wdxzf/High-Angle-Lotus-Harvester/README.md

# High-Angle-Lotus-Harvester
大角度冲刷式采收一体莲藕收获装置│机创国家二·等奖作品
