wdxzf/High-Angle-Lotus-Harvester/大角度冲刷式采收一体莲藕（视频图片PPT）/样机实物图片/样机室内模拟图.jpg

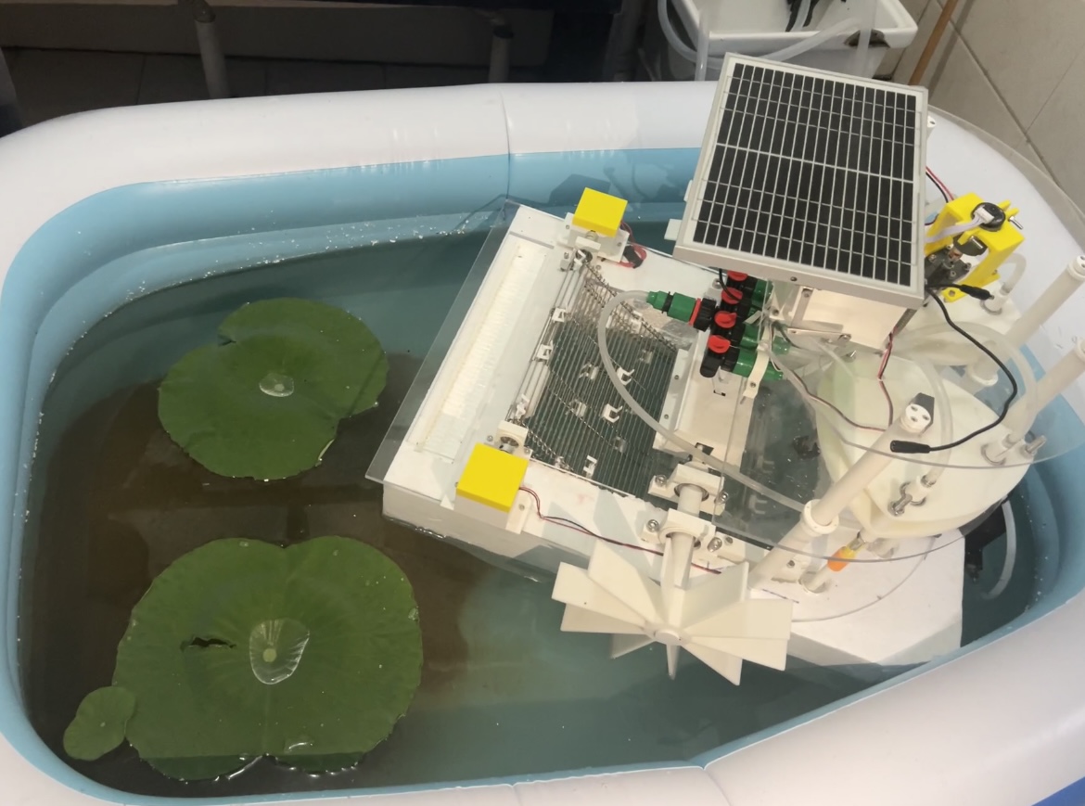
大角度冲刷式采收一体莲藕（视频图片PPT）/样机实物图片/样机室内模拟图.jpg
