wdxzf/High-Angle-Lotus-Harvester/大角度冲刷式采收一体莲藕收获装置三维/零件图/轴承盖.SLDPRT

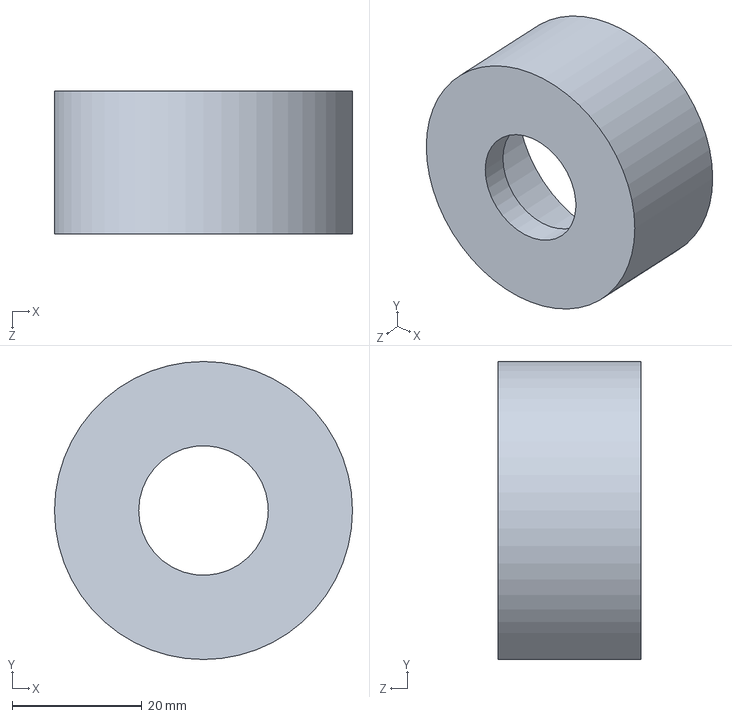
[picture p54: CAD file, 2024-09-17]
大角度冲刷式采收一体莲藕收获装置三维/零件图/轴承盖.SLDPRT
46.0 x 46.0 x 22.0 mm
