wdxzf/High-Angle-Lotus-Harvester/大角度冲刷式采收一体莲藕收获装置三维/零件图/圆柱齿轮轴改后.SLDPRT

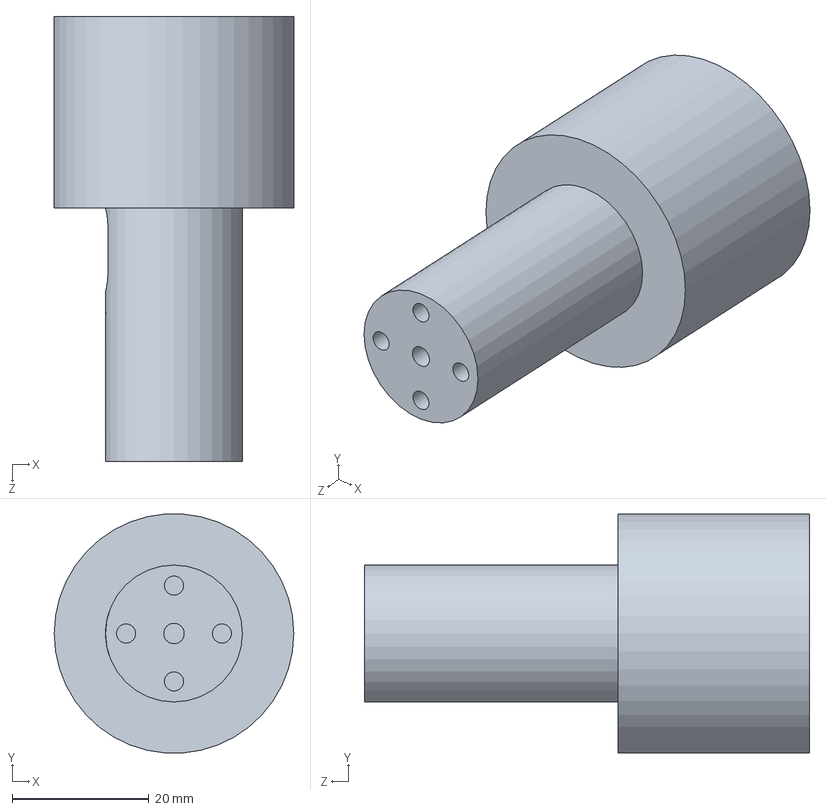
[picture p56: CAD file, 2024-09-17]
大角度冲刷式采收一体莲藕收获装置三维/零件图/圆柱齿轮轴改后.SLDPRT
35.0 x 34.9 x 65.0 mm
