wdxzf/High-Angle-Lotus-Harvester/大角度冲刷式采收一体莲藕收获装置三维/零件图/联轴器.sldprt

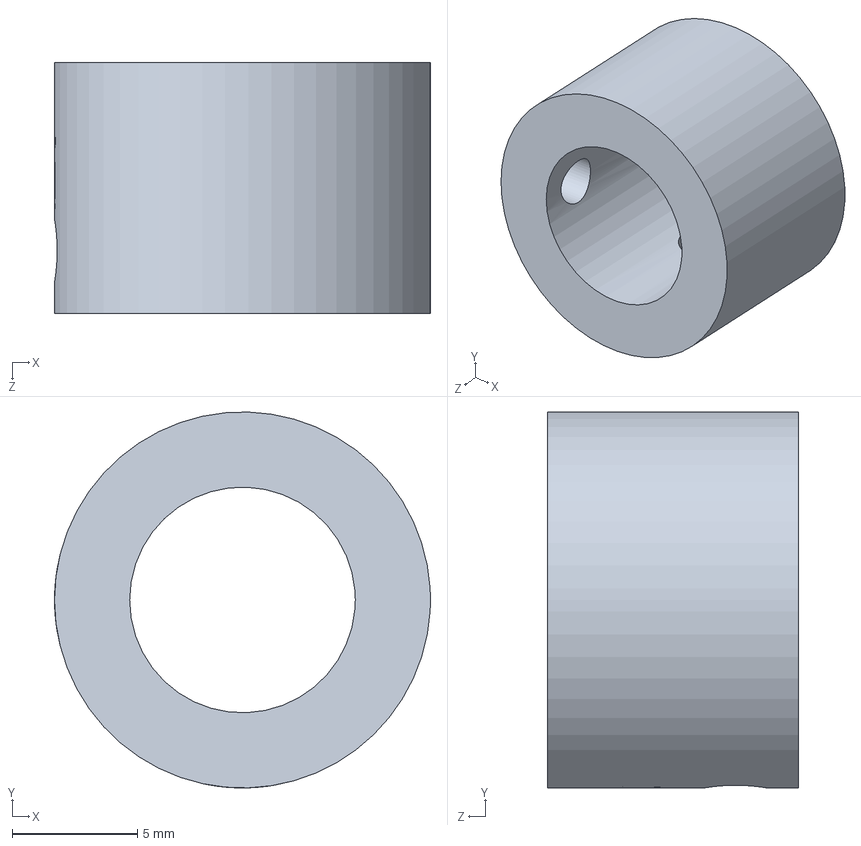
[picture p59: CAD file, 2024-09-17]
大角度冲刷式采收一体莲藕收获装置三维/零件图/联轴器.sldprt
15.0 x 15.0 x 10.0 mm
