wdxzf/High-Angle-Lotus-Harvester/大角度冲刷式采收一体莲藕收获装置三维/零件图/推拉杆轴杆.SLDPRT

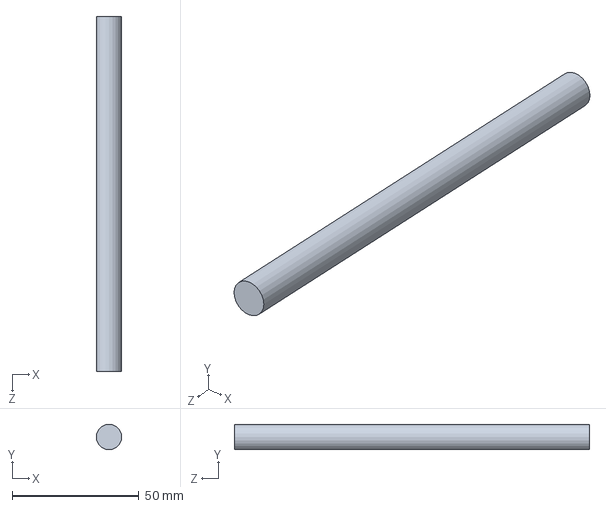
[picture p60: CAD file, 2024-09-17]
大角度冲刷式采收一体莲藕收获装置三维/零件图/推拉杆轴杆.SLDPRT
10.0 x 10.0 x 140.0 mm
