wdxzf/High-Angle-Lotus-Harvester/大角度冲刷式采收一体莲藕收获装置三维/零件图/推拉杆飞机.SLDPRT

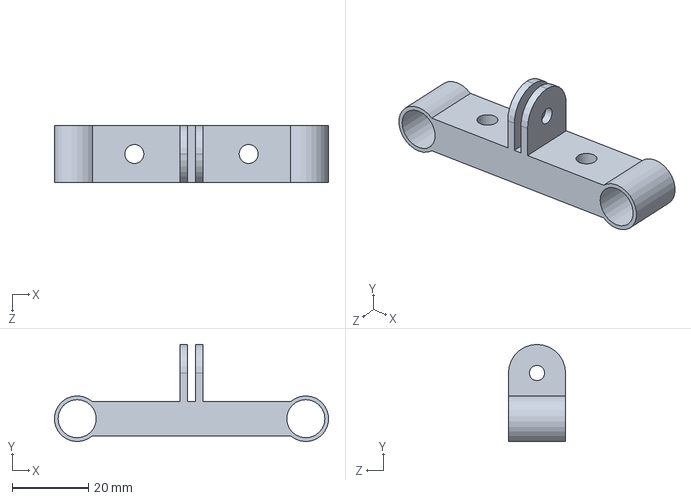
[picture p61: CAD file, 2024-09-17]
大角度冲刷式采收一体莲藕收获装置三维/零件图/推拉杆飞机.SLDPRT
71.9 x 25.5 x 15.0 mm
