wdxzf/High-Angle-Lotus-Harvester/大角度冲刷式采收一体莲藕收获装置三维/零件图/推拉杆小飞机尾翼.SLDPRT

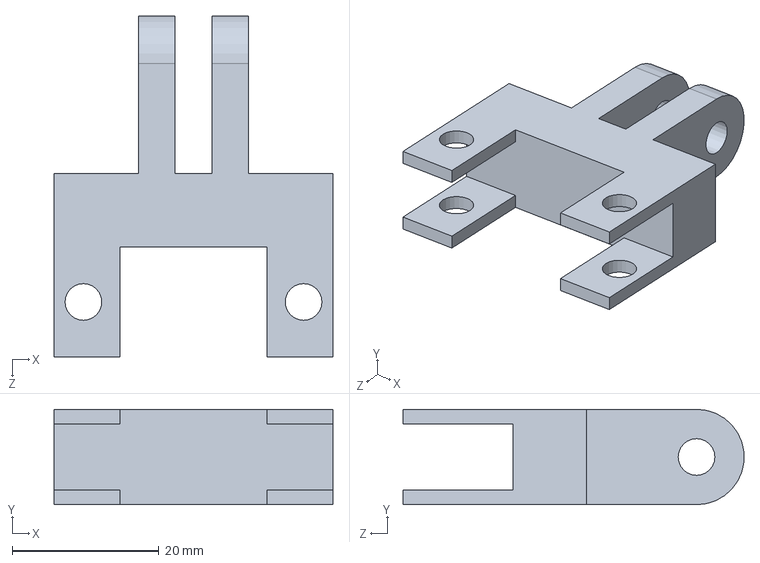
[picture p62: CAD file, 2024-09-17]
大角度冲刷式采收一体莲藕收获装置三维/零件图/推拉杆小飞机尾翼.SLDPRT
38.0 x 13.0 x 46.5 mm
