wdxzf/High-Angle-Lotus-Harvester/大角度冲刷式采收一体莲藕收获装置三维/零件图/履带传动轴.SLDPRT

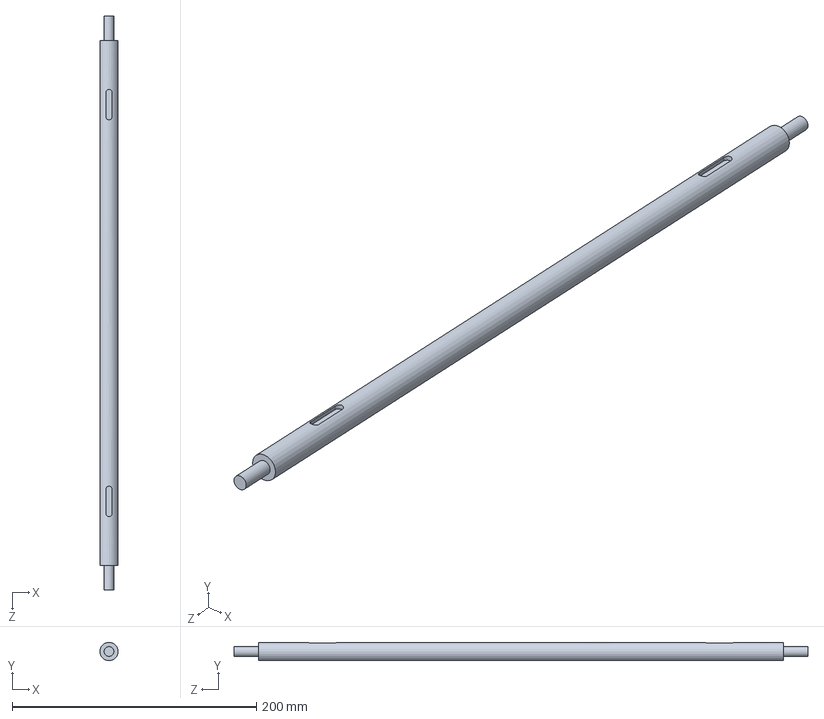
[picture p63: CAD file, 2024-09-17]
大角度冲刷式采收一体莲藕收获装置三维/零件图/履带传动轴.SLDPRT
15.0 x 15.0 x 470.0 mm
