wdxzf/High-Angle-Lotus-Harvester/大角度冲刷式采收一体莲藕收获装置三维/零件图/驱动   圆柱齿轮40×2.5.SLDPRT

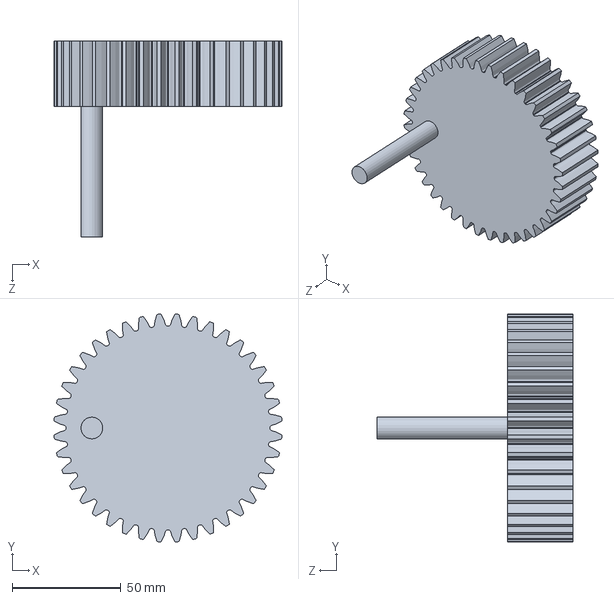
[picture p65: CAD file, 2024-09-17]
大角度冲刷式采收一体莲藕收获装置三维/零件图/驱动 圆柱齿轮40×2.5.SLDPRT
104.8 x 104.8 x 90.0 mm
