wdxzf/High-Angle-Lotus-Harvester/大角度冲刷式采收一体莲藕收获装置三维/零件图/控制板外壳左上盖.SLDPRT

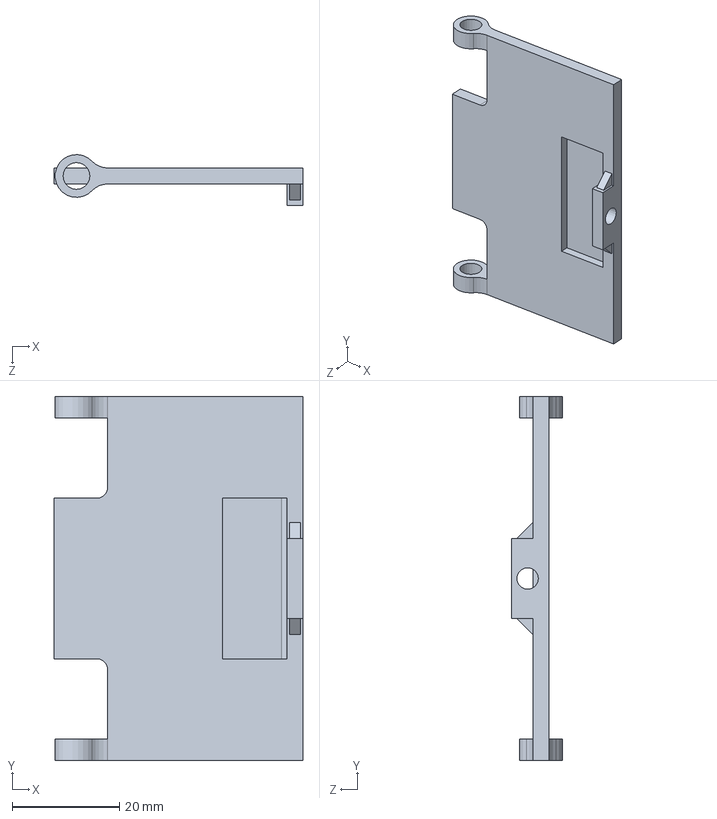
[picture p66: CAD file, 2024-09-17]
大角度冲刷式采收一体莲藕收获装置三维/零件图/控制板外壳左上盖.SLDPRT
46.5 x 68.0 x 9.49 mm
