wdxzf/High-Angle-Lotus-Harvester/大角度冲刷式采收一体莲藕收获装置三维/零件图/三脚架.SLDPRT

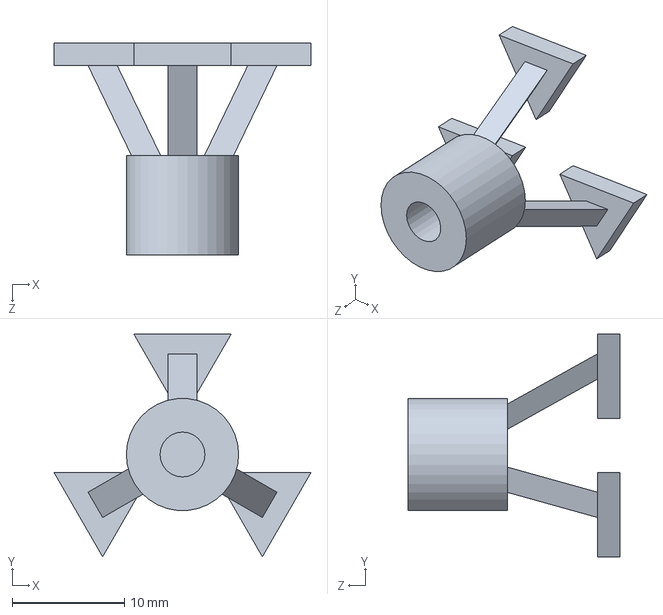
[picture p67: CAD file, 2024-09-17]
大角度冲刷式采收一体莲藕收获装置三维/零件图/三脚架.SLDPRT
22.9 x 19.8 x 18.9 mm
