wdxzf/High-Angle-Lotus-Harvester/大角度冲刷式采收一体莲藕收获装置三维/零件图/动力圆柱齿轮35×2.SLDPRT

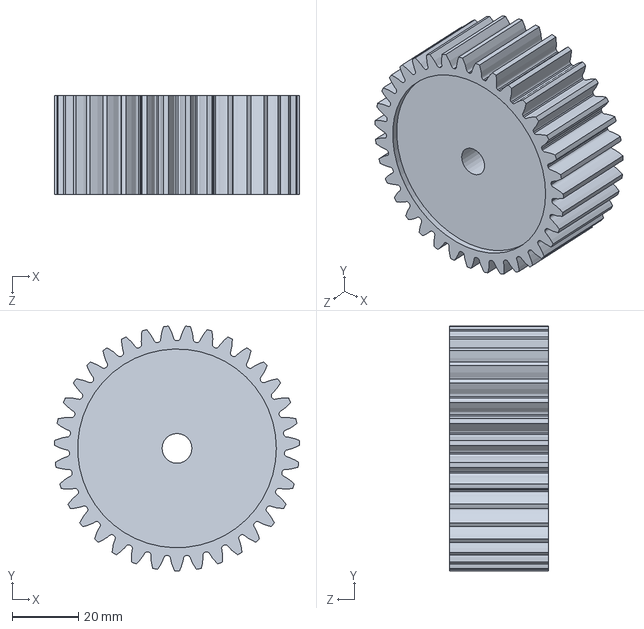
[picture p68: CAD file, 2024-09-17]
大角度冲刷式采收一体莲藕收获装置三维/零件图/动力圆柱齿轮35×2.SLDPRT
74.0 x 73.9 x 30.0 mm
