wdxzf/High-Angle-Lotus-Harvester/大角度冲刷式采收一体莲藕收获装置三维/零件图/套筒.SLDPRT

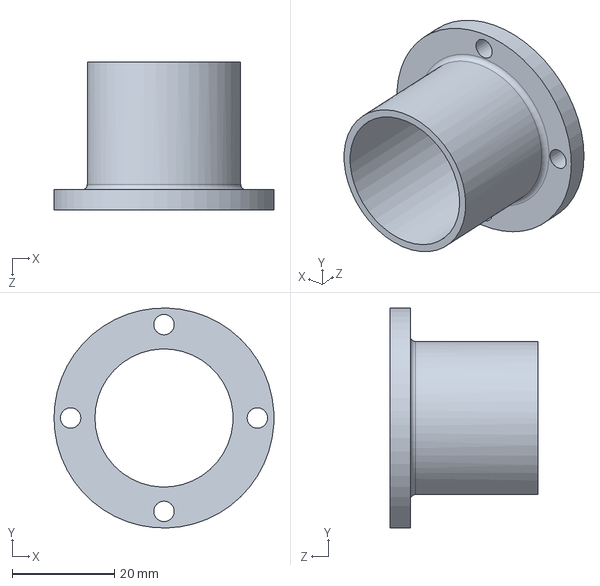
[picture p69: CAD file, 2024-09-17]
大角度冲刷式采收一体莲藕收获装置三维/零件图/套筒.SLDPRT
43.0 x 43.0 x 29.0 mm
