wdxzf/High-Angle-Lotus-Harvester/大角度冲刷式采收一体莲藕收获装置三维/零件图/直角弯头.SLDPRT

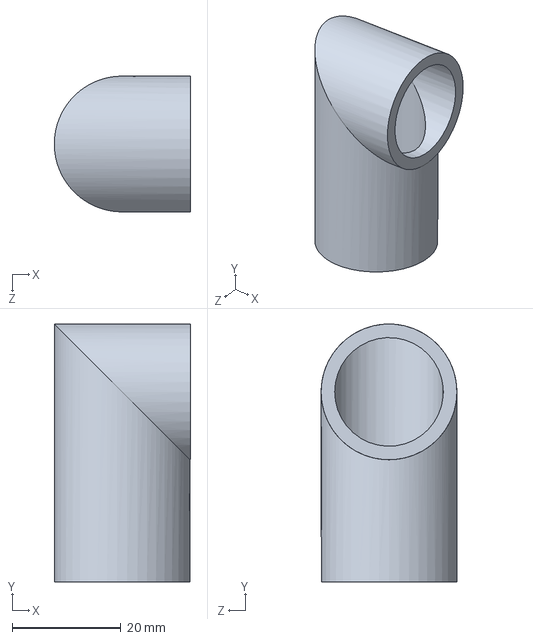
[picture p70: CAD file, 2024-09-17]
大角度冲刷式采收一体莲藕收获装置三维/零件图/直角弯头.SLDPRT
25.1 x 47.5 x 25.0 mm
