wdxzf/High-Angle-Lotus-Harvester/大角度冲刷式采收一体莲藕收获装置三维/零件图/大轮.SLDPRT

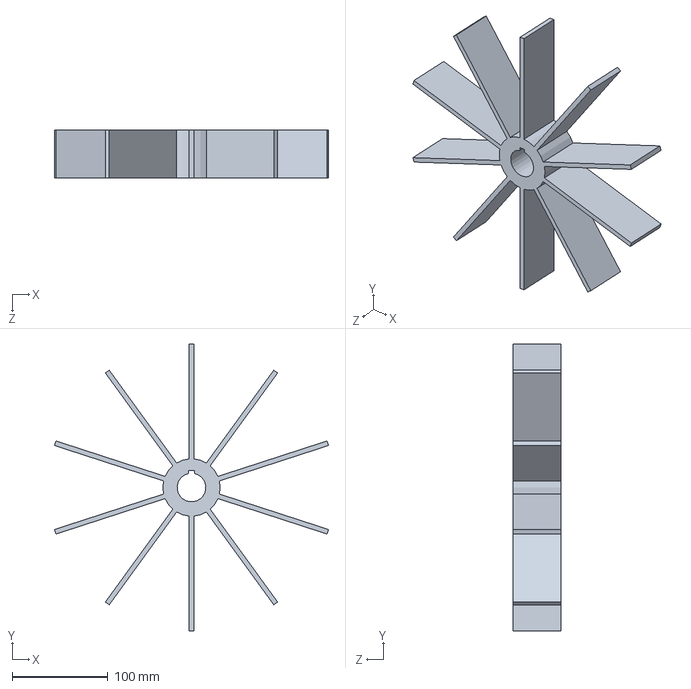
[picture p71: CAD file, 2024-09-17]
大角度冲刷式采收一体莲藕收获装置三维/零件图/大轮.SLDPRT
286.9 x 300.0 x 50.0 mm
