wdxzf/High-Angle-Lotus-Harvester/大角度冲刷式采收一体莲藕收获装置三维/零件图/6006z轴承盖.SLDPRT

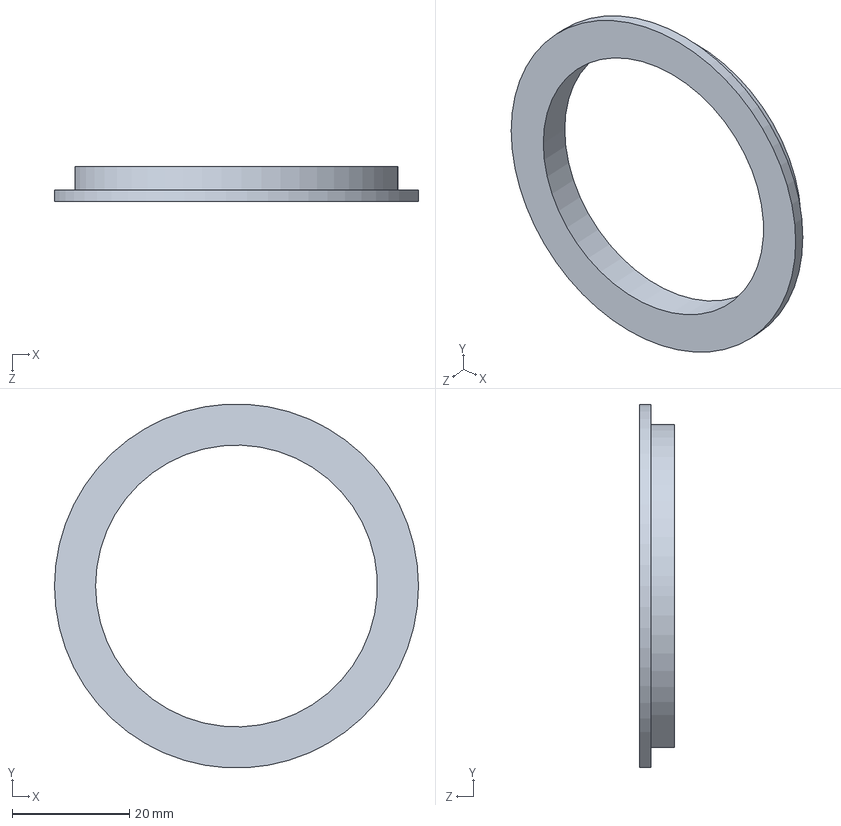
[picture p72: CAD file, 2024-09-17]
大角度冲刷式采收一体莲藕收获装置三维/零件图/6006z轴承盖.SLDPRT
62.0 x 61.9 x 6.00 mm
