wdxzf/High-Angle-Lotus-Harvester/大角度冲刷式采收一体莲藕收获装置三维/零件图/推拉杆驱动连杆.SLDPRT

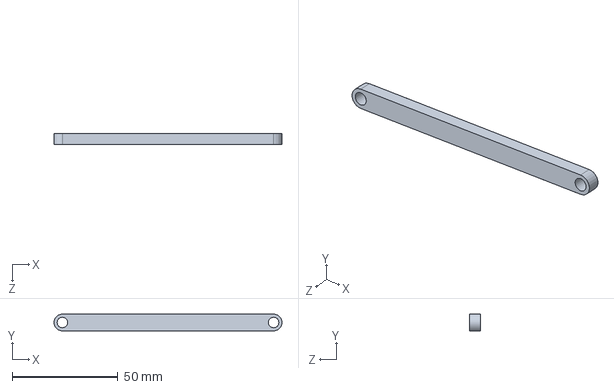
[picture p73: CAD file, 2024-09-17]
大角度冲刷式采收一体莲藕收获装置三维/零件图/推拉杆驱动连杆.SLDPRT
108.0 x 8.00 x 5.00 mm
