wdxzf/High-Angle-Lotus-Harvester/大角度冲刷式采收一体莲藕收获装置三维/零件图/圆柱齿轮25×2.5.SLDPRT

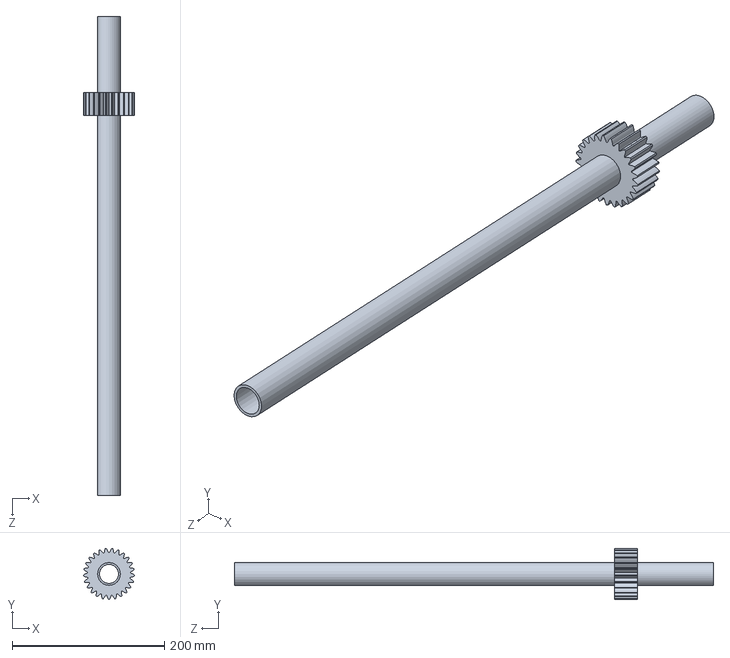
[picture p74: CAD file, 2024-09-17]
大角度冲刷式采收一体莲藕收获装置三维/零件图/圆柱齿轮25×2.5.SLDPRT
67.4 x 67.3 x 630.0 mm
