wdxzf/High-Angle-Lotus-Harvester/大角度冲刷式采收一体莲藕收获装置三维/零件图/导向板.SLDPRT

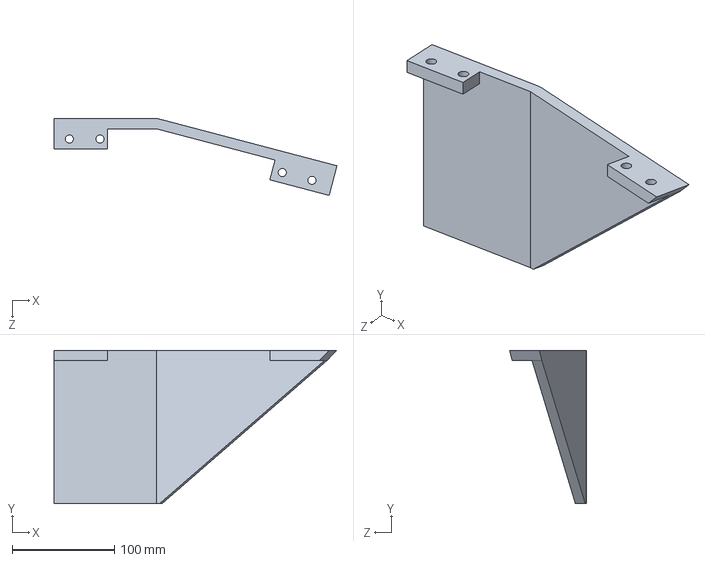
[picture p75: CAD file, 2024-09-17]
大角度冲刷式采收一体莲藕收获装置三维/零件图/导向板.SLDPRT
276.7 x 150.0 x 75.2 mm
