wdxzf/High-Angle-Lotus-Harvester/大角度冲刷式采收一体莲藕收获装置三维/零件图/蜗轮28×1.SLDPRT

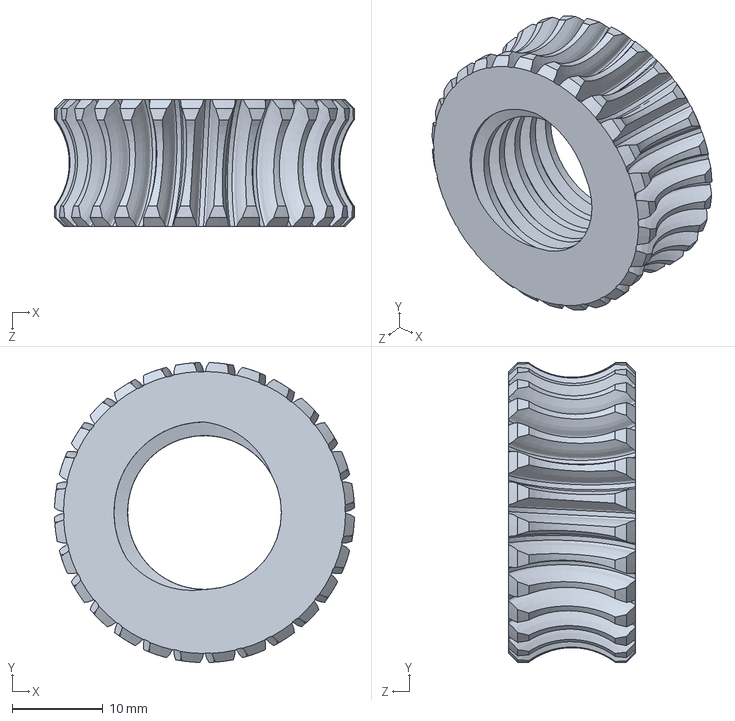
[picture p77: CAD file, 2024-09-17]
大角度冲刷式采收一体莲藕收获装置三维/零件图/蜗轮28×1.SLDPRT
33.1 x 33.1 x 14.0 mm
