wdxzf/High-Angle-Lotus-Harvester/大角度冲刷式采收一体莲藕收获装置三维/零件图/履带轴承座垫高.SLDPRT

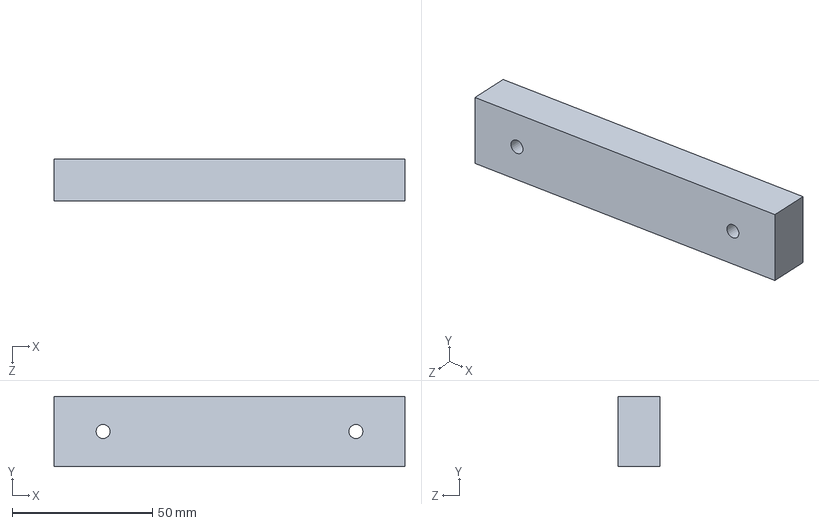
[picture p78: CAD file, 2024-09-17]
大角度冲刷式采收一体莲藕收获装置三维/零件图/履带轴承座垫高.SLDPRT
125.0 x 25.0 x 15.0 mm
