wdxzf/High-Angle-Lotus-Harvester/大角度冲刷式采收一体莲藕收获装置三维/零件图/圆柱齿轮59×2.5改.SLDPRT

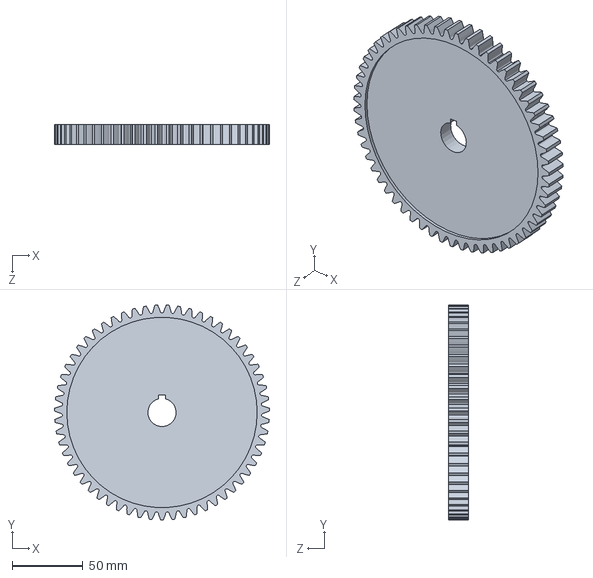
[picture p79: CAD file, 2024-09-17]
大角度冲刷式采收一体莲藕收获装置三维/零件图/圆柱齿轮59×2.5改.SLDPRT
152.5 x 152.4 x 14.0 mm
