wdxzf/High-Angle-Lotus-Harvester/大角度冲刷式采收一体莲藕收获装置三维/零件图/动力外壳.SLDPRT

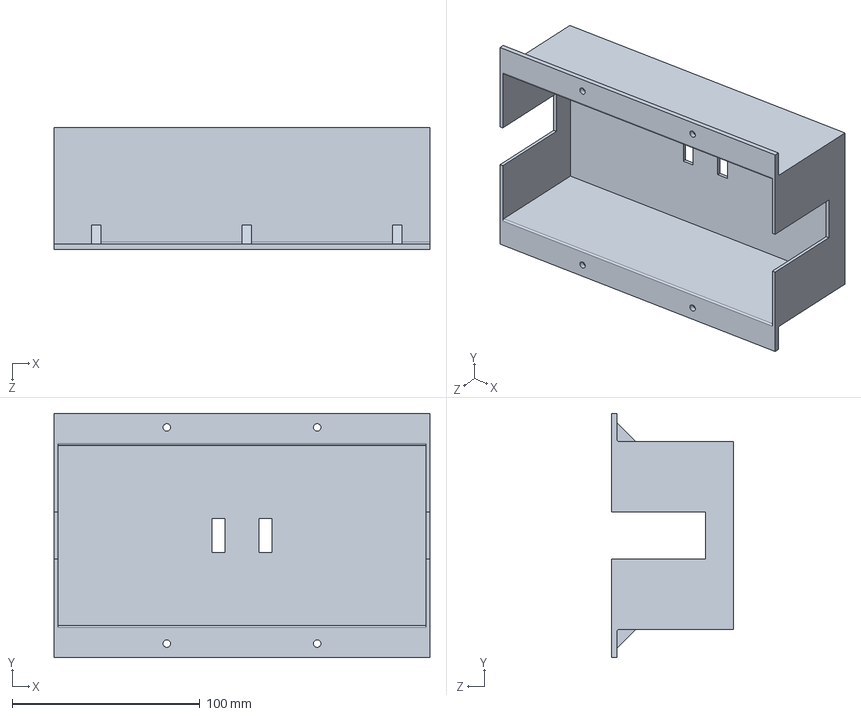
[picture p80: CAD file, 2024-09-17]
大角度冲刷式采收一体莲藕收获装置三维/零件图/动力外壳.SLDPRT
200.0 x 130.0 x 65.0 mm
