wdxzf/High-Angle-Lotus-Harvester/大角度冲刷式采收一体莲藕收获装置三维/零件图/固定台右高.SLDPRT

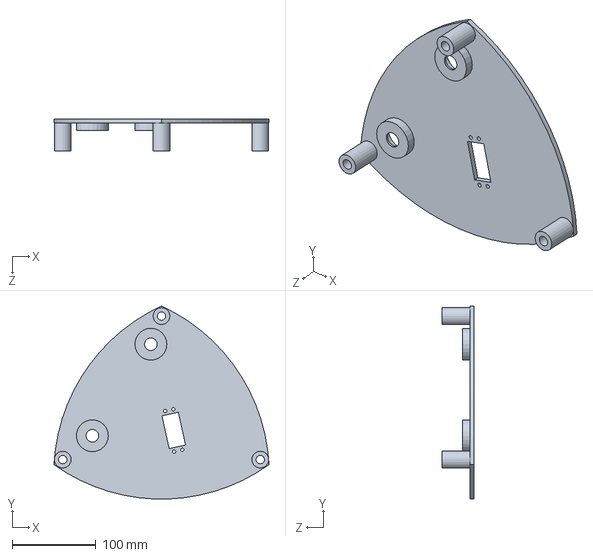
[picture p81: CAD file, 2024-09-17]
大角度冲刷式采收一体莲藕收获装置三维/零件图/固定台右高.SLDPRT
256.0 x 229.8 x 38.2 mm
