wdxzf/High-Angle-Lotus-Harvester/大角度冲刷式采收一体莲藕收获装置三维/零件图/喷管轴承.step

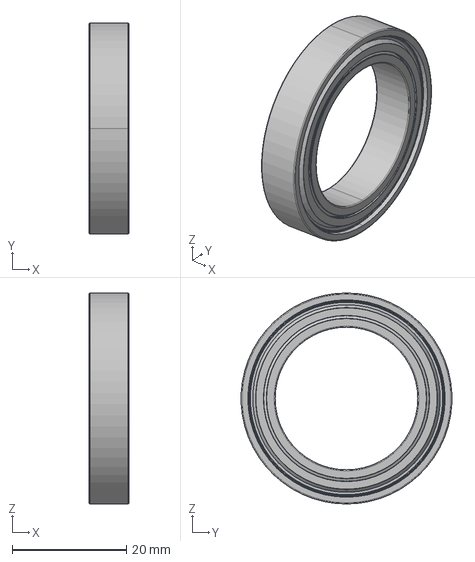
[picture p82: CAD file, 2024-09-17]
大角度冲刷式采收一体莲藕收获装置三维/零件图/喷管轴承.step
7.00 x 36.9 x 37.0 mm
