wdxzf/High-Angle-Lotus-Harvester/大角度冲刷式采收一体莲藕收获装置三维/零件图/喷管转动驱动  圆柱齿轮30×2.5.SLDPRT

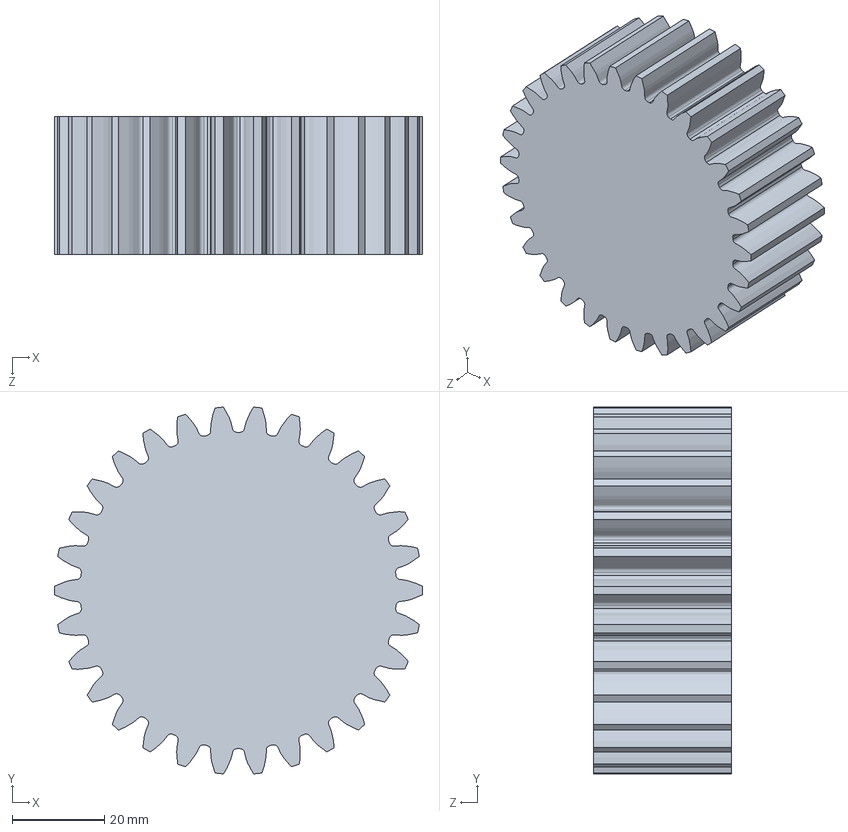
[picture p83: CAD file, 2024-09-17]
大角度冲刷式采收一体莲藕收获装置三维/零件图/喷管转动驱动 圆柱齿轮30×2.5.SLDPRT
80.0 x 79.7 x 30.0 mm
