wdxzf/High-Angle-Lotus-Harvester/大角度冲刷式采收一体莲藕收获装置三维/零件图/水管.SLDPRT

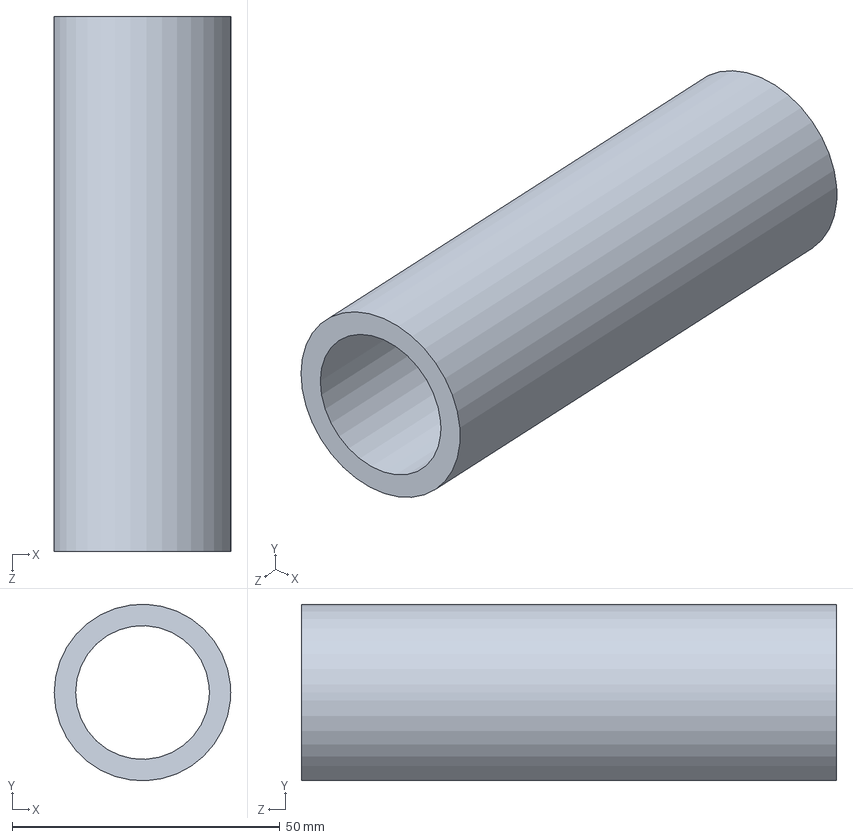
[picture p84: CAD file, 2024-09-17]
大角度冲刷式采收一体莲藕收获装置三维/零件图/水管.SLDPRT
33.0 x 33.0 x 100.0 mm
