wdxzf/High-Angle-Lotus-Harvester/大角度冲刷式采收一体莲藕收获装置三维/零件图/BCTH-M1-E-6006ZZ.step

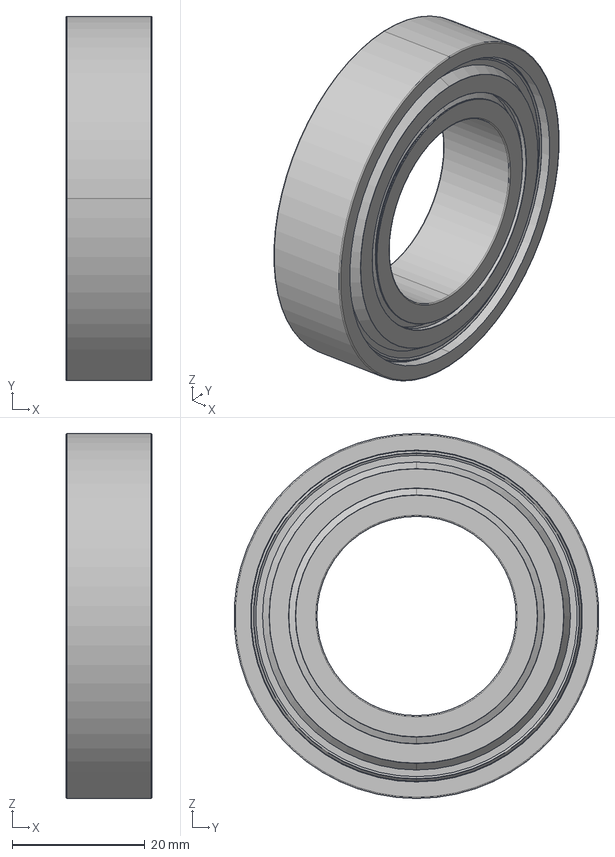
[picture p85: CAD file, 2024-09-17]
大角度冲刷式采收一体莲藕收获装置三维/零件图/BCTH-M1-E-6006ZZ.step
13.0 x 54.9 x 55.0 mm
