wdxzf/High-Angle-Lotus-Harvester/大角度冲刷式采收一体莲藕收获装置三维/零件图/舵盘.SLDPRT

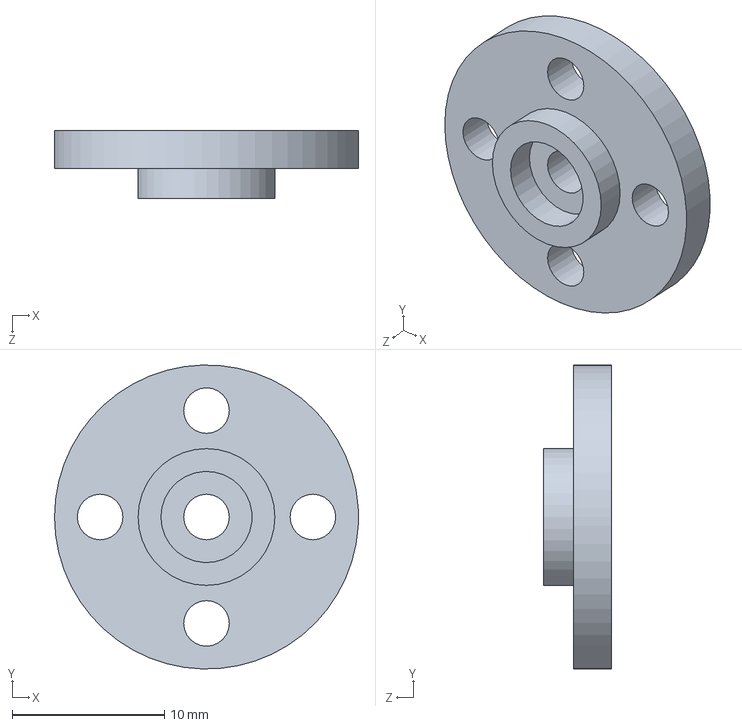
[picture p86: CAD file, 2024-09-17]
大角度冲刷式采收一体莲藕收获装置三维/零件图/舵盘.SLDPRT
20.0 x 20.0 x 4.50 mm
