wdxzf/High-Angle-Lotus-Harvester/大角度冲刷式采收一体莲藕收获装置三维/零件图/垫台.SLDPRT

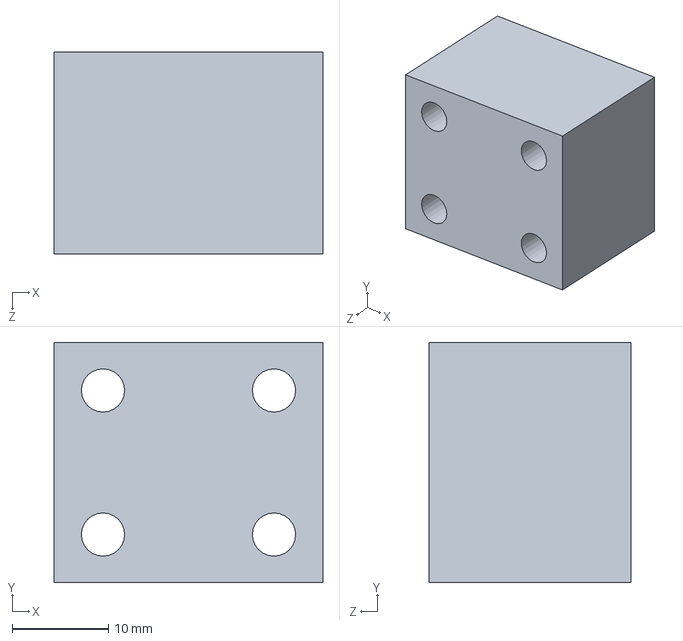
[picture p87: CAD file, 2024-09-17]
大角度冲刷式采收一体莲藕收获装置三维/零件图/垫台.SLDPRT
28.0 x 25.0 x 21.0 mm
