wdxzf/High-Angle-Lotus-Harvester/大角度冲刷式采收一体莲藕收获装置三维/零件图/推拉杆  驱动圆柱齿轮17×2.SLDPRT

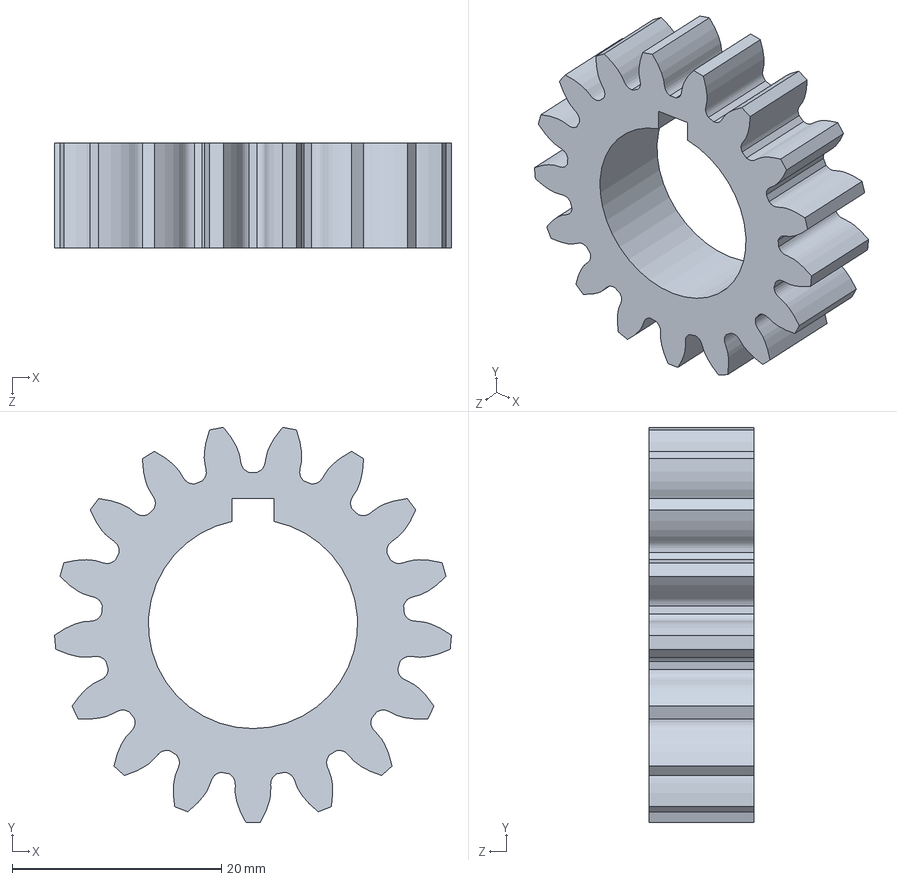
[picture p88: CAD file, 2024-09-17]
大角度冲刷式采收一体莲藕收获装置三维/零件图/推拉杆 驱动圆柱齿轮17×2.SLDPRT
37.9 x 37.8 x 10.0 mm
