wdxzf/High-Angle-Lotus-Harvester/大角度冲刷式采收一体莲藕收获装置三维/零件图/推拉杆支座.SLDPRT

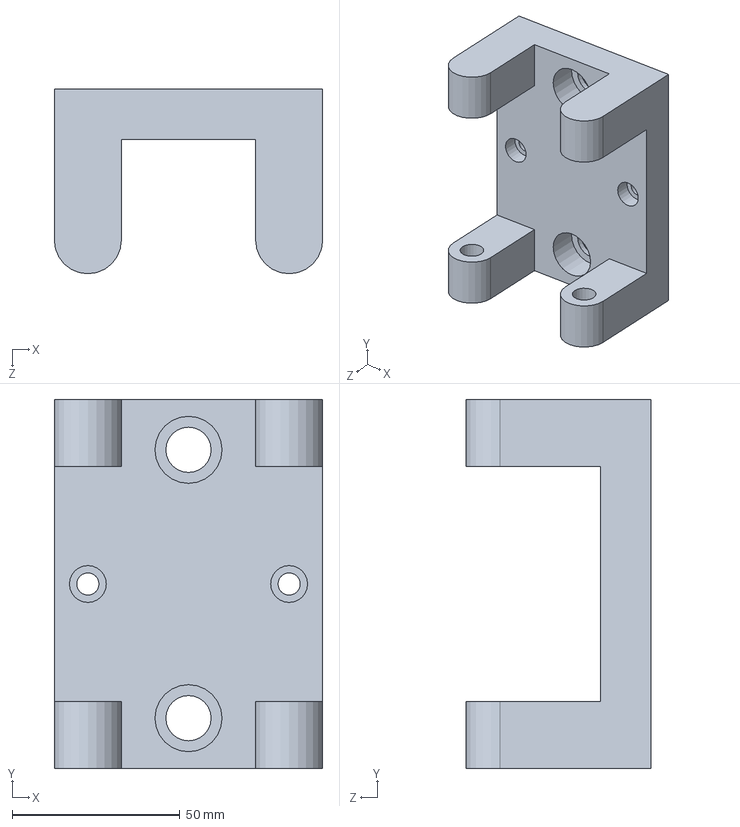
[picture p89: CAD file, 2024-09-17]
大角度冲刷式采收一体莲藕收获装置三维/零件图/推拉杆支座.SLDPRT
80.0 x 110.0 x 55.0 mm
