wdxzf/High-Angle-Lotus-Harvester/大角度冲刷式采收一体莲藕收获装置三维/零件图/直通.SLDPRT

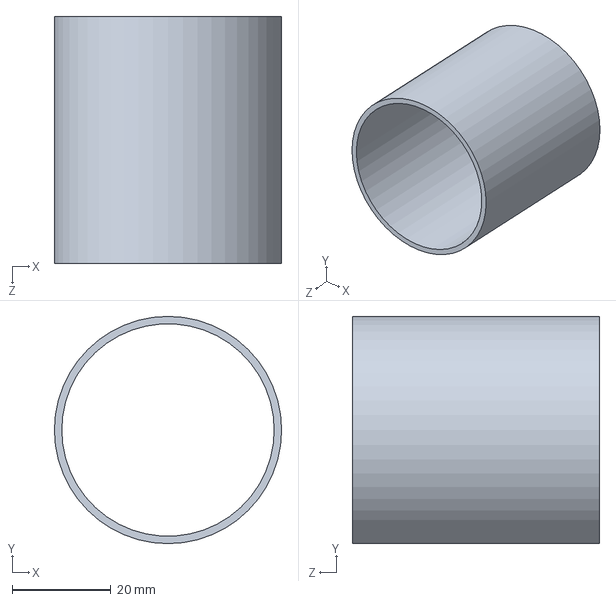
[picture p90: CAD file, 2024-09-17]
大角度冲刷式采收一体莲藕收获装置三维/零件图/直通.SLDPRT
46.0 x 46.0 x 50.0 mm
