wdxzf/High-Angle-Lotus-Harvester/大角度冲刷式采收一体莲藕收获装置三维/零件图/BCTH-M1-E-6302ZZ.step

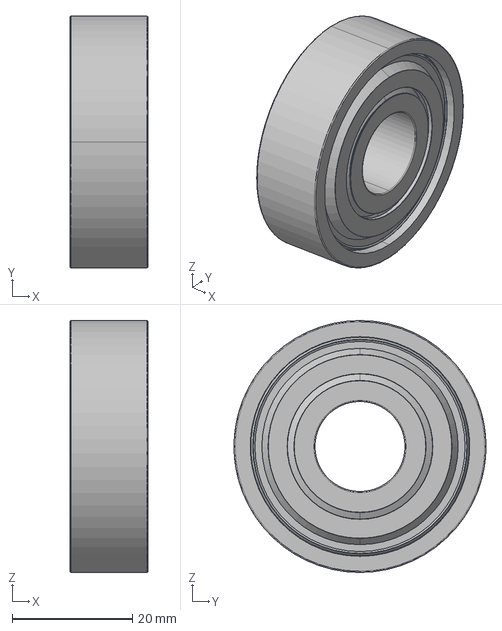
[picture p91: CAD file, 2024-09-17]
大角度冲刷式采收一体莲藕收获装置三维/零件图/BCTH-M1-E-6302ZZ.step
13.0 x 42.0 x 42.0 mm
