wdxzf/High-Angle-Lotus-Harvester/大角度冲刷式采收一体莲藕收获装置三维/零件图/穿线孔.SLDPRT

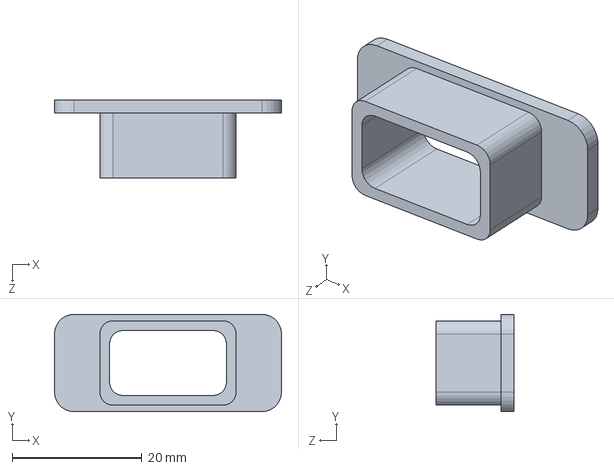
[picture p93: CAD file, 2024-09-17]
大角度冲刷式采收一体莲藕收获装置三维/零件图/穿线孔.SLDPRT
35.0 x 15.0 x 12.0 mm
