wdxzf/High-Angle-Lotus-Harvester/大角度冲刷式采收一体莲藕收获装置三维/零件图/动力电机座下.SLDPRT

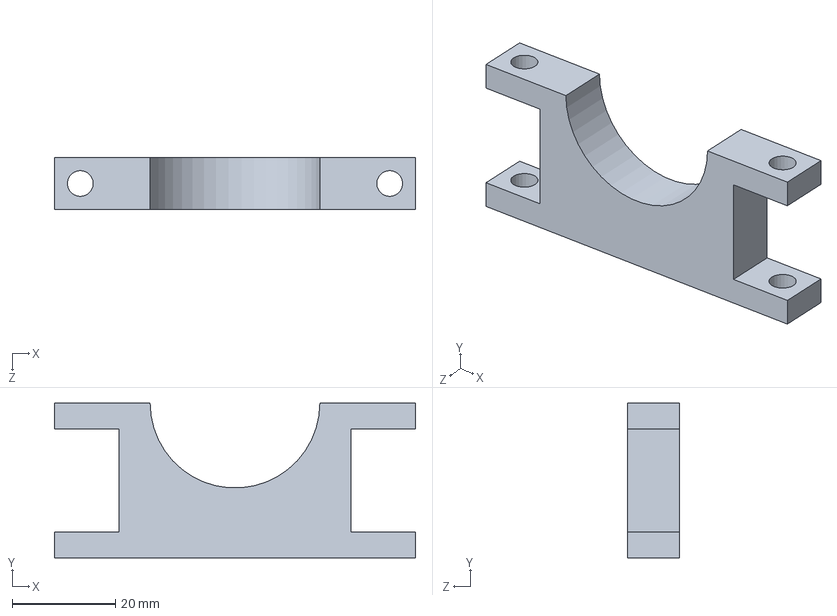
[picture p94: CAD file, 2024-09-17]
大角度冲刷式采收一体莲藕收获装置三维/零件图/动力电机座下.SLDPRT
70.0 x 30.0 x 10.0 mm
