wdxzf/High-Angle-Lotus-Harvester/大角度冲刷式采收一体莲藕收获装置三维/零件图/履带电机右外壳.SLDPRT

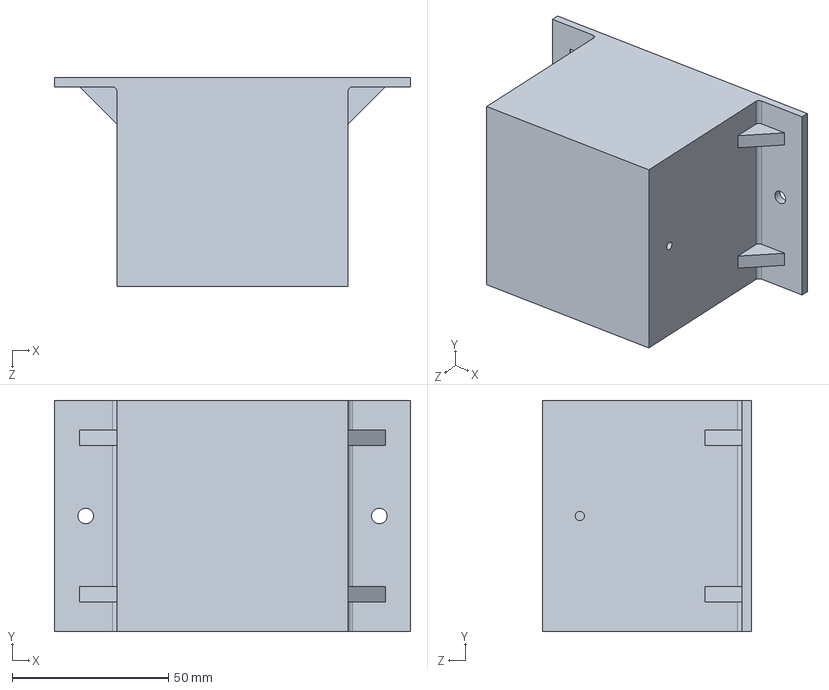
[picture p95: CAD file, 2024-09-17]
大角度冲刷式采收一体莲藕收获装置三维/零件图/履带电机右外壳.SLDPRT
114.0 x 74.0 x 67.0 mm
