wdxzf/High-Angle-Lotus-Harvester/大角度冲刷式采收一体莲藕收获装置三维/零件图/水泵支架上6.SLDPRT

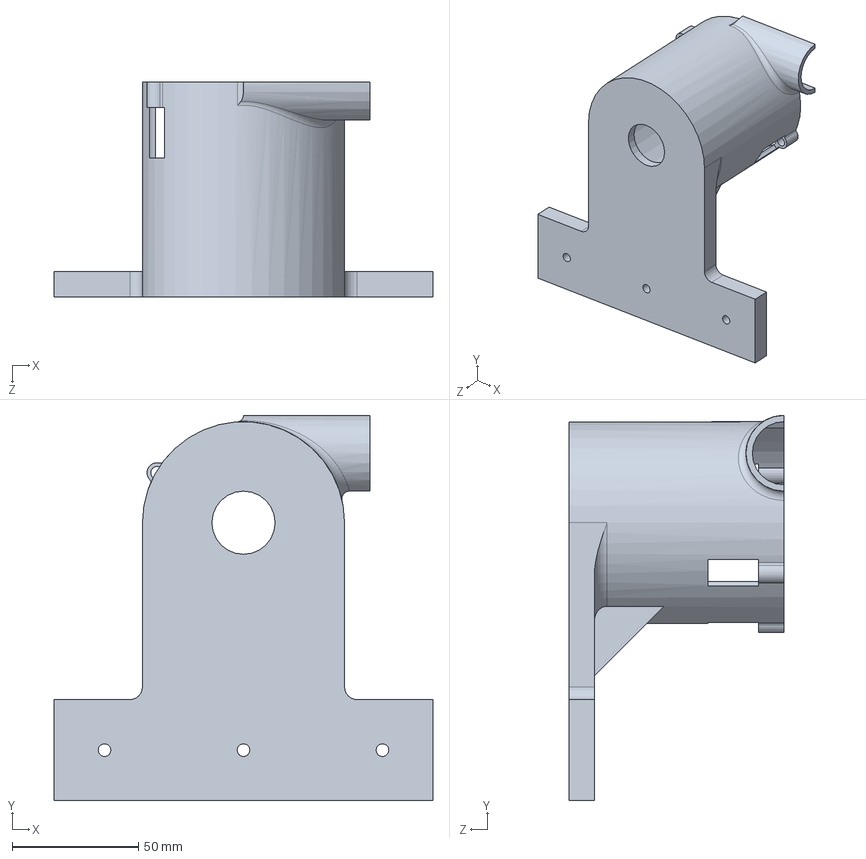
[picture p96: CAD file, 2024-09-17]
大角度冲刷式采收一体莲藕收获装置三维/零件图/水泵支架上6.SLDPRT
150.0 x 152.5 x 85.0 mm
