wdxzf/High-Angle-Lotus-Harvester/大角度冲刷式采收一体莲藕收获装置三维/零件图/履带1.SLDPRT

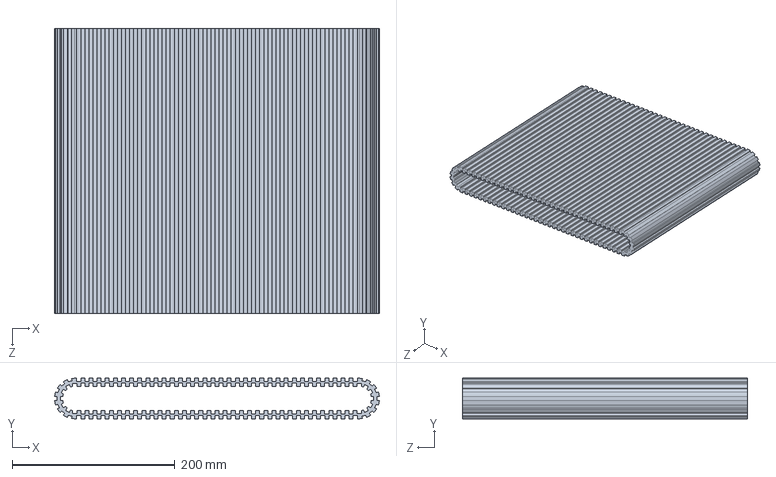
[picture p97: CAD file, 2024-09-17]
大角度冲刷式采收一体莲藕收获装置三维/零件图/履带1.SLDPRT
399.7 x 50.0 x 350.0 mm
