wdxzf/High-Angle-Lotus-Harvester/大角度冲刷式采收一体莲藕收获装置三维/零件图/长6002z轴承盖.SLDPRT

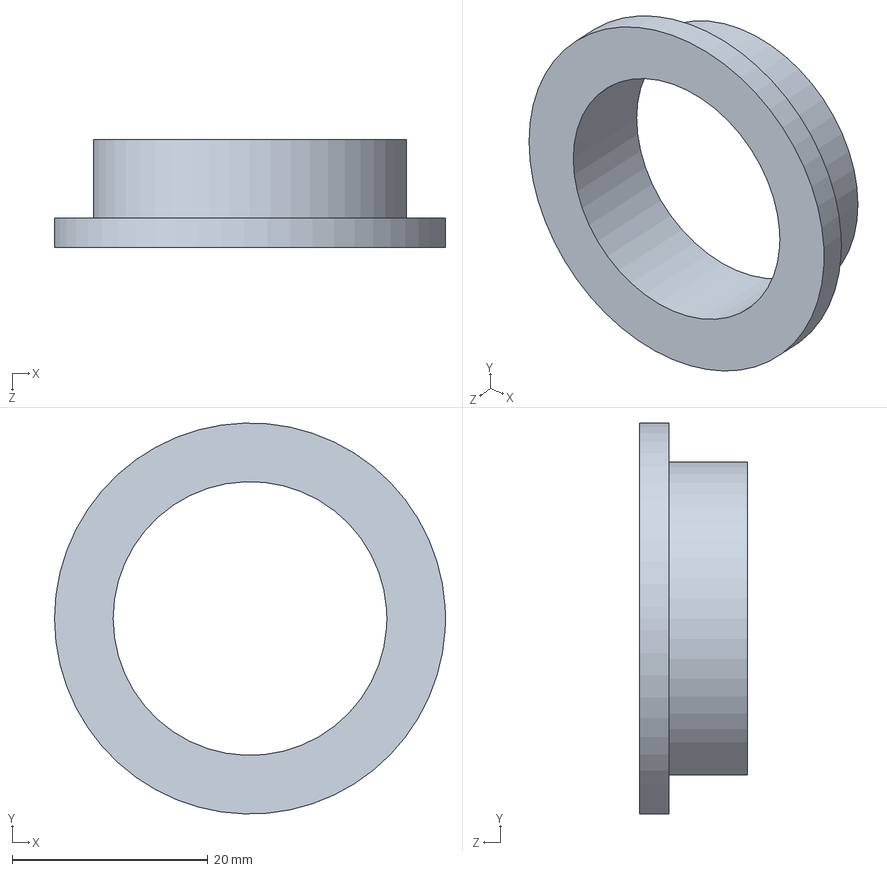
[picture p98: CAD file, 2024-09-17]
大角度冲刷式采收一体莲藕收获装置三维/零件图/长6002z轴承盖.SLDPRT
40.0 x 40.0 x 11.0 mm
