wdxzf/High-Angle-Lotus-Harvester/大角度冲刷式采收一体莲藕收获装置三维/零件图/主动轮  圆柱齿轮30×2.SLDPRT

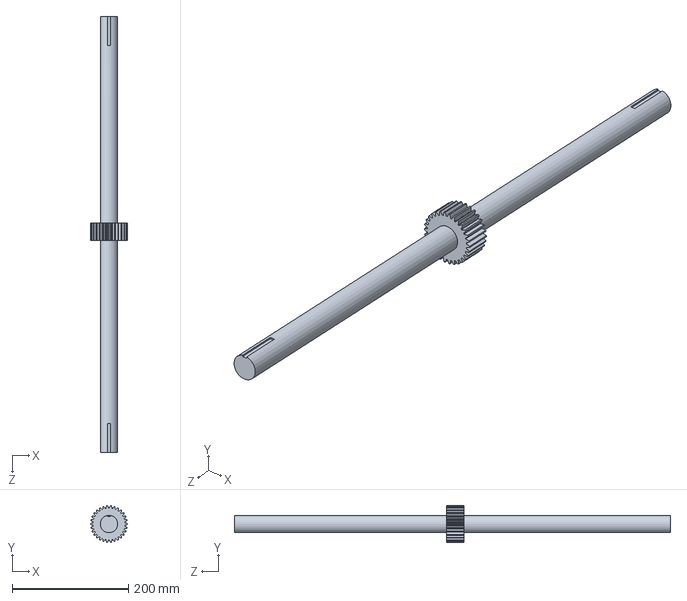
[picture p99: CAD file, 2024-09-17]
大角度冲刷式采收一体莲藕收获装置三维/零件图/主动轮 圆柱齿轮30×2.SLDPRT
64.0 x 63.8 x 750.0 mm
