wdxzf/High-Angle-Lotus-Harvester/大角度冲刷式采收一体莲藕收获装置三维/零件图/喷管连接头.SLDPRT

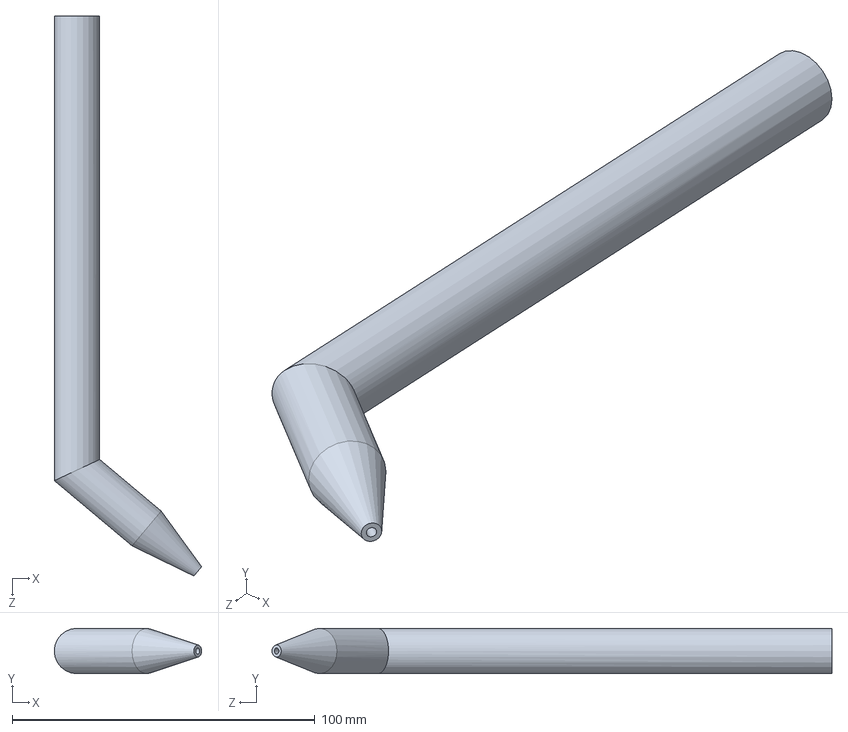
[picture p100: CAD file, 2024-09-17]
大角度冲刷式采收一体莲藕收获装置三维/零件图/喷管连接头.SLDPRT
48.7 x 15.0 x 185.0 mm
