wdxzf/High-Angle-Lotus-Harvester/大角度冲刷式采收一体莲藕收获装置三维/零件图/采藕机外壳.SLDPRT

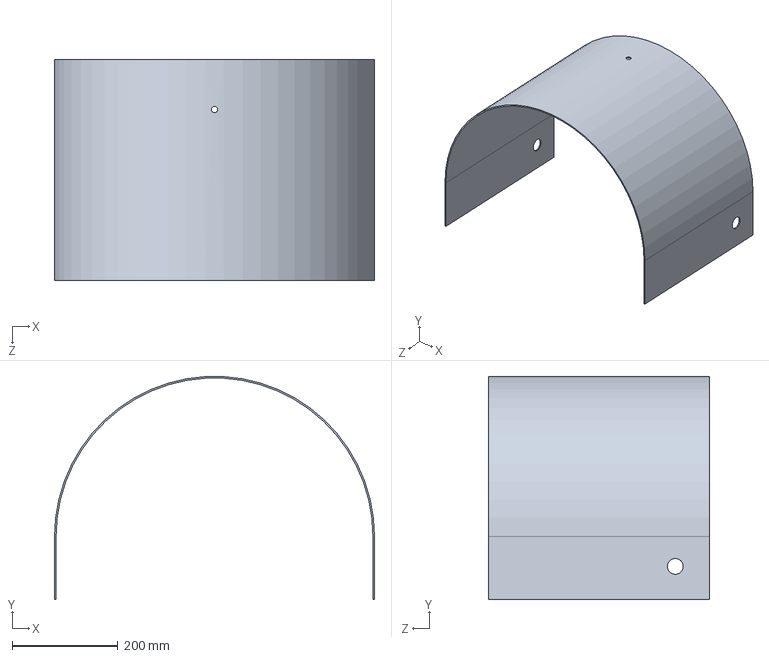
[picture p101: CAD file, 2024-09-17]
大角度冲刷式采收一体莲藕收获装置三维/零件图/采藕机外壳.SLDPRT
606.0 x 423.0 x 419.0 mm
