wdxzf/High-Angle-Lotus-Harvester/大角度冲刷式采收一体莲藕收获装置三维/零件图/短接头.SLDPRT

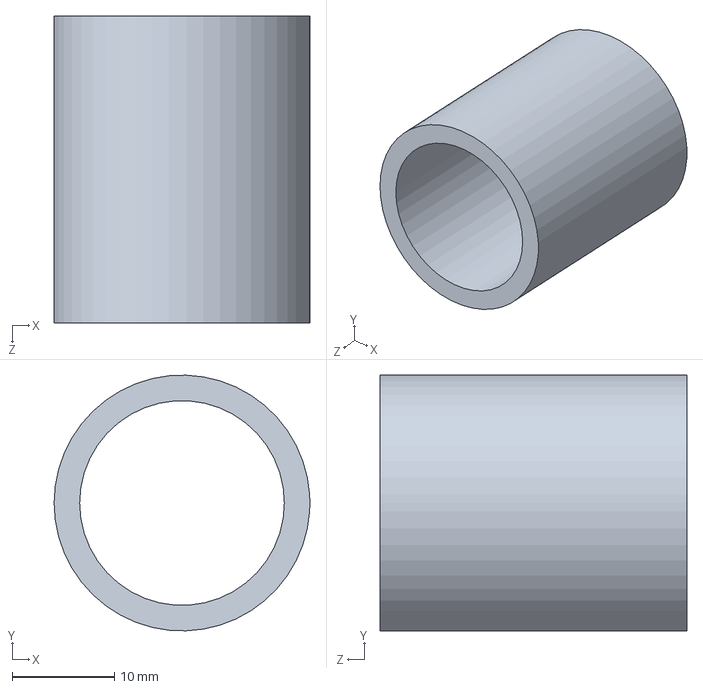
[picture p102: CAD file, 2024-09-17]
大角度冲刷式采收一体莲藕收获装置三维/零件图/短接头.SLDPRT
25.0 x 25.0 x 30.0 mm
