wdxzf/High-Angle-Lotus-Harvester/大角度冲刷式采收一体莲藕收获装置三维/零件图/外壳.sldprt

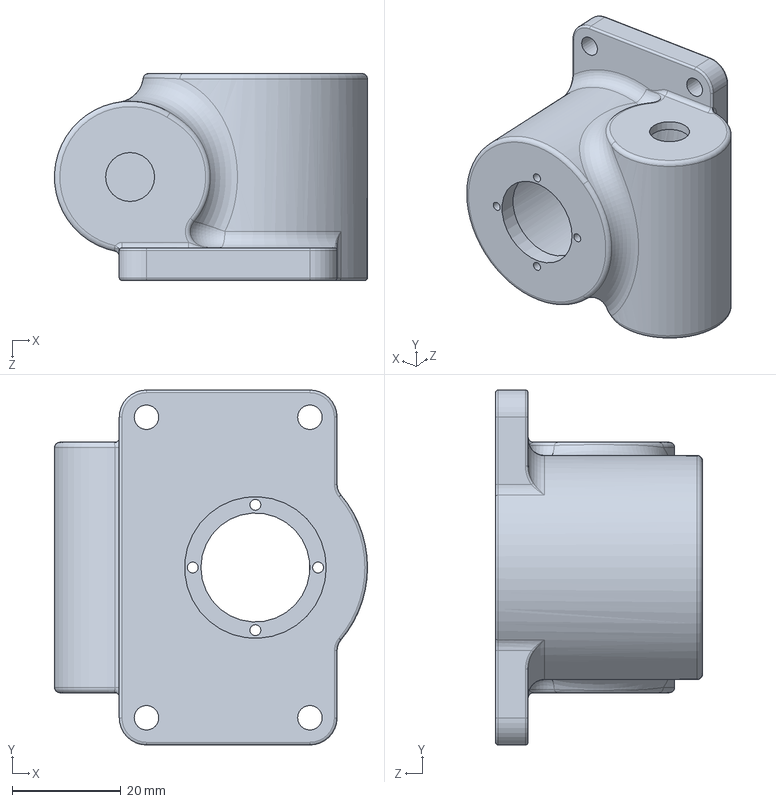
[picture p104: CAD file, 2024-09-17]
大角度冲刷式采收一体莲藕收获装置三维/零件图/外壳.sldprt
57.5 x 65.2 x 38.0 mm
