wdxzf/High-Angle-Lotus-Harvester/大角度冲刷式采收一体莲藕收获装置三维/零件图/电机支座.SLDPRT

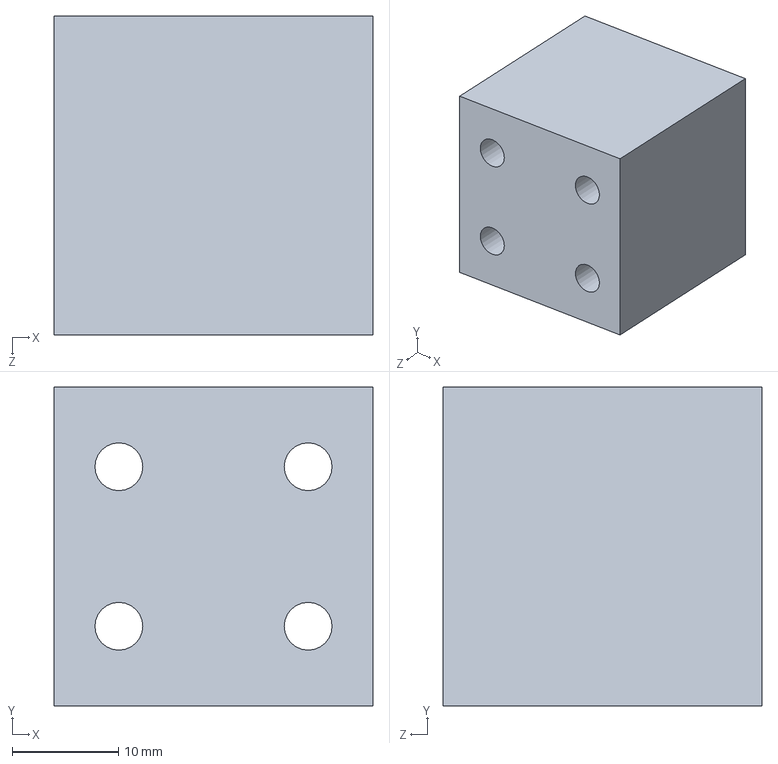
[picture p105: CAD file, 2024-09-17]
大角度冲刷式采收一体莲藕收获装置三维/零件图/电机支座.SLDPRT
30.0 x 30.0 x 30.0 mm
