wdxzf/High-Angle-Lotus-Harvester/大角度冲刷式采收一体莲藕收获装置三维/零件图/左曲挡板.SLDPRT

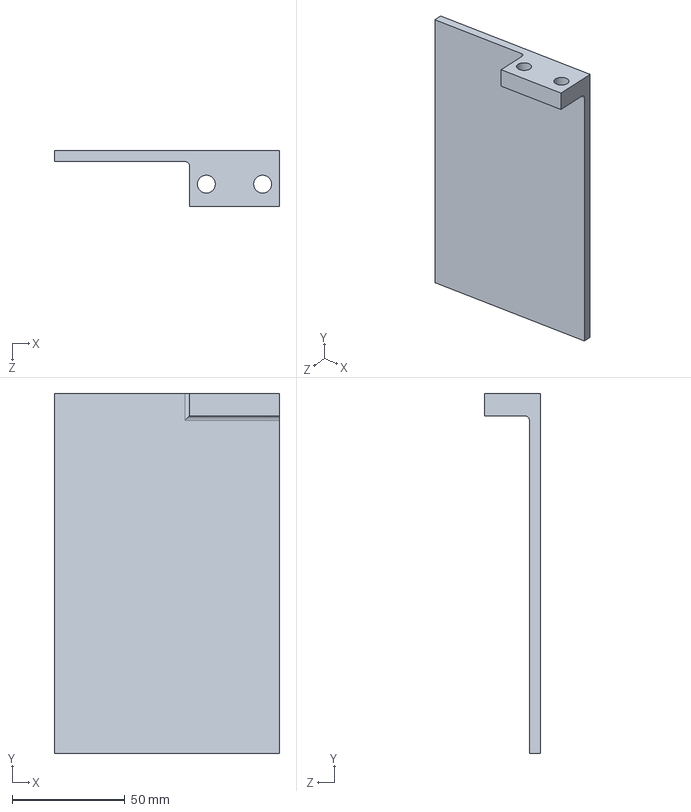
[picture p106: CAD file, 2024-09-17]
大角度冲刷式采收一体莲藕收获装置三维/零件图/左曲挡板.SLDPRT
100.0 x 160.0 x 25.0 mm
