wdxzf/High-Angle-Lotus-Harvester/大角度冲刷式采收一体莲藕收获装置三维/零件图/推拉杆小肖.SLDPRT

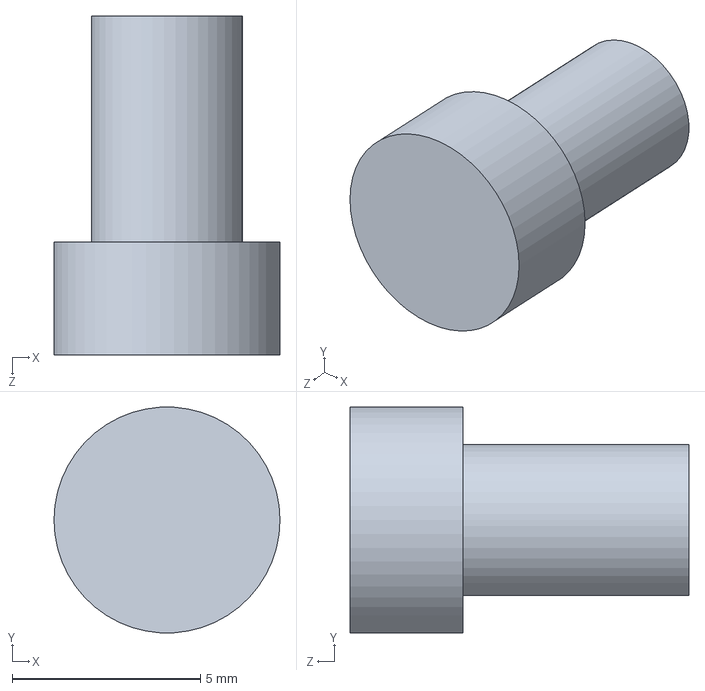
[picture p107: CAD file, 2024-09-17]
大角度冲刷式采收一体莲藕收获装置三维/零件图/推拉杆小肖.SLDPRT
6.00 x 5.99 x 9.00 mm
