wdxzf/High-Angle-Lotus-Harvester/大角度冲刷式采收一体莲藕收获装置三维/零件图/履带.SLDPRT

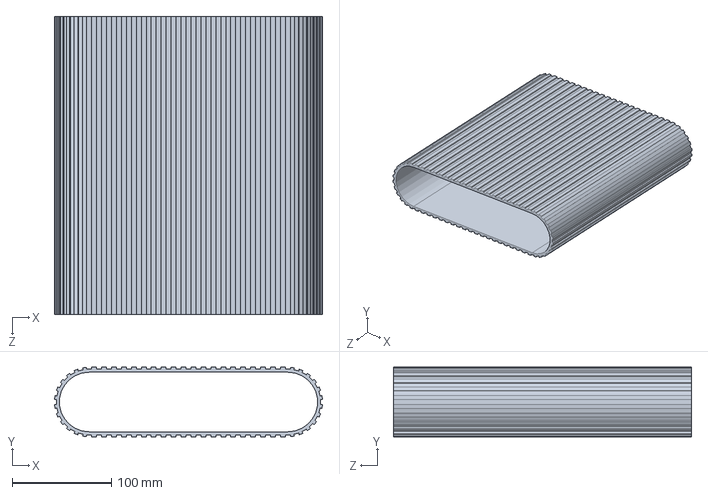
[picture p108: CAD file, 2024-09-17]
大角度冲刷式采收一体莲藕收获装置三维/零件图/履带.SLDPRT
269.8 x 70.0 x 300.0 mm
