wdxzf/High-Angle-Lotus-Harvester/大角度冲刷式采收一体莲藕收获装置三维/零件图/135度弯.SLDPRT

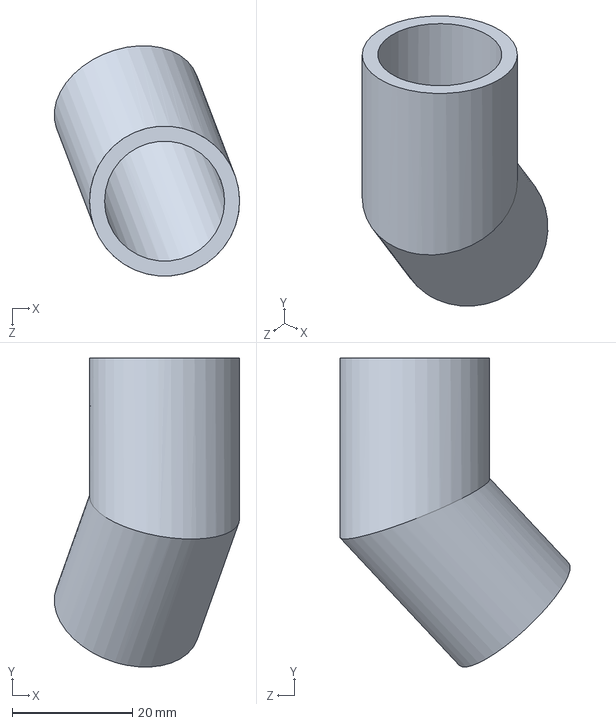
[picture p109: CAD file, 2024-09-17]
大角度冲刷式采收一体莲藕收获装置三维/零件图/135度弯.SLDPRT
30.9 x 51.5 x 38.4 mm
