wdxzf/High-Angle-Lotus-Harvester/大角度冲刷式采收一体莲藕收获装置三维/零件图/370电机座.SLDPRT

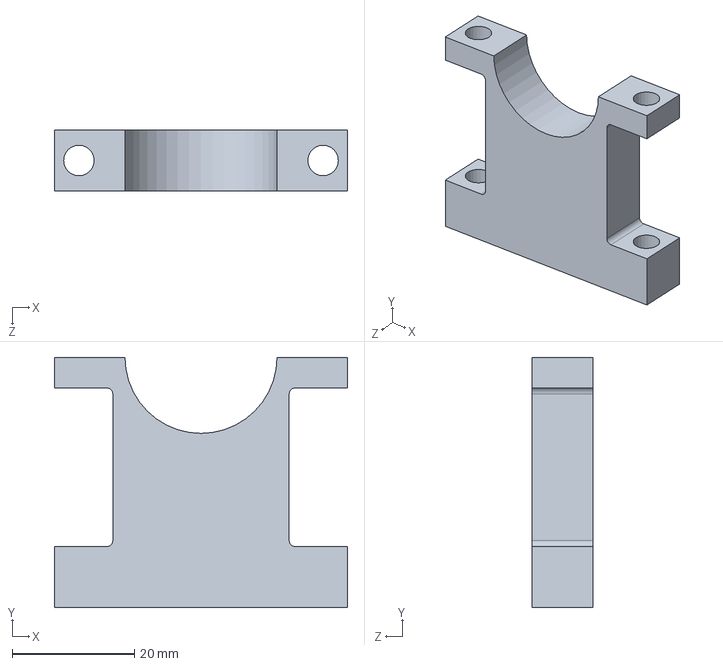
[picture p110: CAD file, 2024-09-17]
大角度冲刷式采收一体莲藕收获装置三维/零件图/370电机座.SLDPRT
48.0 x 41.0 x 10.0 mm
