wdxzf/High-Angle-Lotus-Harvester/大角度冲刷式采收一体莲藕收获装置三维/零件图/三通.SLDPRT

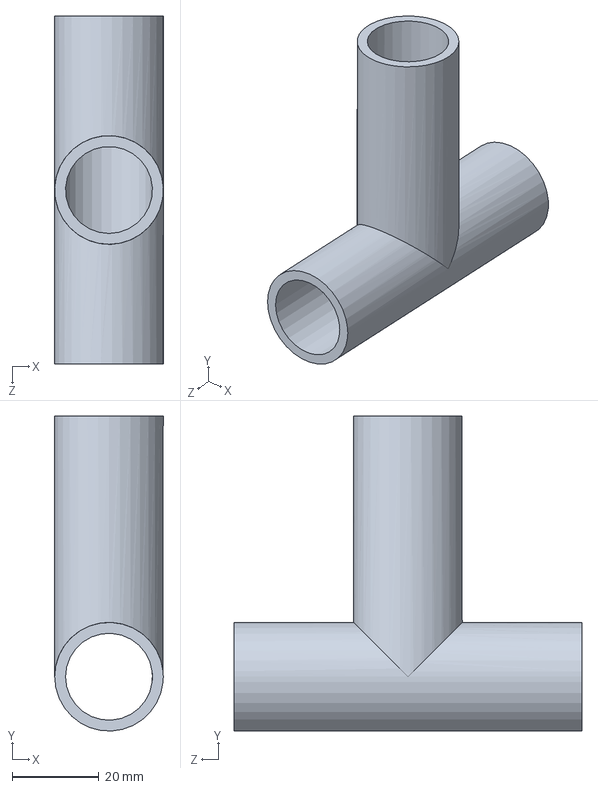
[picture p111: CAD file, 2024-09-17]
大角度冲刷式采收一体莲藕收获装置三维/零件图/三通.SLDPRT
25.0 x 72.5 x 80.0 mm
