wdxzf/High-Angle-Lotus-Harvester/大角度冲刷式采收一体莲藕收获装置三维/零件图/BCTH-M1-E-6002ZZ.step

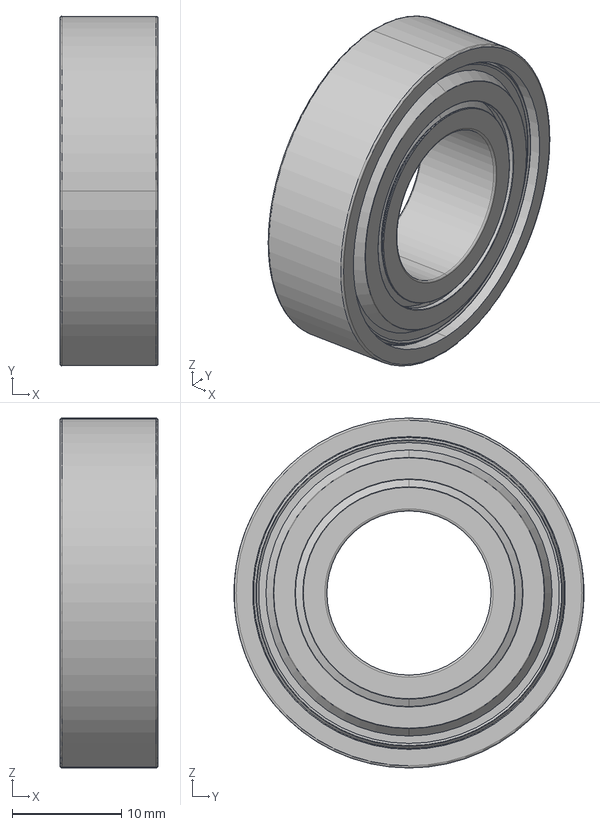
[picture p112: CAD file, 2024-09-17]
大角度冲刷式采收一体莲藕收获装置三维/零件图/BCTH-M1-E-6002ZZ.step
9.00 x 32.0 x 32.0 mm
