wdxzf/High-Angle-Lotus-Harvester/大角度冲刷式采收一体莲藕收获装置三维/零件图/推拉杆十字轴.SLDPRT

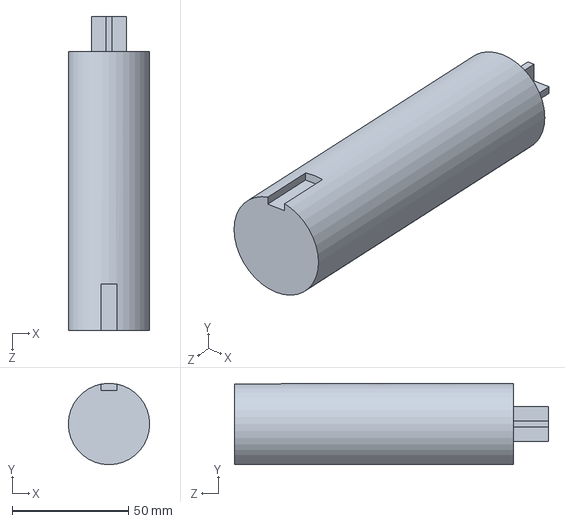
[picture p113: CAD file, 2024-09-17]
大角度冲刷式采收一体莲藕收获装置三维/零件图/推拉杆十字轴.SLDPRT
35.0 x 35.0 x 135.0 mm
