wdxzf/High-Angle-Lotus-Harvester/大角度冲刷式采收一体莲藕收获装置三维/零件图/顶部垫片.SLDPRT

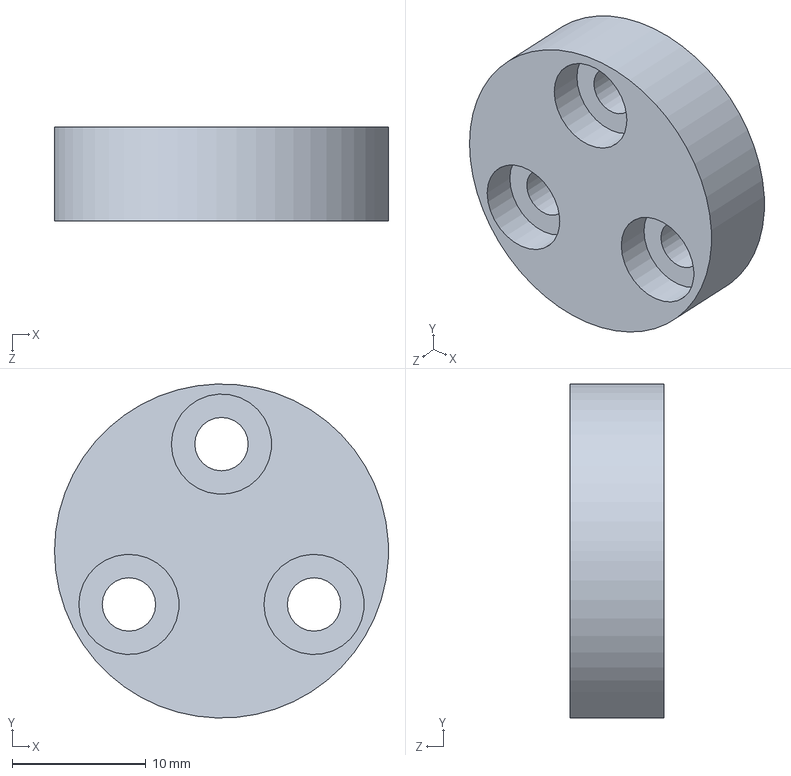
[picture p114: CAD file, 2024-09-17]
大角度冲刷式采收一体莲藕收获装置三维/零件图/顶部垫片.SLDPRT
25.0 x 25.0 x 7.00 mm
