wdxzf/High-Angle-Lotus-Harvester/大角度冲刷式采收一体莲藕收获装置三维/零件图/舵机.SLDPRT

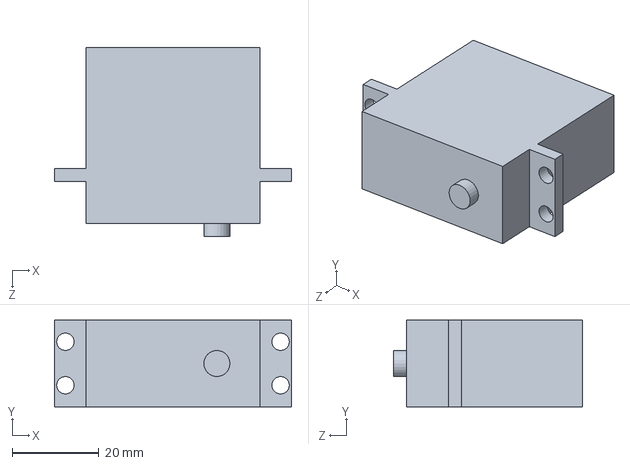
[picture p115: CAD file, 2024-09-17]
大角度冲刷式采收一体莲藕收获装置三维/零件图/舵机.SLDPRT
54.5 x 20.0 x 43.5 mm
