wdxzf/High-Angle-Lotus-Harvester/大角度冲刷式采收一体莲藕收获装置三维/零件图/顶部电机垫片.SLDPRT

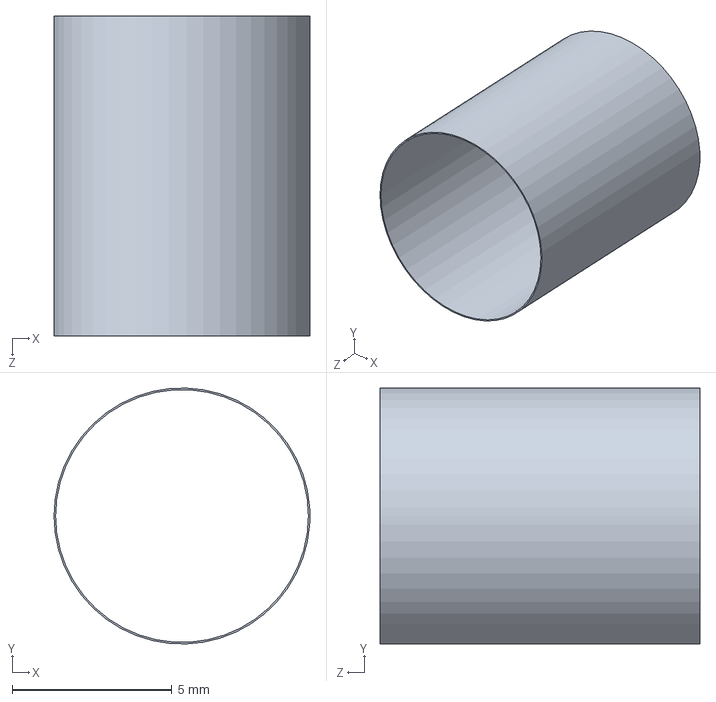
[picture p116: CAD file, 2024-09-17]
大角度冲刷式采收一体莲藕收获装置三维/零件图/顶部电机垫片.SLDPRT
8.00 x 8.00 x 10.0 mm
