wdxzf/High-Angle-Lotus-Harvester/大角度冲刷式采收一体莲藕收获装置三维/零件图/丝杆中座.SLDPRT

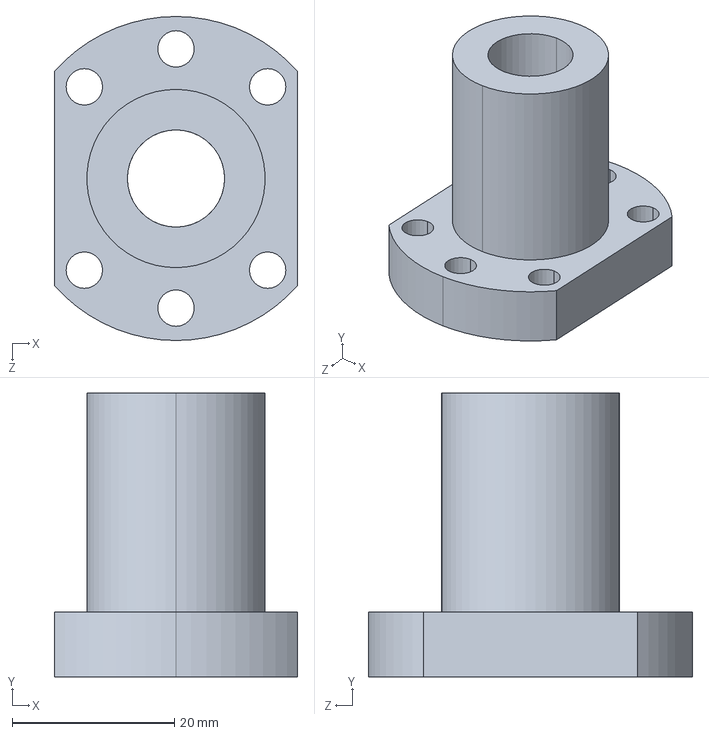
[picture p117: CAD file, 2024-09-17]
大角度冲刷式采收一体莲藕收获装置三维/零件图/丝杆中座.SLDPRT
30.0 x 35.0 x 40.0 mm
