wdxzf/High-Angle-Lotus-Harvester/大角度冲刷式采收一体莲藕收获装置三维/零件图/抽水泵副盖.SLDPRT

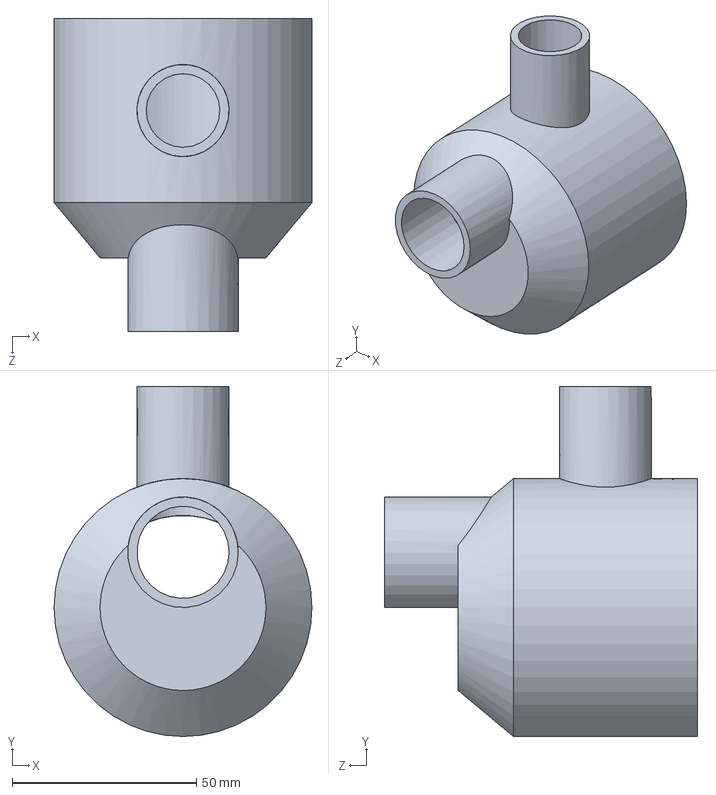
[picture p118: CAD file, 2024-09-17]
大角度冲刷式采收一体莲藕收获装置三维/零件图/抽水泵副盖.SLDPRT
70.0 x 95.0 x 85.0 mm
