wdxzf/High-Angle-Lotus-Harvester/大角度冲刷式采收一体莲藕收获装置三维/零件图/电机轴.SLDPRT

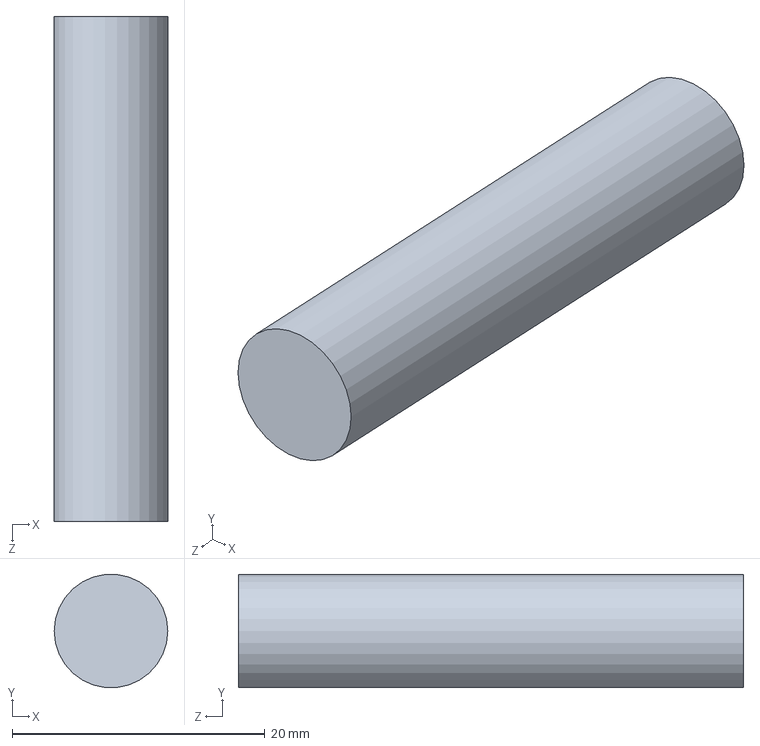
[picture p119: CAD file, 2024-09-17]
大角度冲刷式采收一体莲藕收获装置三维/零件图/电机轴.SLDPRT
9.00 x 8.95 x 40.0 mm
