wdxzf/High-Angle-Lotus-Harvester/大角度冲刷式采收一体莲藕收获装置三维/零件图/丝杆套筒.SLDPRT

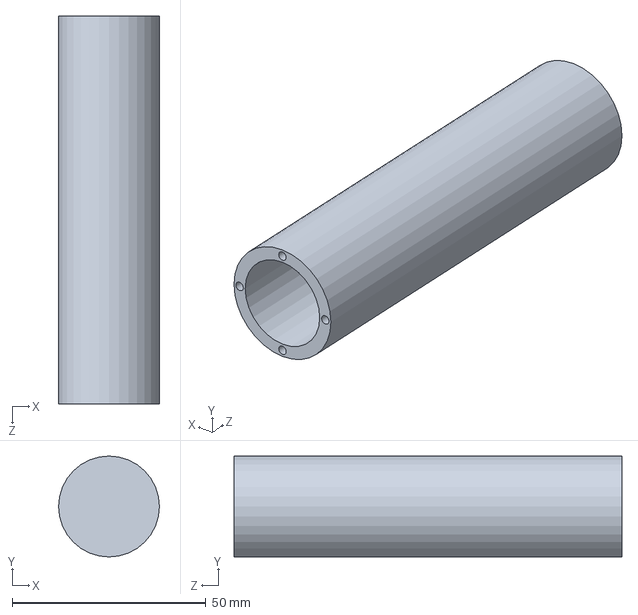
[picture p120: CAD file, 2024-09-17]
大角度冲刷式采收一体莲藕收获装置三维/零件图/丝杆套筒.SLDPRT
26.0 x 26.0 x 100.0 mm
