wdxzf/High-Angle-Lotus-Harvester/大角度冲刷式采收一体莲藕收获装置三维/零件图/电机30.SLDPRT

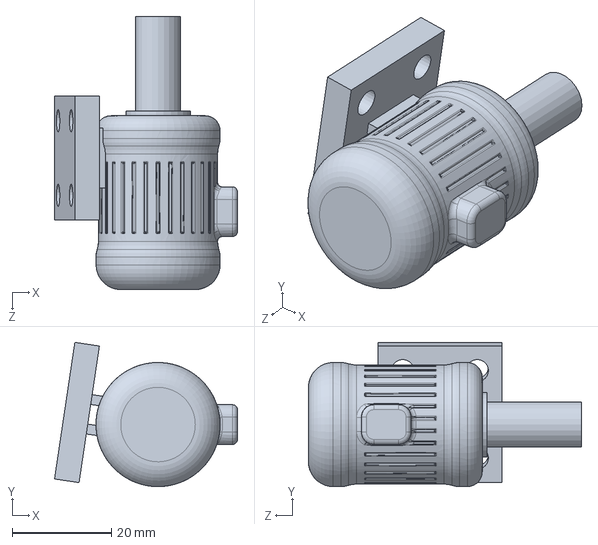
[picture p121: CAD file, 2024-09-17]
大角度冲刷式采收一体莲藕收获装置三维/零件图/电机30.SLDPRT
36.8 x 29.0 x 55.0 mm
