wdxzf/High-Angle-Lotus-Harvester/大角度冲刷式采收一体莲藕收获装置三维/零件图/太阳能板.SLDPRT

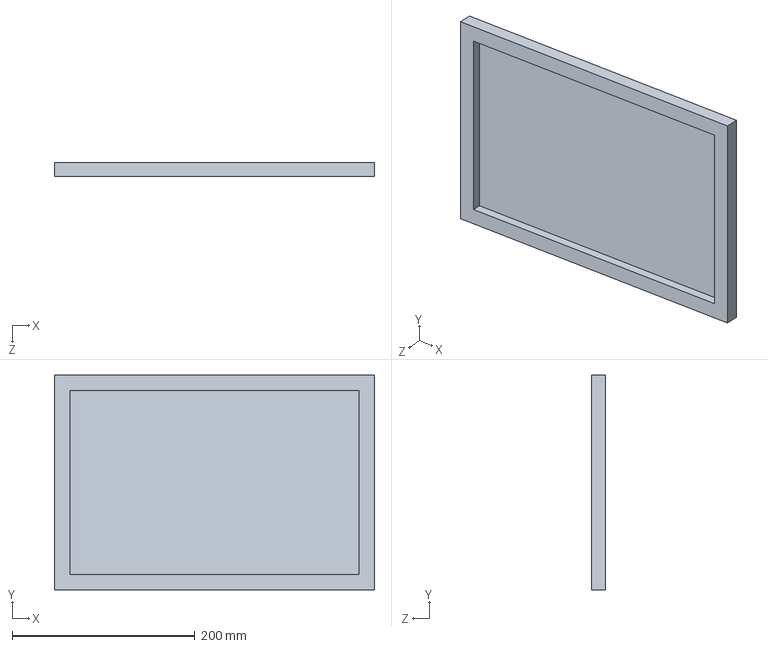
[picture p122: CAD file, 2024-09-17]
大角度冲刷式采收一体莲藕收获装置三维/零件图/太阳能板.SLDPRT
350.0 x 235.0 x 15.0 mm
