wdxzf/High-Angle-Lotus-Harvester/大角度冲刷式采收一体莲藕收获装置三维/零件图/旋转轴轴承.step

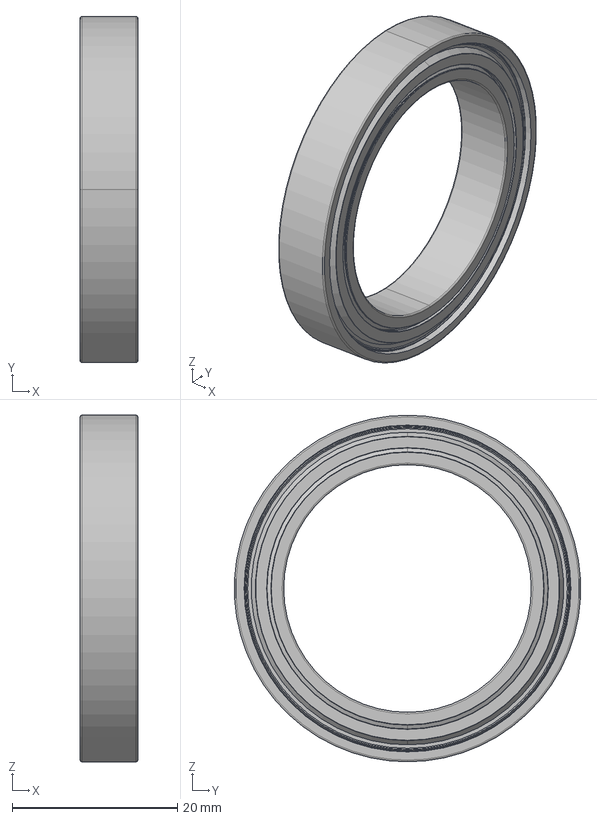
[picture p123: CAD file, 2024-09-17]
大角度冲刷式采收一体莲藕收获装置三维/零件图/旋转轴轴承.step
7.00 x 41.9 x 42.0 mm
