wdxzf/High-Angle-Lotus-Harvester/大角度冲刷式采收一体莲藕收获装置三维/零件图/收集装置  驱动圆柱齿轮25×2.51.SLDPRT

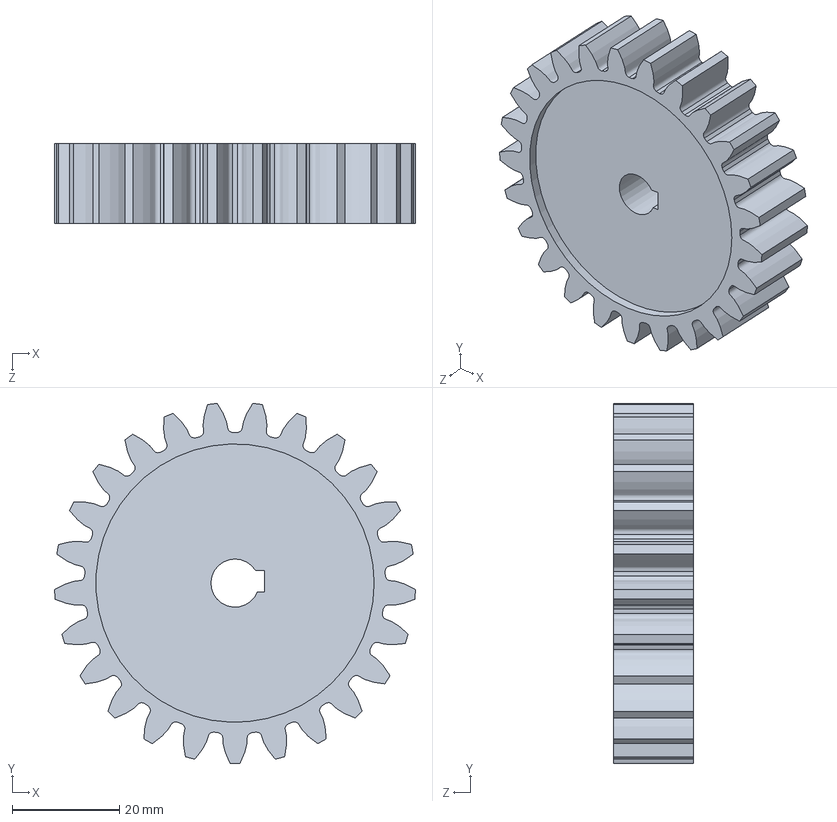
[picture p124: CAD file, 2024-09-17]
大角度冲刷式采收一体莲藕收获装置三维/零件图/收集装置 驱动圆柱齿轮25×2.51.SLDPRT
67.5 x 67.3 x 15.0 mm
