wdxzf/High-Angle-Lotus-Harvester/大角度冲刷式采收一体莲藕收获装置三维/零件图/上电机座壳.SLDPRT

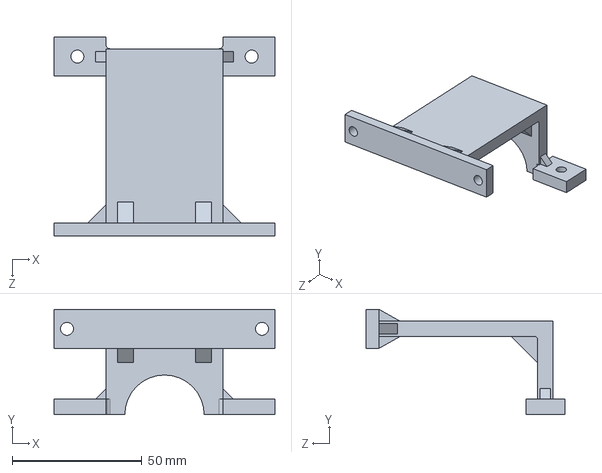
[picture p125: CAD file, 2024-09-17]
大角度冲刷式采收一体莲藕收获装置三维/零件图/上电机座壳.SLDPRT
85.0 x 40.5 x 76.5 mm
