wdxzf/High-Angle-Lotus-Harvester/大角度冲刷式采收一体莲藕收获装置三维/零件图/履带齿轮.SLDPRT

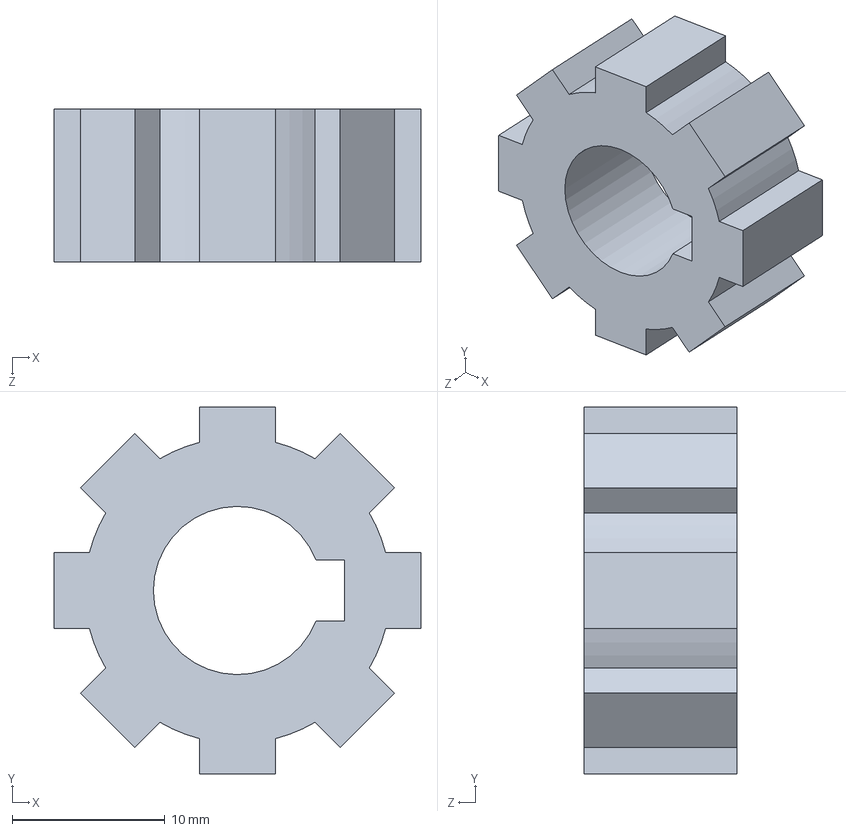
[picture p126: CAD file, 2024-09-17]
大角度冲刷式采收一体莲藕收获装置三维/零件图/履带齿轮.SLDPRT
24.0 x 24.0 x 10.0 mm
