wdxzf/High-Angle-Lotus-Harvester/大角度冲刷式采收一体莲藕收获装置三维/零件图/轴承座.step

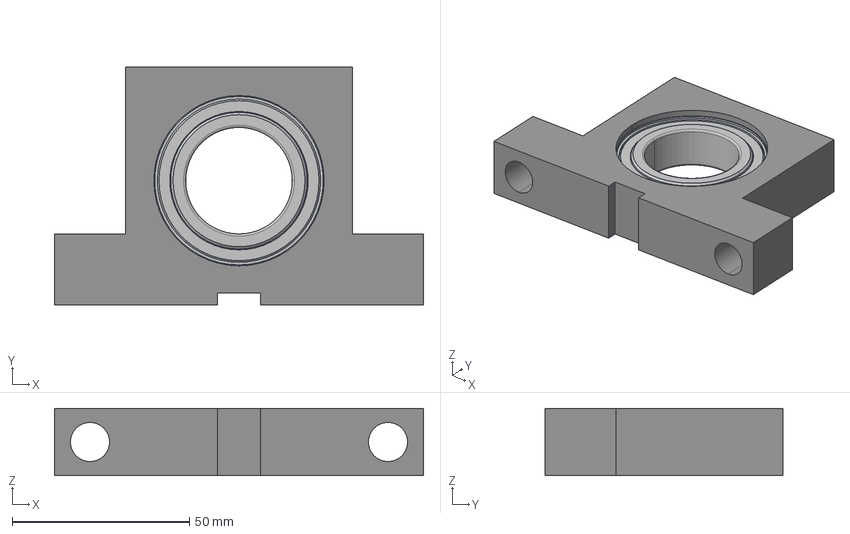
[picture p127: CAD file, 2024-09-17]
大角度冲刷式采收一体莲藕收获装置三维/零件图/轴承座.step
104.0 x 67.0 x 19.0 mm
���1^1709866196957
���2^1709866196957
���3^1709866196957
