wdxzf/High-Angle-Lotus-Harvester/大角度冲刷式采收一体莲藕收获装置三维/零件图/管子0.SLDPRT

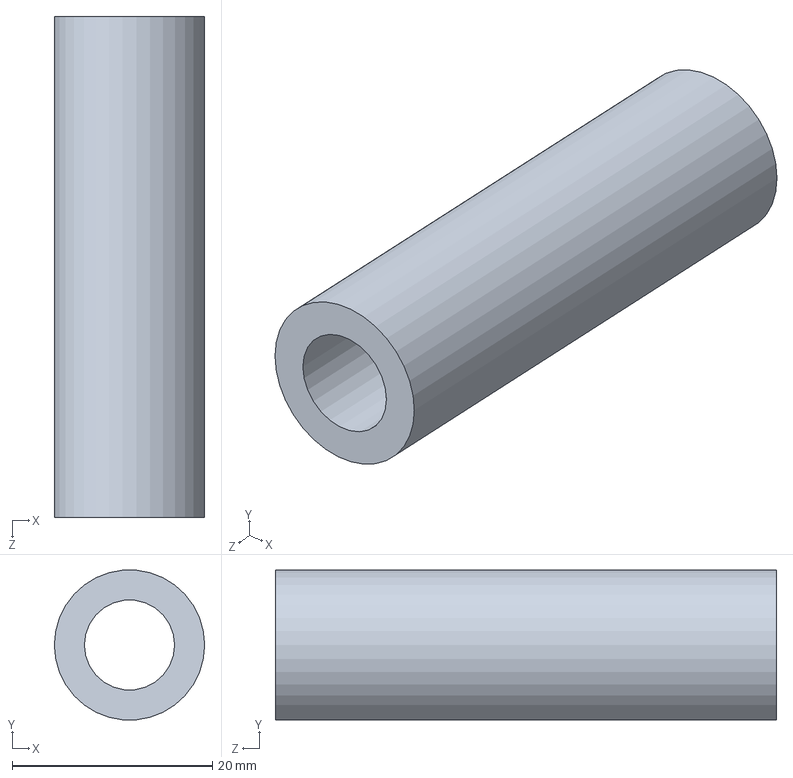
[picture p128: CAD file, 2024-09-17]
大角度冲刷式采收一体莲藕收获装置三维/零件图/管子0.SLDPRT
15.0 x 14.9 x 50.0 mm
