wdxzf/High-Angle-Lotus-Harvester/大角度冲刷式采收一体莲藕收获装置三维/零件图/6808轴承.step

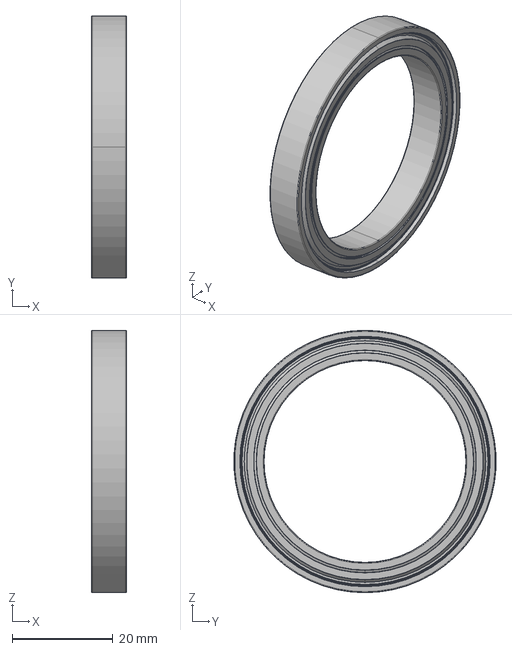
[picture p129: CAD file, 2024-09-17]
大角度冲刷式采收一体莲藕收获装置三维/零件图/6808轴承.step
7.00 x 51.9 x 52.0 mm
