wdxzf/High-Angle-Lotus-Harvester/大角度冲刷式采收一体莲藕收获装置三维/零件图/轮盖.SLDPRT

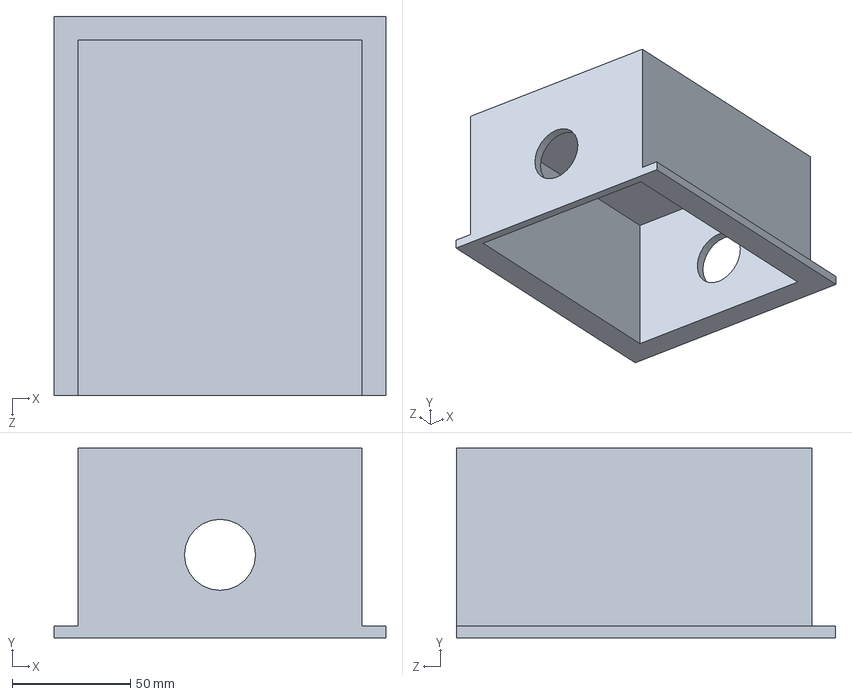
[picture p130: CAD file, 2024-09-17]
大角度冲刷式采收一体莲藕收获装置三维/零件图/轮盖.SLDPRT
140.0 x 80.0 x 160.0 mm
