wdxzf/High-Angle-Lotus-Harvester/大角度冲刷式采收一体莲藕收获装置三维/零件图/水管支座.SLDPRT

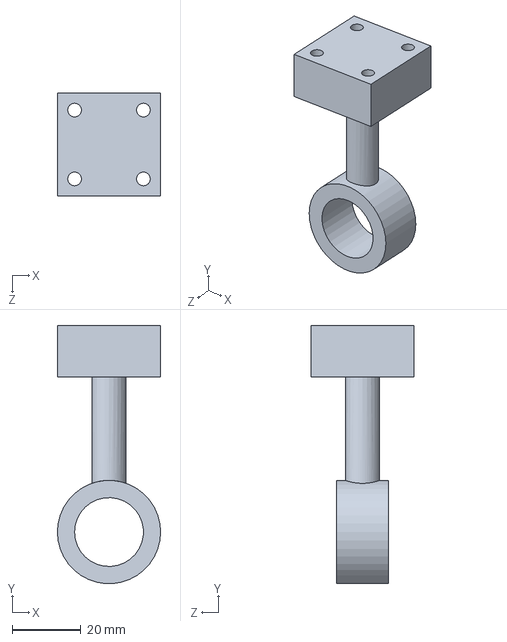
[picture p131: CAD file, 2024-09-17]
大角度冲刷式采收一体莲藕收获装置三维/零件图/水管支座.SLDPRT
30.0 x 74.9 x 30.0 mm
