wdxzf/High-Angle-Lotus-Harvester/大角度冲刷式采收一体莲藕收获装置三维/零件图/丝杠.sldprt

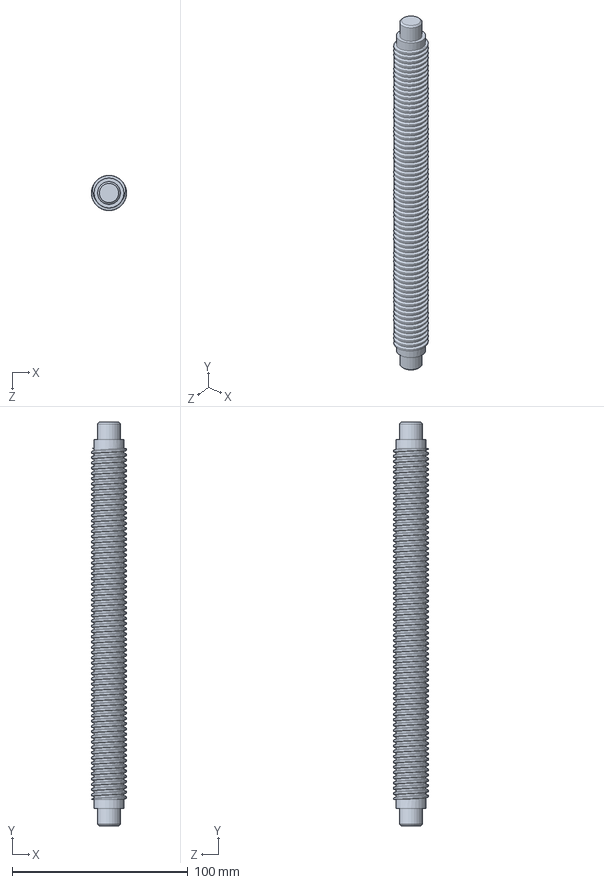
[picture p132: CAD file, 2024-09-17]
大角度冲刷式采收一体莲藕收获装置三维/零件图/丝杠.sldprt
20.0 x 230.0 x 20.0 mm
