wdxzf/High-Angle-Lotus-Harvester/大角度冲刷式采收一体莲藕收获装置三维/零件图/履带轴承座.step

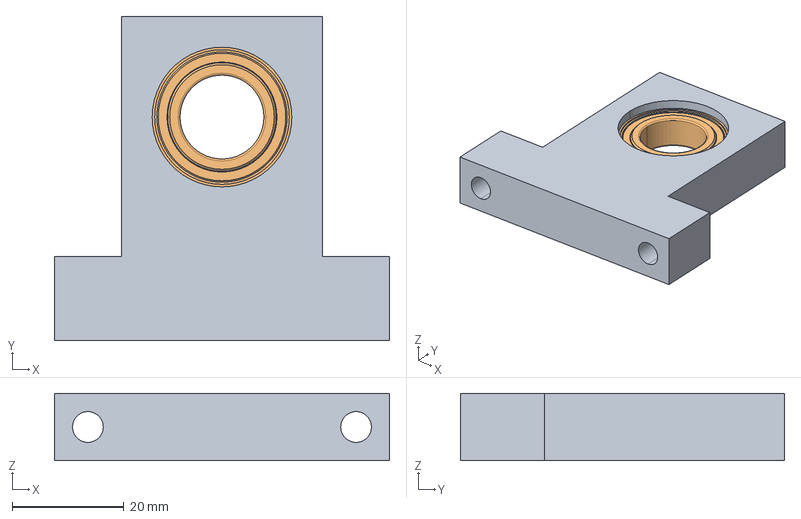
[picture p133: CAD file, 2024-09-17]
大角度冲刷式采收一体莲藕收获装置三维/零件图/履带轴承座.step
60.0 x 58.0 x 12.0 mm
���1^1710401167146
���2^1710401167146
���3^1710401167146
