wdxzf/High-Angle-Lotus-Harvester/大角度冲刷式采收一体莲藕收获装置三维/零件图/推拉杆十字轴支架.SLDPRT

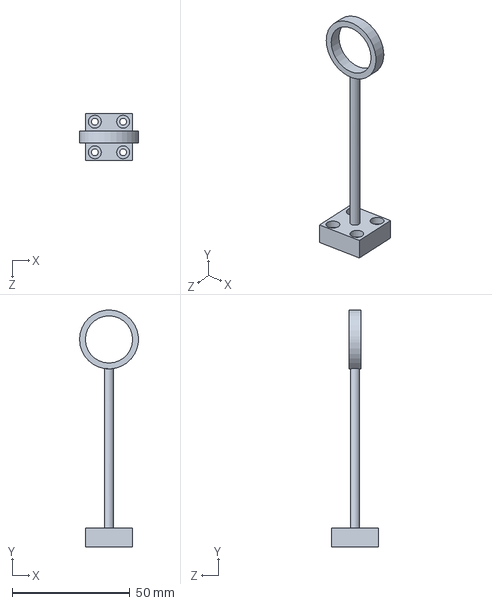
[picture p135: CAD file, 2024-09-17]
大角度冲刷式采收一体莲藕收获装置三维/零件图/推拉杆十字轴支架.SLDPRT
25.0 x 100.5 x 20.0 mm
