wdxzf/High-Angle-Lotus-Harvester/大角度冲刷式采收一体莲藕收获装置三维/零件图/圆柱齿轮轴.SLDPRT

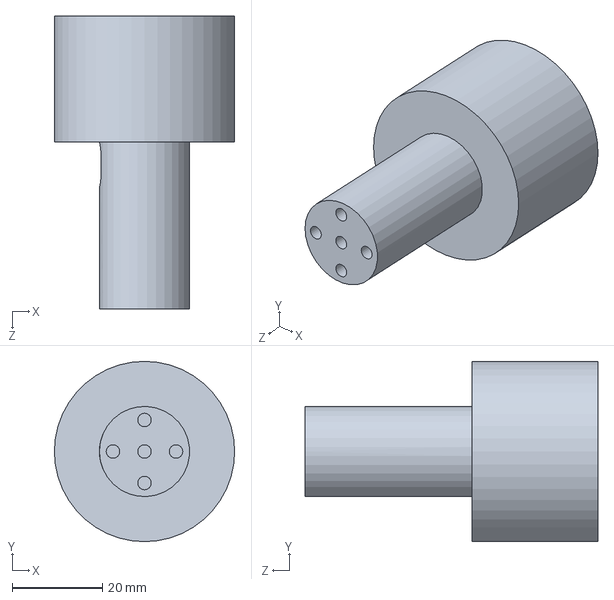
[picture p136: CAD file, 2024-09-17]
大角度冲刷式采收一体莲藕收获装置三维/零件图/圆柱齿轮轴.SLDPRT
40.0 x 40.0 x 65.0 mm
