wdxzf/High-Angle-Lotus-Harvester/大角度冲刷式采收一体莲藕收获装置三维/零件图/电机000.sldprt

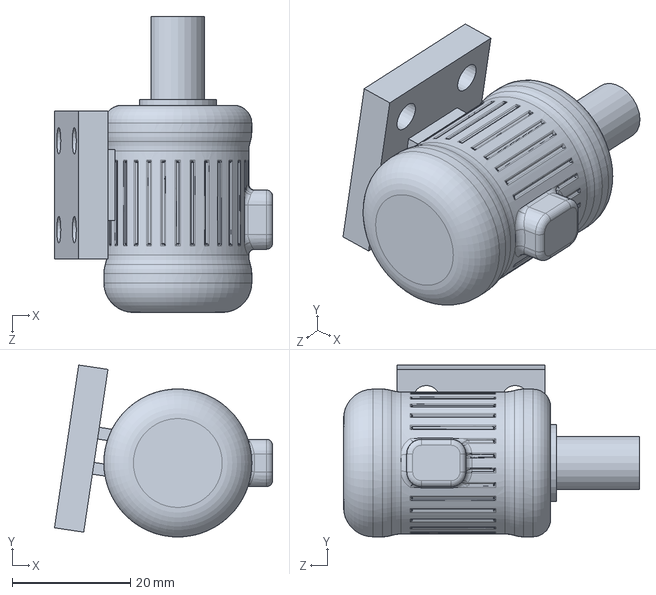
[picture p137: CAD file, 2024-09-17]
大角度冲刷式采收一体莲藕收获装置三维/零件图/电机000.sldprt
36.8 x 29.0 x 50.0 mm
