wdxzf/High-Angle-Lotus-Harvester/大角度冲刷式采收一体莲藕收获装置三维/零件图/推拉杆连杆.SLDPRT

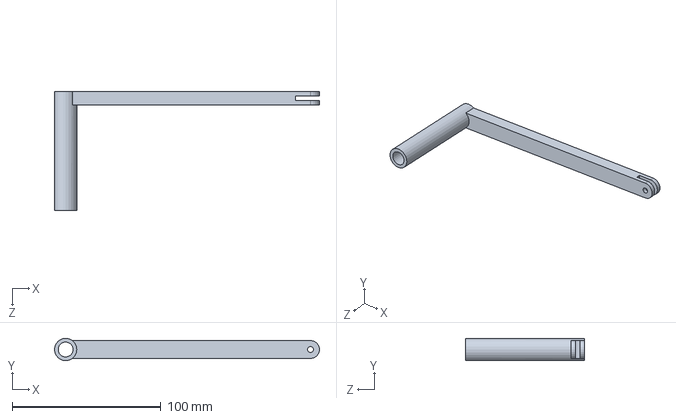
[picture p138: CAD file, 2024-09-17]
大角度冲刷式采收一体莲藕收获装置三维/零件图/推拉杆连杆.SLDPRT
178.0 x 15.0 x 80.0 mm
