wdxzf/High-Angle-Lotus-Harvester/大角度冲刷式采收一体莲藕收获装置三维/零件图/连轴帽.SLDPRT

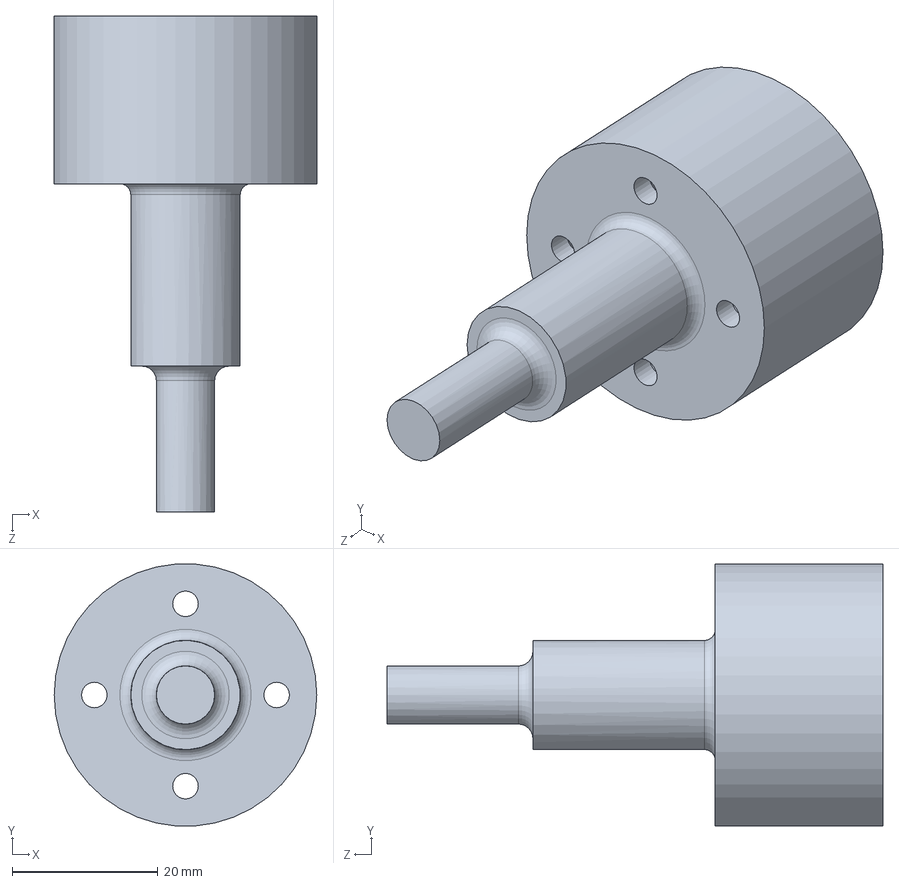
[picture p139: CAD file, 2024-09-17]
大角度冲刷式采收一体莲藕收获装置三维/零件图/连轴帽.SLDPRT
36.0 x 35.9 x 68.0 mm
