wdxzf/High-Angle-Lotus-Harvester/大角度冲刷式采收一体莲藕收获装置三维/零件图/收集装置下支座.SLDPRT

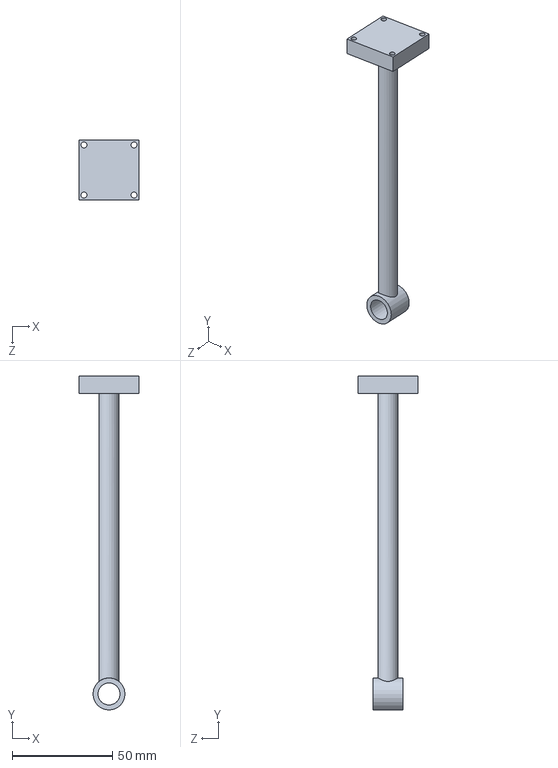
[picture p140: CAD file, 2024-09-17]
大角度冲刷式采收一体莲藕收获装置三维/零件图/收集装置下支座.SLDPRT
30.0 x 166.6 x 30.0 mm
