wdxzf/High-Angle-Lotus-Harvester/大角度冲刷式采收一体莲藕收获装置三维/零件图/20mm内径轴承.step

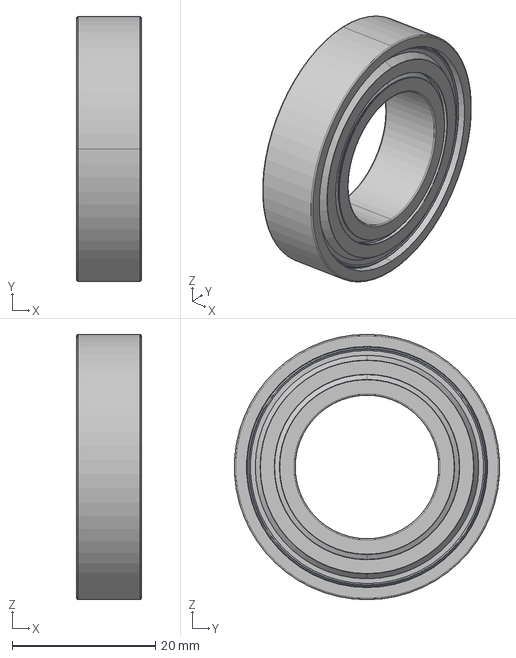
[picture p141: CAD file, 2024-09-17]
大角度冲刷式采收一体莲藕收获装置三维/零件图/20mm内径轴承.step
9.00 x 36.9 x 37.0 mm
