wdxzf/High-Angle-Lotus-Harvester/大角度冲刷式采收一体莲藕收获装置三维/零件图/推力轴承.sldprt

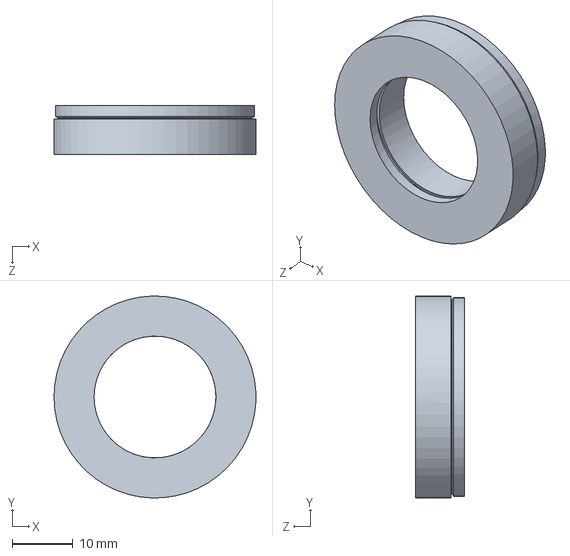
[picture p142: CAD file, 2024-09-17]
大角度冲刷式采收一体莲藕收获装置三维/零件图/推力轴承.sldprt
33.2 x 33.1 x 8.00 mm
