wdxzf/High-Angle-Lotus-Harvester/大角度冲刷式采收一体莲藕收获装置三维/零件图/升降丝杆驱动   蜗杆1×2.5.SLDPRT

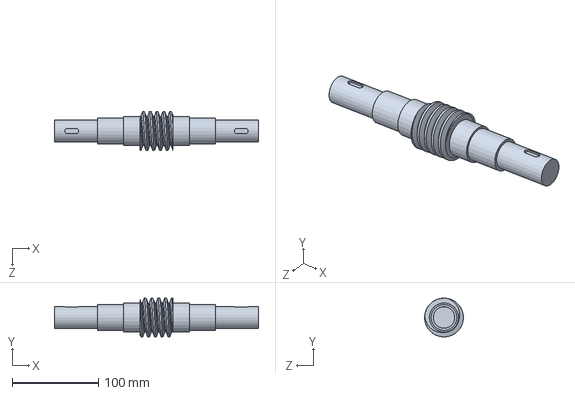
[picture p143: CAD file, 2024-09-17]
大角度冲刷式采收一体莲藕收获装置三维/零件图/升降丝杆驱动 蜗杆1×2.5.SLDPRT
236.5 x 45.0 x 45.0 mm
