wdxzf/High-Angle-Lotus-Harvester/大角度冲刷式采收一体莲藕收获装置三维/零件图/履带传动齿轮.SLDPRT

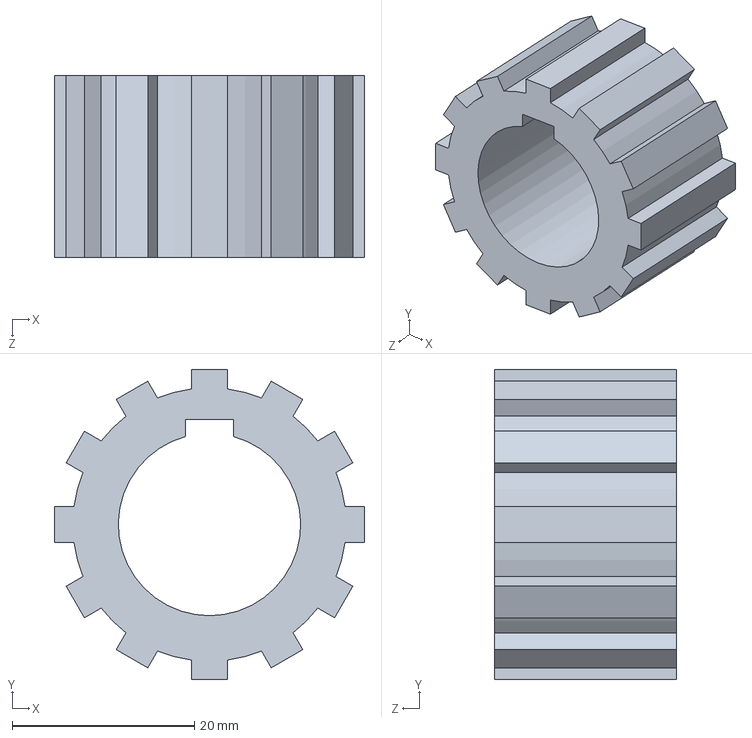
[picture p144: CAD file, 2024-09-17]
大角度冲刷式采收一体莲藕收获装置三维/零件图/履带传动齿轮.SLDPRT
34.0 x 34.0 x 20.0 mm
