wdxzf/High-Angle-Lotus-Harvester/大角度冲刷式采收一体莲藕收获装置三维/零件图/履带支座.SLDPRT

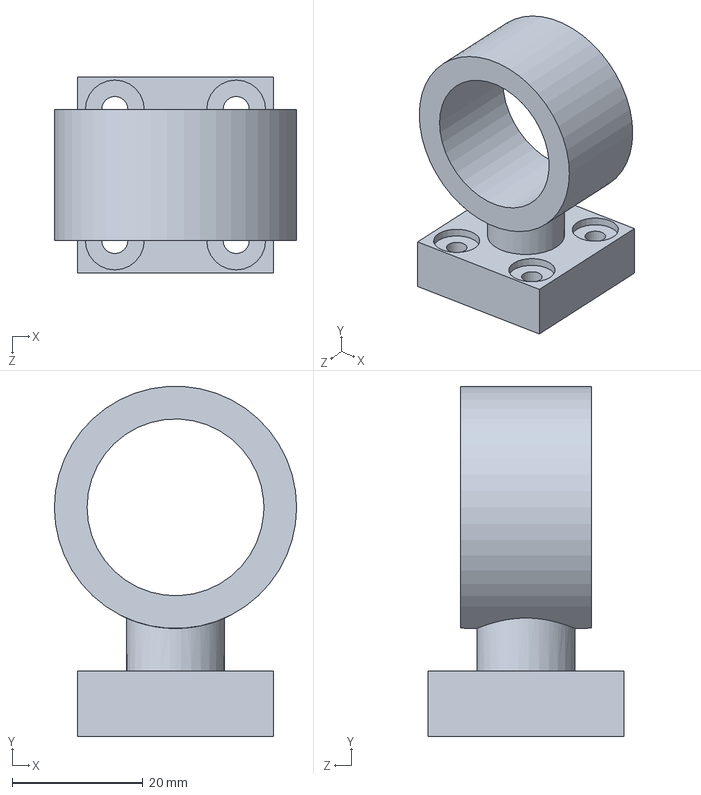
[picture p145: CAD file, 2024-09-17]
大角度冲刷式采收一体莲藕收获装置三维/零件图/履带支座.SLDPRT
37.0 x 53.5 x 30.0 mm
