wdxzf/High-Angle-Lotus-Harvester/大角度冲刷式采收一体莲藕收获装置三维/零件图/电机支座33.SLDPRT

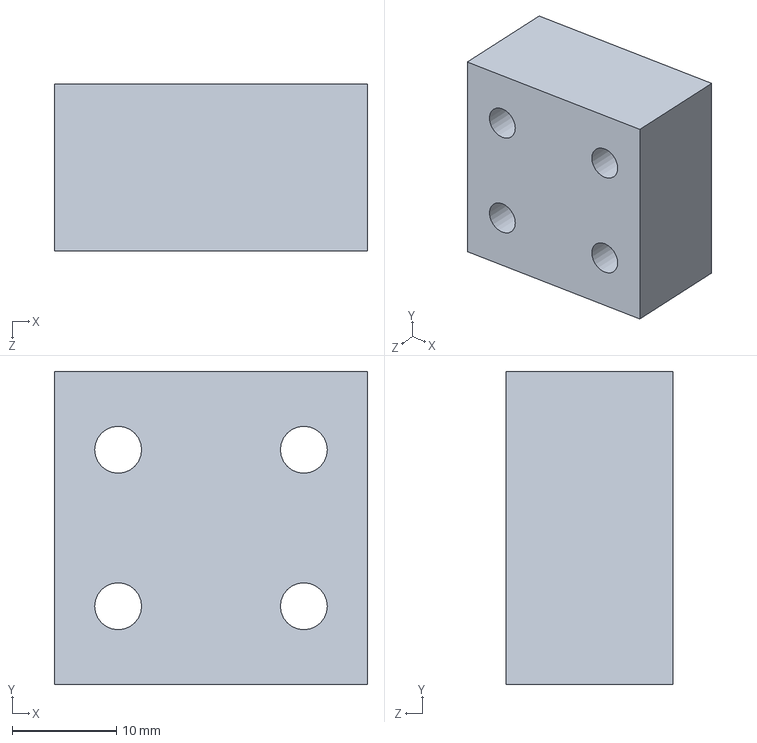
[picture p146: CAD file, 2024-09-17]
大角度冲刷式采收一体莲藕收获装置三维/零件图/电机支座33.SLDPRT
30.0 x 30.0 x 16.0 mm
