wdxzf/High-Angle-Lotus-Harvester/大角度冲刷式采收一体莲藕收获装置三维/零件图/控制板外壳.SLDPRT

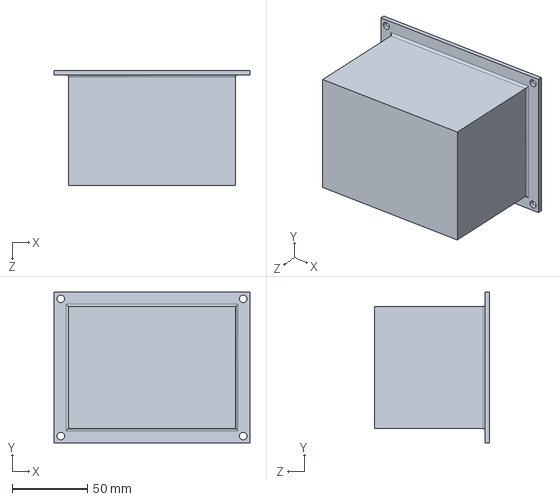
[picture p147: CAD file, 2024-09-17]
大角度冲刷式采收一体莲藕收获装置三维/零件图/控制板外壳.SLDPRT
130.0 x 100.0 x 76.5 mm
