wdxzf/High-Angle-Lotus-Harvester/大角度冲刷式采收一体莲藕收获装置三维/零件图/管子  圆柱齿轮17×2.5.SLDPRT

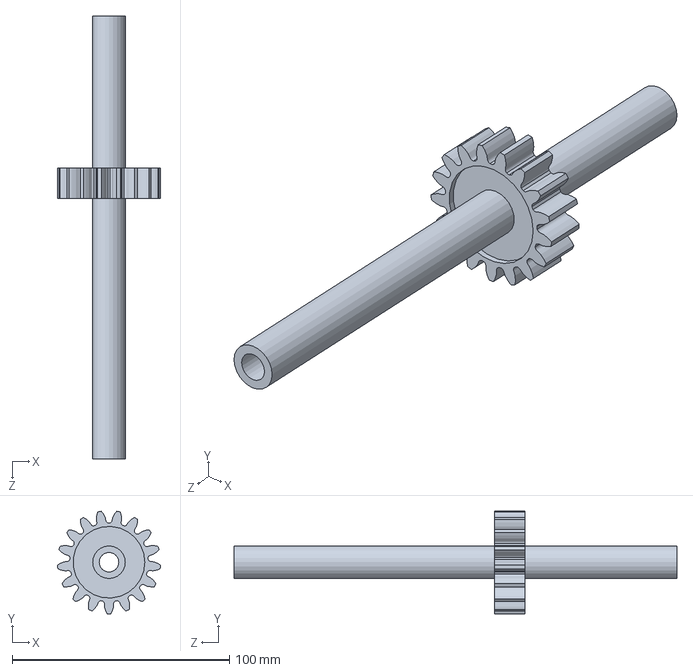
[picture p148: CAD file, 2024-09-17]
大角度冲刷式采收一体莲藕收获装置三维/零件图/管子 圆柱齿轮17×2.5.SLDPRT
47.4 x 47.2 x 204.0 mm
