wdxzf/High-Angle-Lotus-Harvester/大角度冲刷式采收一体莲藕收获装置三维/零件图/外壳支柱.SLDPRT

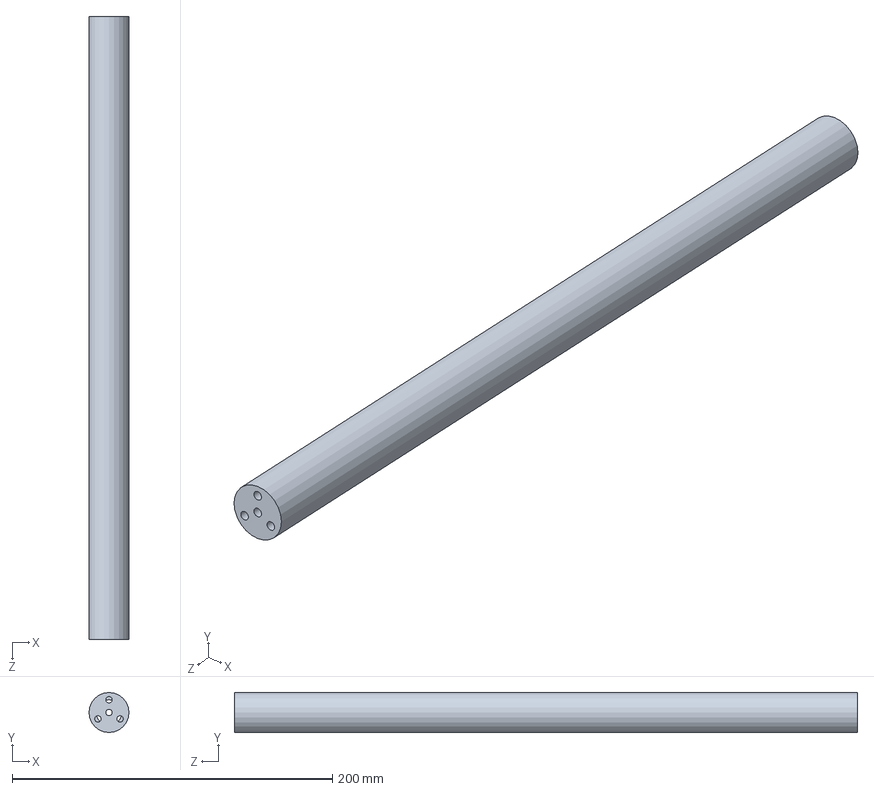
[picture p150: CAD file, 2024-09-17]
大角度冲刷式采收一体莲藕收获装置三维/零件图/外壳支柱.SLDPRT
25.0 x 25.0 x 389.0 mm
