wdxzf/High-Angle-Lotus-Harvester/大角度冲刷式采收一体莲藕收获装置三维/零件图/莲藕.SLDPRT

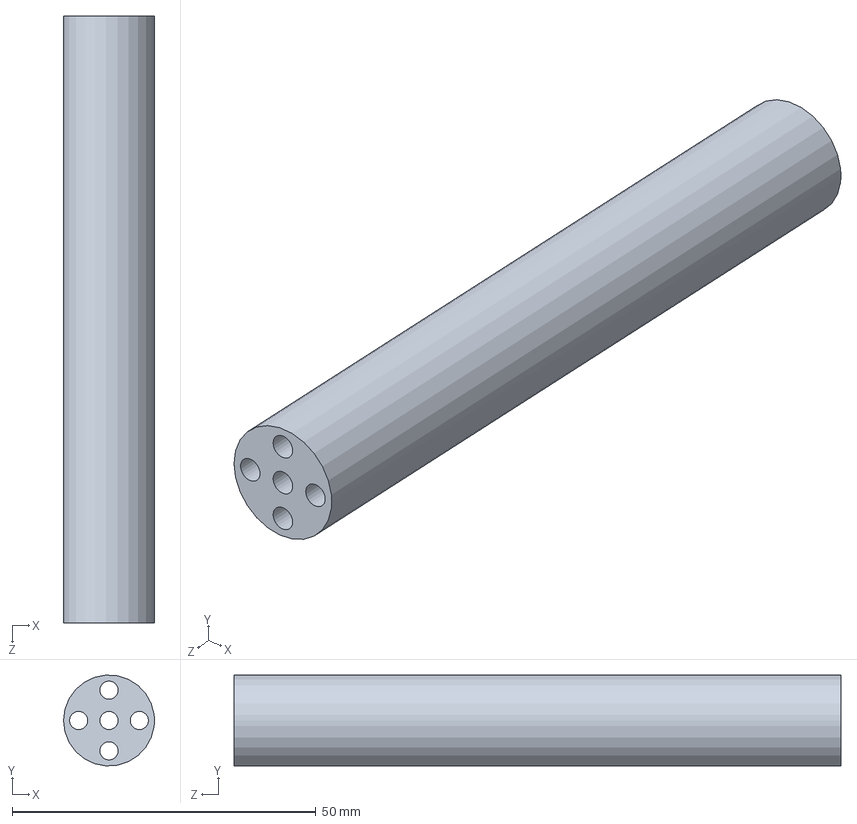
[picture p151: CAD file, 2024-09-17]
大角度冲刷式采收一体莲藕收获装置三维/零件图/莲藕.SLDPRT
15.0 x 15.0 x 100.0 mm
