wdxzf/High-Angle-Lotus-Harvester/大角度冲刷式采收一体莲藕收获装置三维/零件图/推拉杆驱动轮支座.SLDPRT

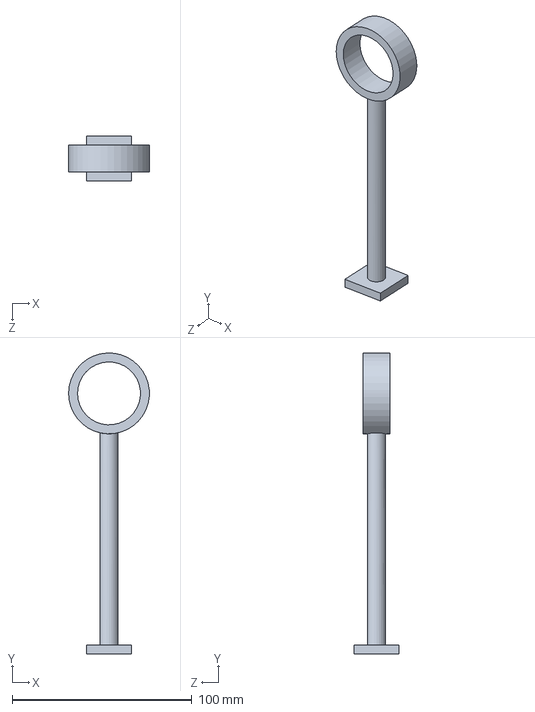
[picture p152: CAD file, 2024-09-17]
大角度冲刷式采收一体莲藕收获装置三维/零件图/推拉杆驱动轮支座.SLDPRT
45.0 x 167.5 x 25.0 mm
