wdxzf/High-Angle-Lotus-Harvester/大角度冲刷式采收一体莲藕收获装置三维/零件图/直径30直角弯头.SLDPRT

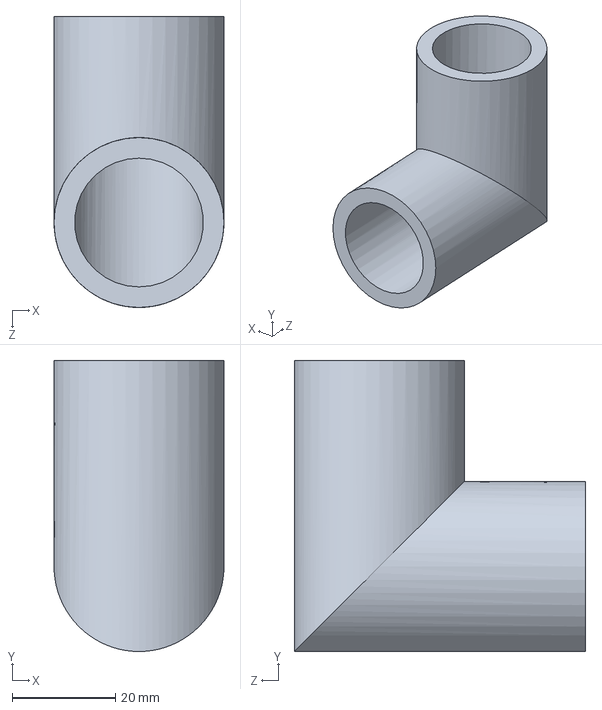
[picture p153: CAD file, 2024-09-17]
大角度冲刷式采收一体莲藕收获装置三维/零件图/直径30直角弯头.SLDPRT
33.0 x 56.5 x 56.5 mm
