wdxzf/High-Angle-Lotus-Harvester/大角度冲刷式采收一体莲藕收获装置三维/零件图/顶部电机座.SLDPRT

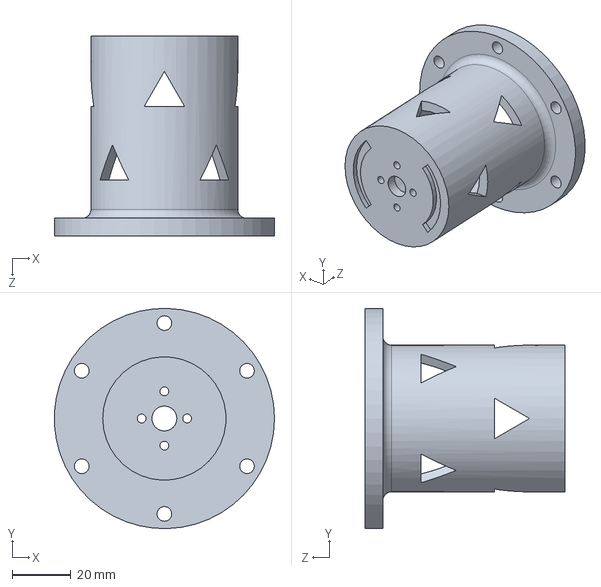
[picture p154: CAD file, 2024-09-17]
大角度冲刷式采收一体莲藕收获装置三维/零件图/顶部电机座.SLDPRT
74.9 x 75.0 x 68.0 mm
