wdxzf/High-Angle-Lotus-Harvester/大角度冲刷式采收一体莲藕收获装置三维/零件图/丝杆下中座.SLDPRT

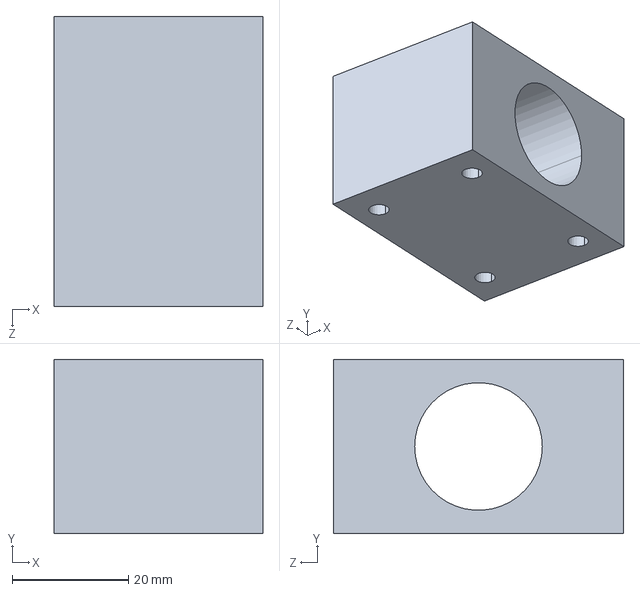
[picture p155: CAD file, 2024-09-17]
大角度冲刷式采收一体莲藕收获装置三维/零件图/丝杆下中座.SLDPRT
36.0 x 30.0 x 50.0 mm
