wdxzf/High-Angle-Lotus-Harvester/大角度冲刷式采收一体莲藕收获装置三维/零件图/船桨轴承座.SLDPRT

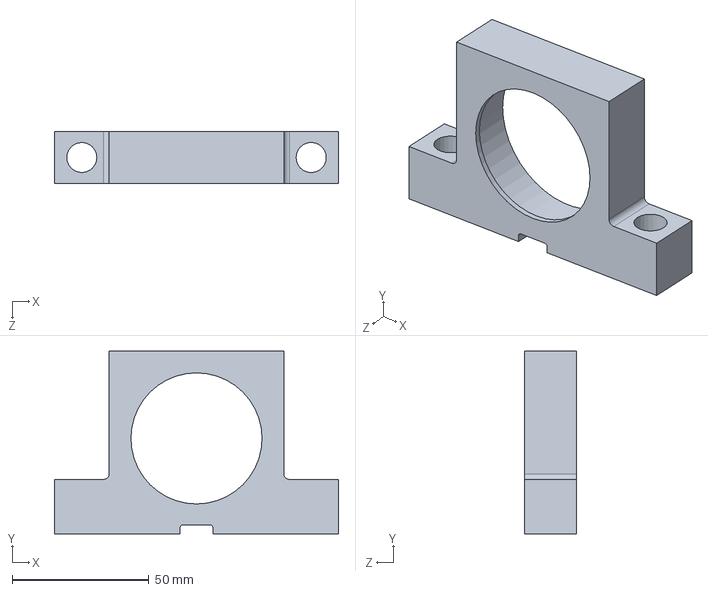
[picture p156: CAD file, 2024-09-17]
大角度冲刷式采收一体莲藕收获装置三维/零件图/船桨轴承座.SLDPRT
104.0 x 67.0 x 19.0 mm
