wdxzf/High-Angle-Lotus-Harvester/大角度冲刷式采收一体莲藕收获装置三维/零件图/右导向板.SLDPRT

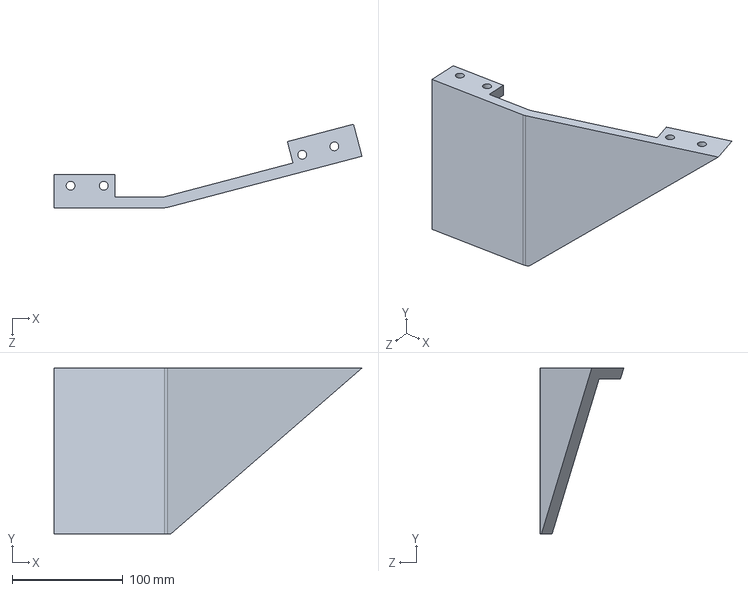
[picture p157: CAD file, 2024-09-17]
大角度冲刷式采收一体莲藕收获装置三维/零件图/右导向板.SLDPRT
278.5 x 150.0 x 75.6 mm
