wdxzf/High-Angle-Lotus-Harvester/大角度冲刷式采收一体莲藕收获装置三维/零件图/开发板.SLDPRT

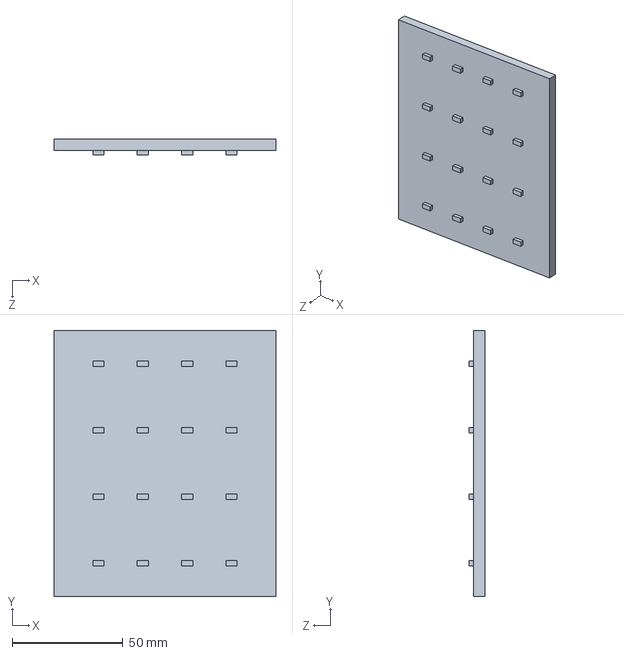
[picture p158: CAD file, 2024-09-17]
大角度冲刷式采收一体莲藕收获装置三维/零件图/开发板.SLDPRT
100.0 x 120.0 x 7.00 mm
