wdxzf/High-Angle-Lotus-Harvester/大角度冲刷式采收一体莲藕收获装置三维/零件图/收集槽.SLDPRT

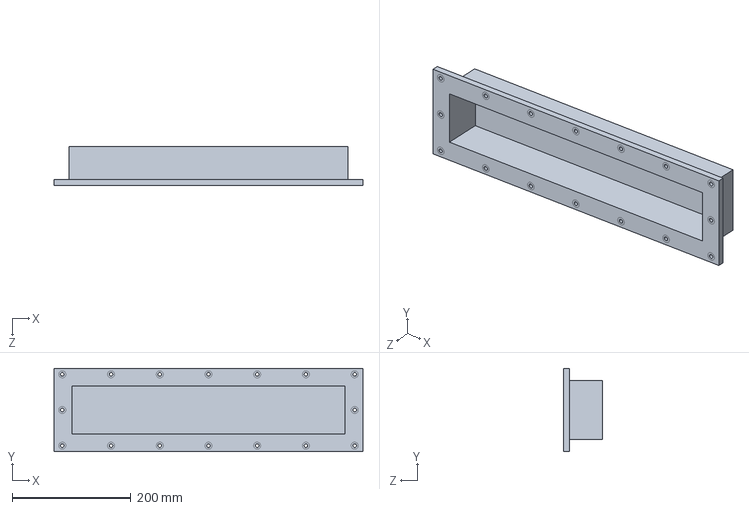
[picture p159: CAD file, 2024-09-17]
大角度冲刷式采收一体莲藕收获装置三维/零件图/收集槽.SLDPRT
520.0 x 140.0 x 65.0 mm
