wdxzf/High-Angle-Lotus-Harvester/大角度冲刷式采收一体莲藕收获装置三维/零件图/履带0.SLDPRT

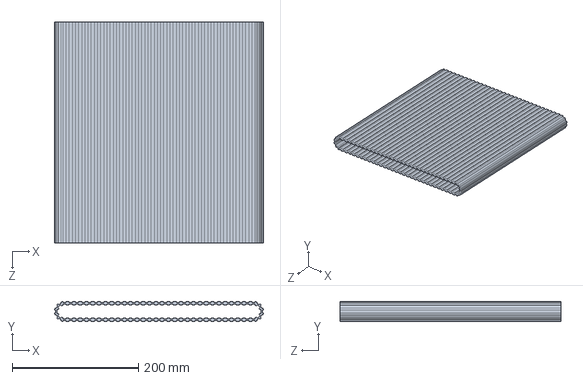
[picture p160: CAD file, 2024-09-17]
大角度冲刷式采收一体莲藕收获装置三维/零件图/履带0.SLDPRT
331.6 x 32.0 x 350.0 mm
