wdxzf/High-Angle-Lotus-Harvester/大角度冲刷式采收一体莲藕收获装置三维/零件图/BHDU-ME1-J-6002ZZ-h50.step

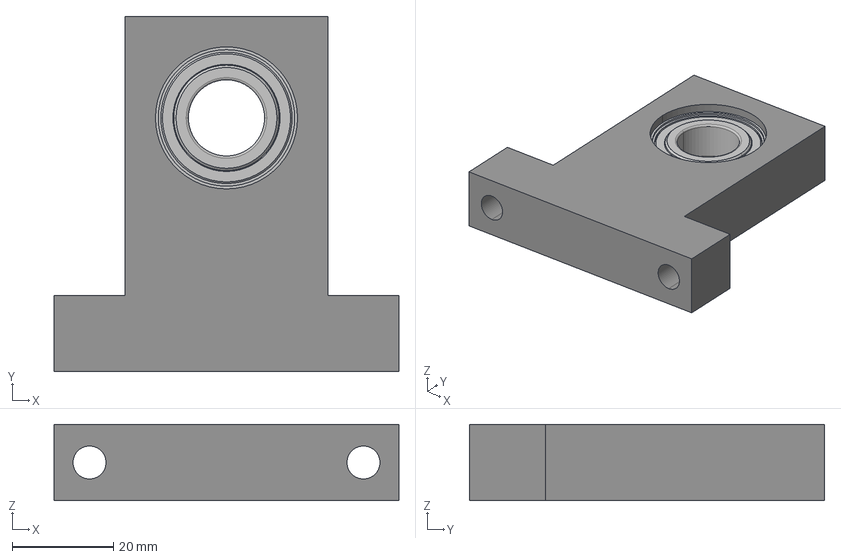
[picture p161: CAD file, 2024-09-17]
大角度冲刷式采收一体莲藕收获装置三维/零件图/BHDU-ME1-J-6002ZZ-h50.step
68.0 x 70.0 x 15.0 mm
���1^1711021514546
���2^1711021514546
���3^1711021514546
