wdxzf/High-Angle-Lotus-Harvester/大角度冲刷式采收一体莲藕收获装置三维/零件图/固定台右.SLDPRT

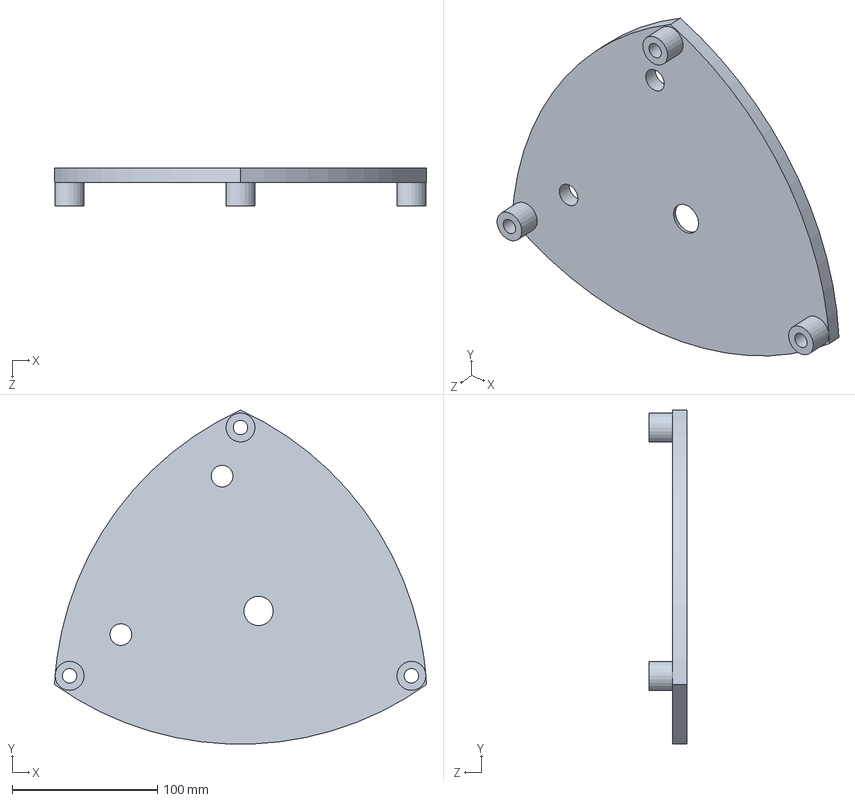
[picture p162: CAD file, 2024-09-17]
大角度冲刷式采收一体莲藕收获装置三维/零件图/固定台右.SLDPRT
256.0 x 229.8 x 26.0 mm
