wdxzf/High-Angle-Lotus-Harvester/大角度冲刷式采收一体莲藕收获装置三维/零件图/钩子.SLDPRT

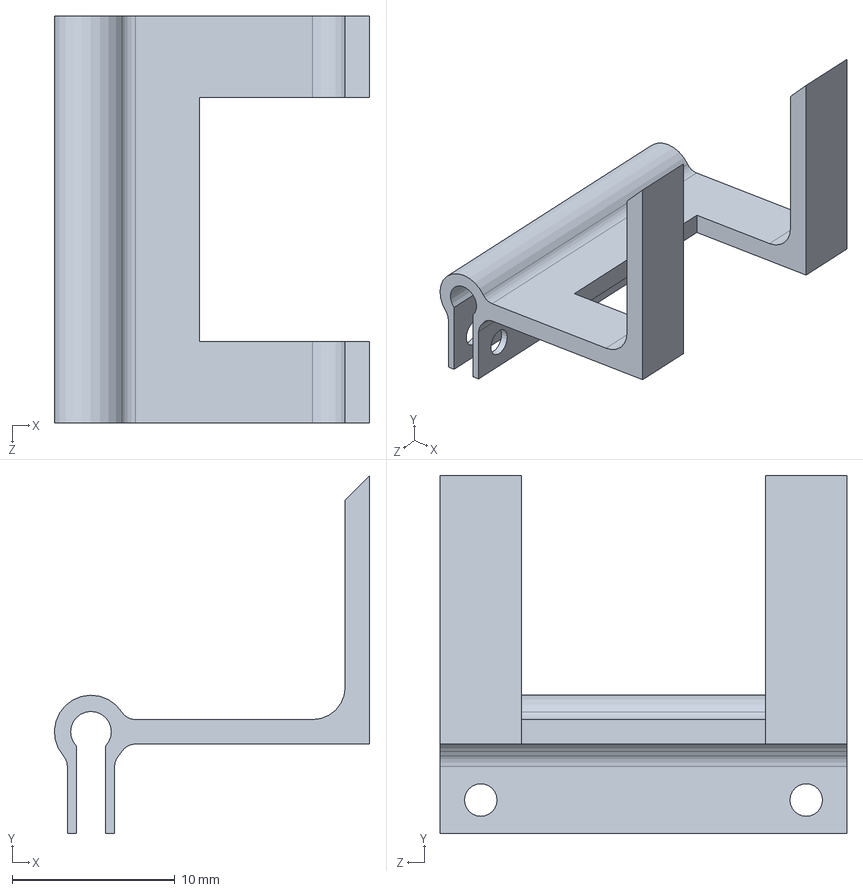
[picture p164: CAD file, 2024-09-17]
大角度冲刷式采收一体莲藕收获装置三维/零件图/钩子.SLDPRT
19.4 x 22.0 x 25.0 mm
