wdxzf/High-Angle-Lotus-Harvester/大角度冲刷式采收一体莲藕收获装置三维/零件图/双头轴.SLDPRT

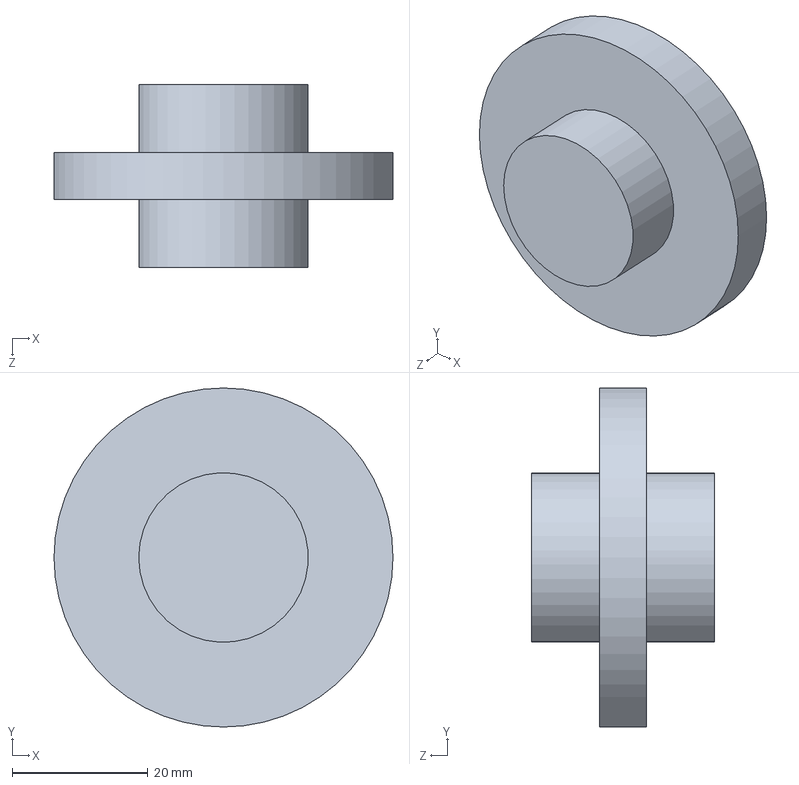
[picture p165: CAD file, 2024-09-17]
大角度冲刷式采收一体莲藕收获装置三维/零件图/双头轴.SLDPRT
50.0 x 50.0 x 27.0 mm
