wdxzf/High-Angle-Lotus-Harvester/大角度冲刷式采收一体莲藕收获装置三维/零件图/圆柱齿轮60×2.5.SLDPRT

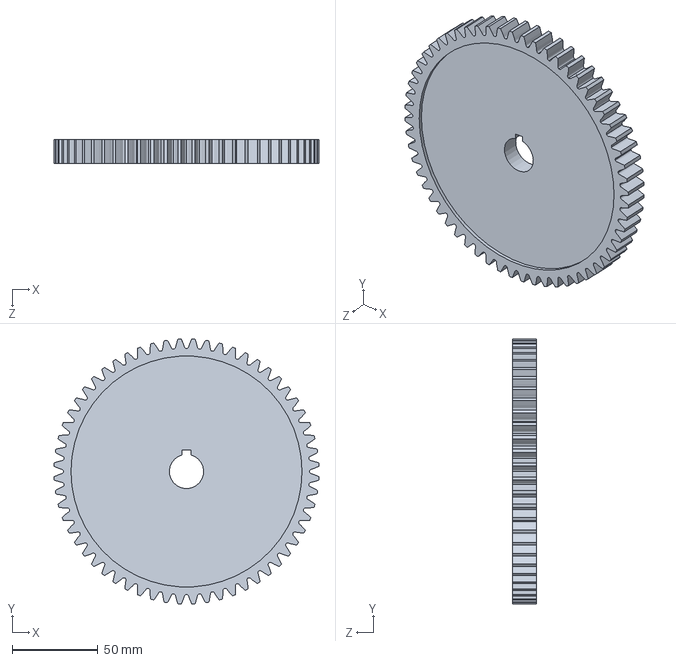
[picture p166: CAD file, 2024-09-17]
大角度冲刷式采收一体莲藕收获装置三维/零件图/圆柱齿轮60×2.5.SLDPRT
154.9 x 154.9 x 14.0 mm
