wdxzf/High-Angle-Lotus-Harvester/大角度冲刷式采收一体莲藕收获装置三维/零件图/推拉杆十字盘.SLDPRT

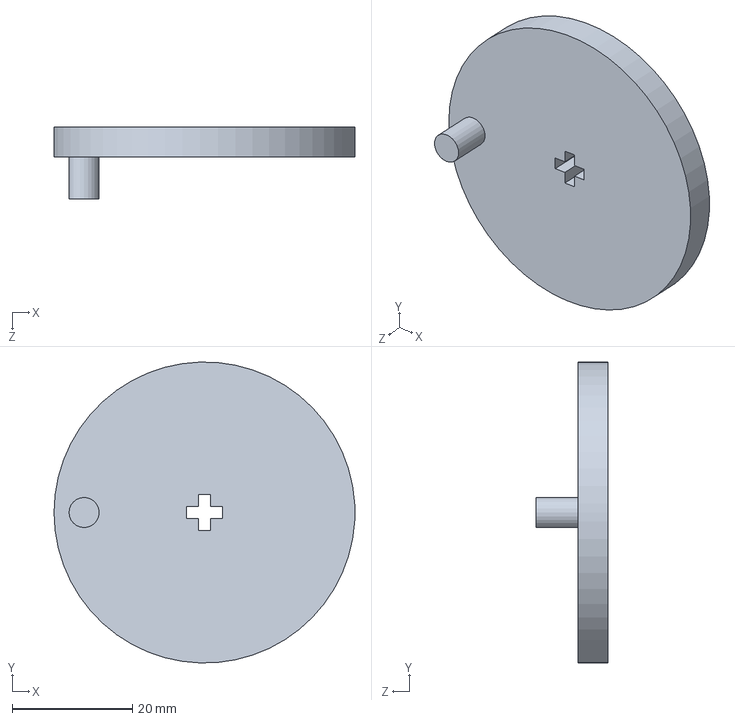
[picture p167: CAD file, 2024-09-17]
大角度冲刷式采收一体莲藕收获装置三维/零件图/推拉杆十字盘.SLDPRT
50.0 x 50.0 x 12.0 mm
