wdxzf/High-Angle-Lotus-Harvester/大角度冲刷式采收一体莲藕收获装置三维/零件图/6002z轴承盖.SLDPRT

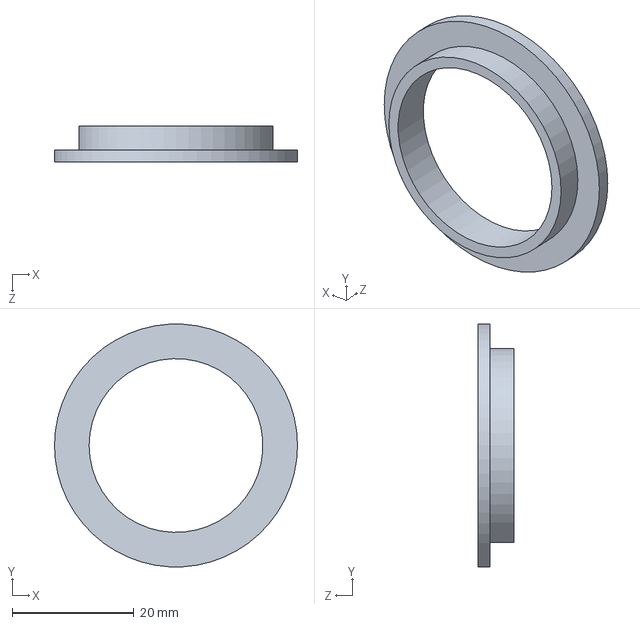
[picture p168: CAD file, 2024-09-17]
大角度冲刷式采收一体莲藕收获装置三维/零件图/6002z轴承盖.SLDPRT
40.0 x 39.9 x 6.00 mm
