wdxzf/High-Angle-Lotus-Harvester/大角度冲刷式采收一体莲藕收获装置三维/零件图/弯管.SLDPRT

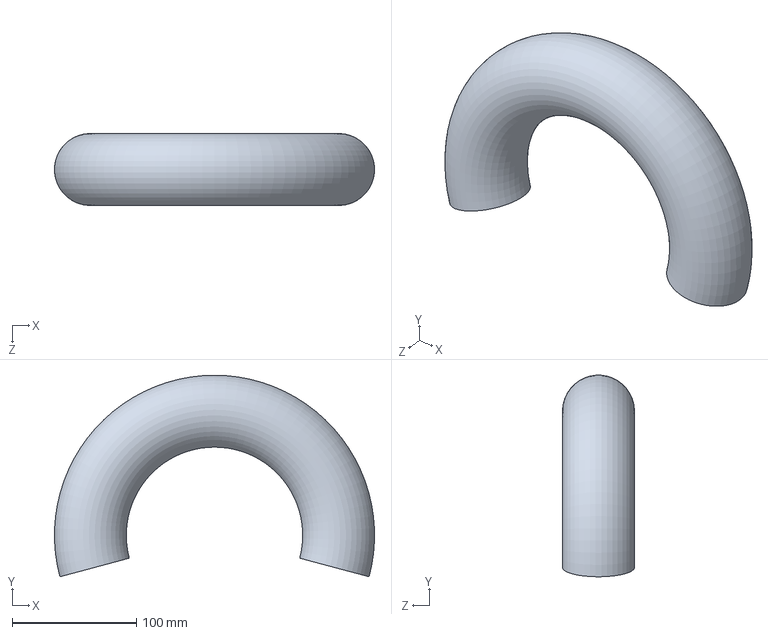
[picture p170: CAD file, 2024-09-17]
大角度冲刷式采收一体莲藕收获装置三维/零件图/弯管.SLDPRT
257.7 x 162.3 x 58.0 mm
