wdxzf/High-Angle-Lotus-Harvester/大角度冲刷式采收一体莲藕收获装置三维/零件图/推拉杆肖.SLDPRT

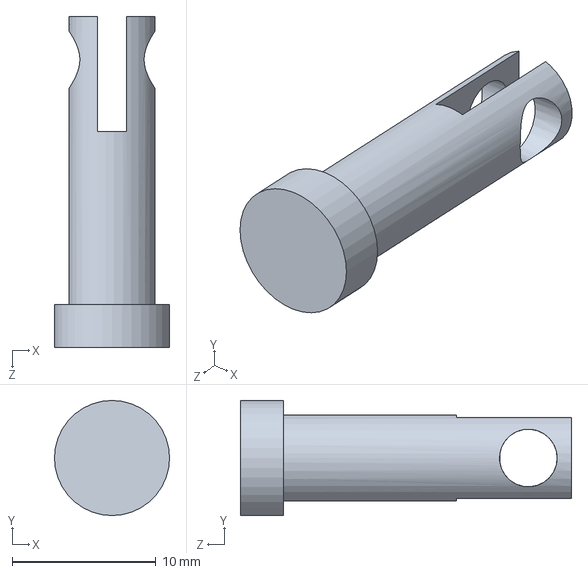
[picture p171: CAD file, 2024-09-17]
大角度冲刷式采收一体莲藕收获装置三维/零件图/推拉杆肖.SLDPRT
8.00 x 8.00 x 23.0 mm
