wdxzf/High-Angle-Lotus-Harvester/大角度冲刷式采收一体莲藕收获装置三维/零件图/支座轴承2.step

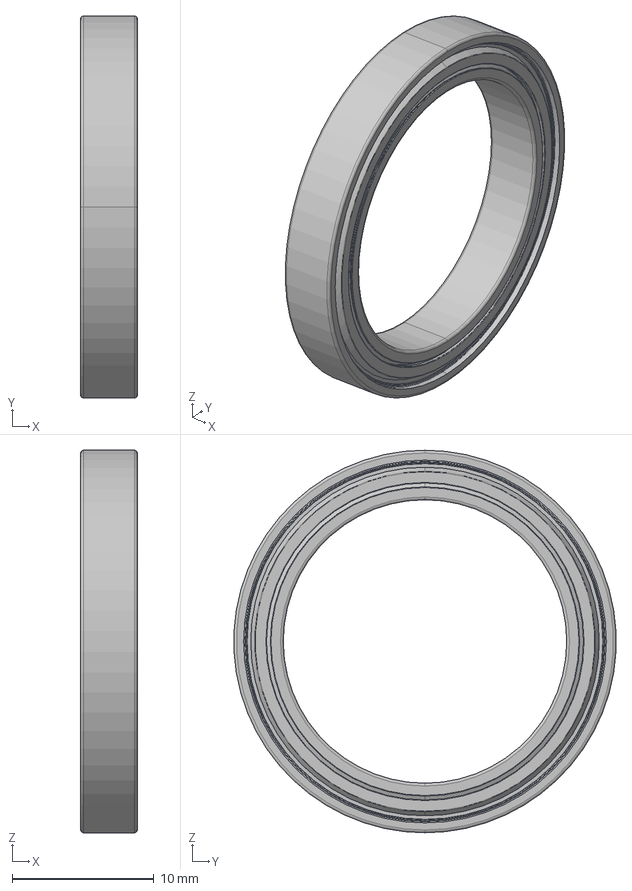
[picture p172: CAD file, 2024-09-17]
大角度冲刷式采收一体莲藕收获装置三维/零件图/支座轴承2.step
4.00 x 27.0 x 27.0 mm
