wdxzf/High-Angle-Lotus-Harvester/大角度冲刷式采收一体莲藕收获装置三维/零件图/上电机座上壳.SLDPRT

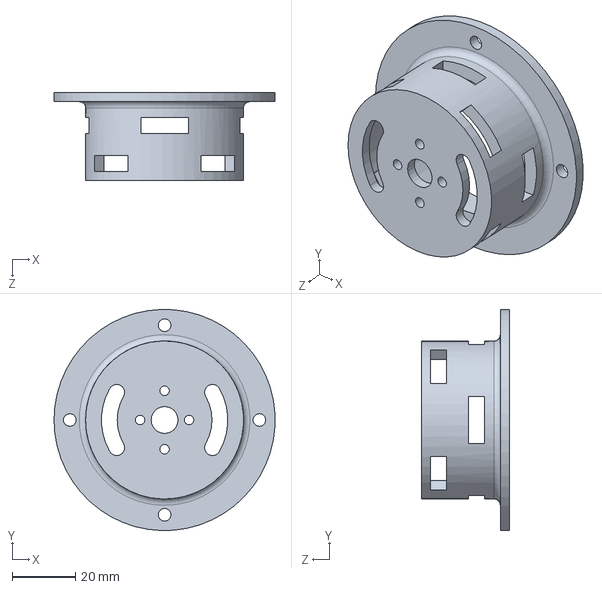
[picture p174: CAD file, 2024-09-17]
大角度冲刷式采收一体莲藕收获装置三维/零件图/上电机座上壳.SLDPRT
69.9 x 70.0 x 28.0 mm
