wdxzf/High-Angle-Lotus-Harvester/大角度冲刷式采收一体莲藕收获装置三维/零件图/短接头三通.SLDPRT

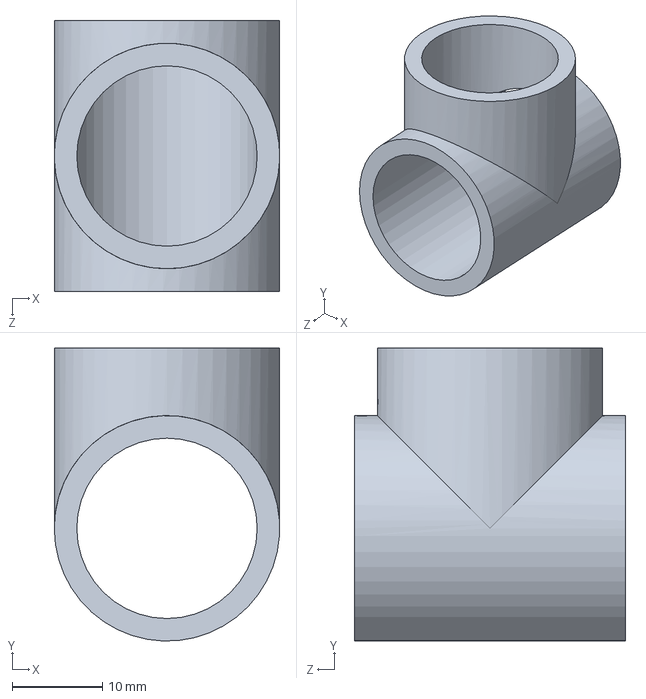
[picture p175: CAD file, 2024-09-17]
大角度冲刷式采收一体莲藕收获装置三维/零件图/短接头三通.SLDPRT
25.0 x 32.5 x 30.0 mm
