wdxzf/High-Angle-Lotus-Harvester/大角度冲刷式采收一体莲藕收获装置三维/零件图/蜗杆1×1.SLDPRT

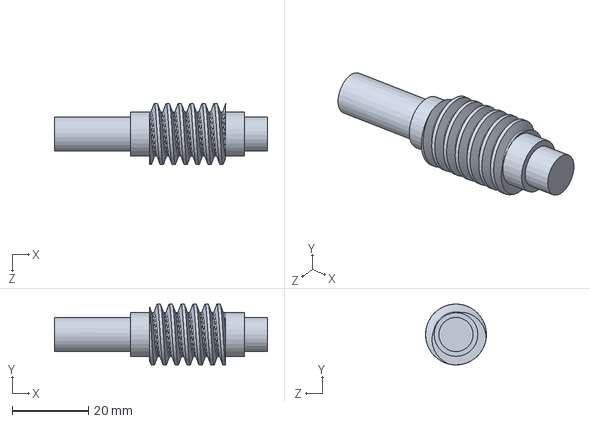
[picture p176: CAD file, 2024-09-17]
大角度冲刷式采收一体莲藕收获装置三维/零件图/蜗杆1×1.SLDPRT
56.0 x 16.0 x 16.0 mm
