wdxzf/High-Angle-Lotus-Harvester/大角度冲刷式采收一体莲藕收获装置三维/零件图/大弯头.SLDPRT

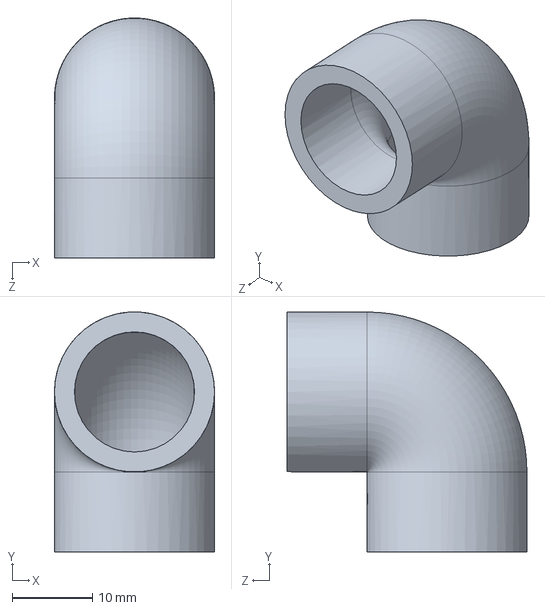
[picture p177: CAD file, 2024-09-17]
大角度冲刷式采收一体莲藕收获装置三维/零件图/大弯头.SLDPRT
20.0 x 30.0 x 30.0 mm
