wdxzf/High-Angle-Lotus-Harvester/大角度冲刷式采收一体莲藕收获装置三维/零件图/10mm螺母.step

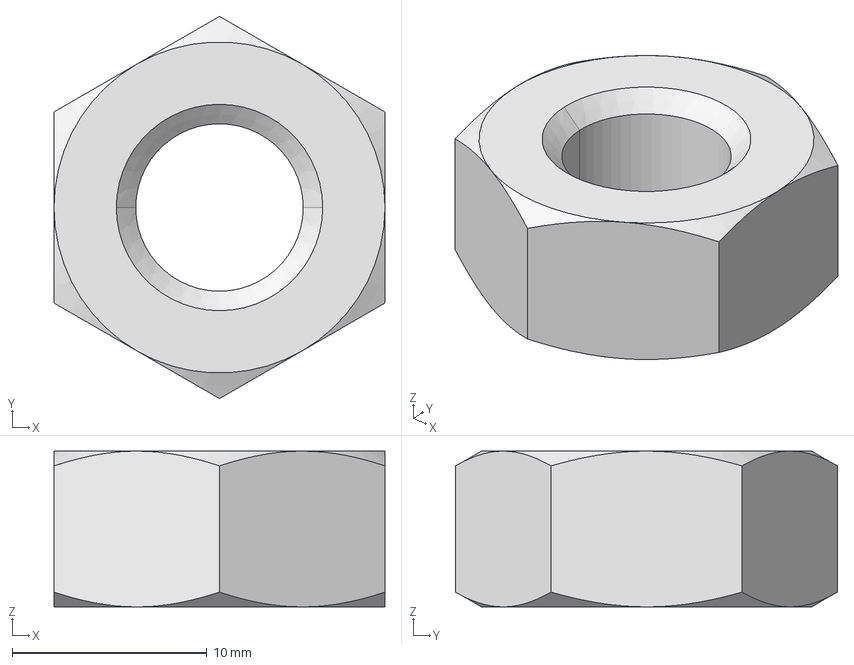
[picture p178: CAD file, 2024-09-17]
大角度冲刷式采收一体莲藕收获装置三维/零件图/10mm螺母.step
17.0 x 19.6 x 8.00 mm
