wdxzf/High-Angle-Lotus-Harvester/大角度冲刷式采收一体莲藕收获装置三维/零件图/上基板.SLDPRT

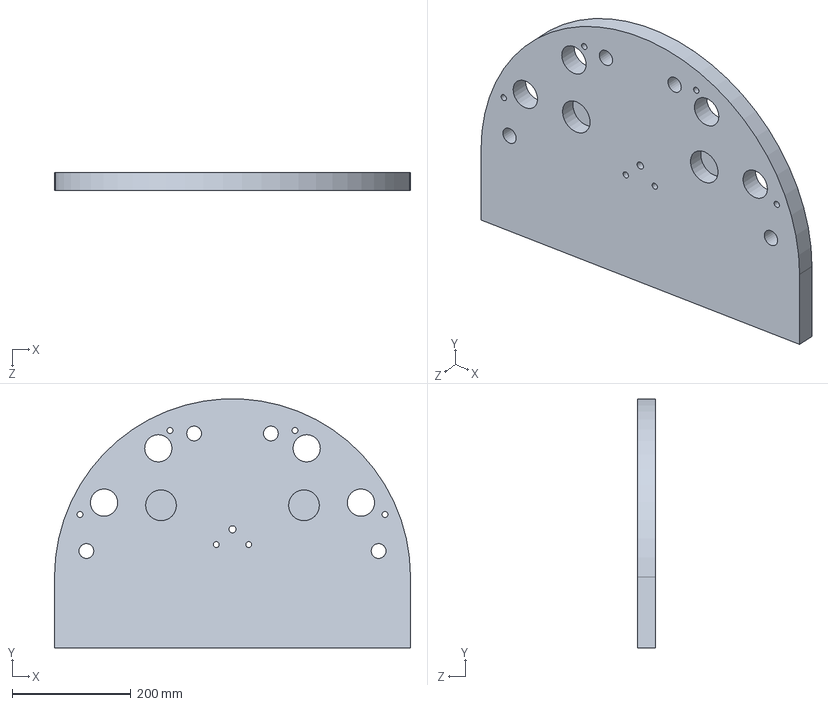
[picture p179: CAD file, 2024-09-17]
大角度冲刷式采收一体莲藕收获装置三维/零件图/上基板.SLDPRT
600.0 x 419.6 x 30.0 mm
