wdxzf/High-Angle-Lotus-Harvester/大角度冲刷式采收一体莲藕收获装置三维/零件图/动力电机座上.SLDPRT

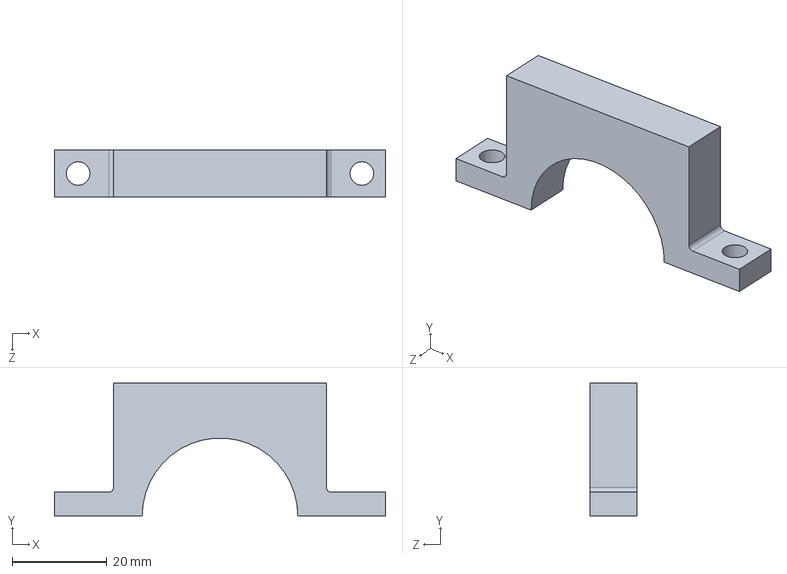
[picture p180: CAD file, 2024-09-17]
大角度冲刷式采收一体莲藕收获装置三维/零件图/动力电机座上.SLDPRT
70.0 x 28.1 x 10.0 mm
