wdxzf/High-Angle-Lotus-Harvester/大角度冲刷式采收一体莲藕收获装置三维/零件图/履带支撑座2.SLDPRT

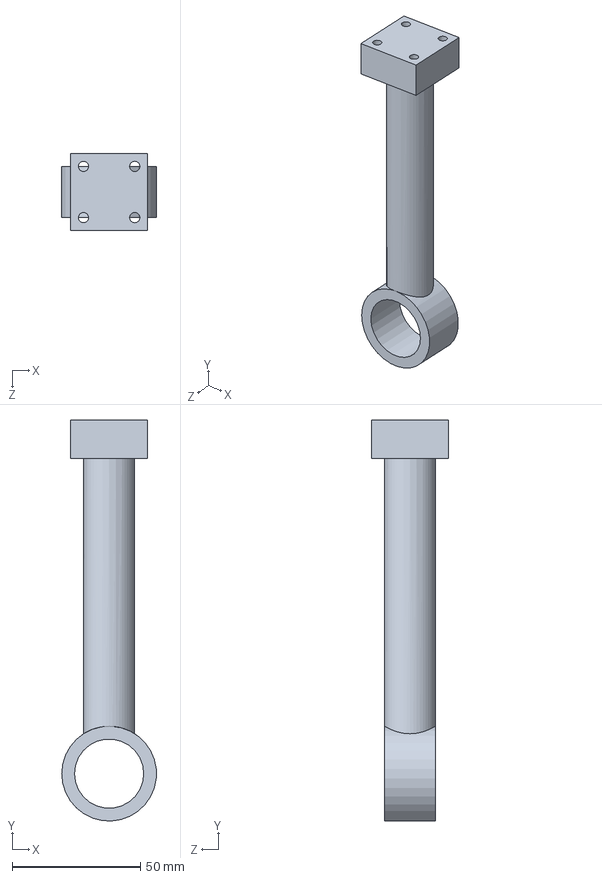
[picture p181: CAD file, 2024-09-17]
大角度冲刷式采收一体莲藕收获装置三维/零件图/履带支撑座2.SLDPRT
36.9 x 156.5 x 30.0 mm
