wdxzf/High-Angle-Lotus-Harvester/大角度冲刷式采收一体莲藕收获装置三维/零件图/导向轴支座.step

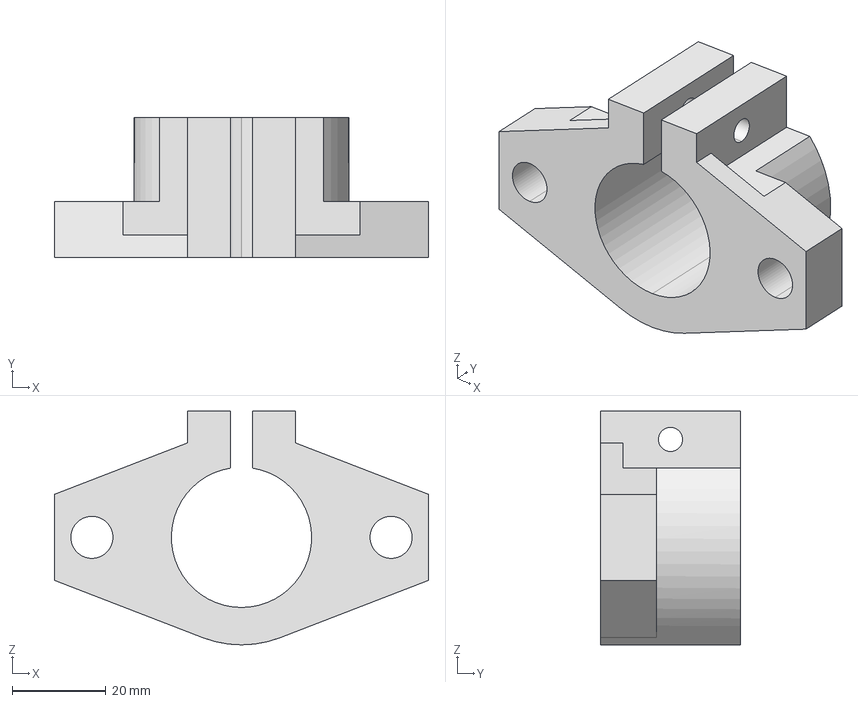
[picture p183: CAD file, 2024-09-17]
大角度冲刷式采收一体莲藕收获装置三维/零件图/导向轴支座.step
80.0 x 30.0 x 50.0 mm
