wdxzf/High-Angle-Lotus-Harvester/大角度冲刷式采收一体莲藕收获装置三维/零件图/推拉杆十字轴新.SLDPRT

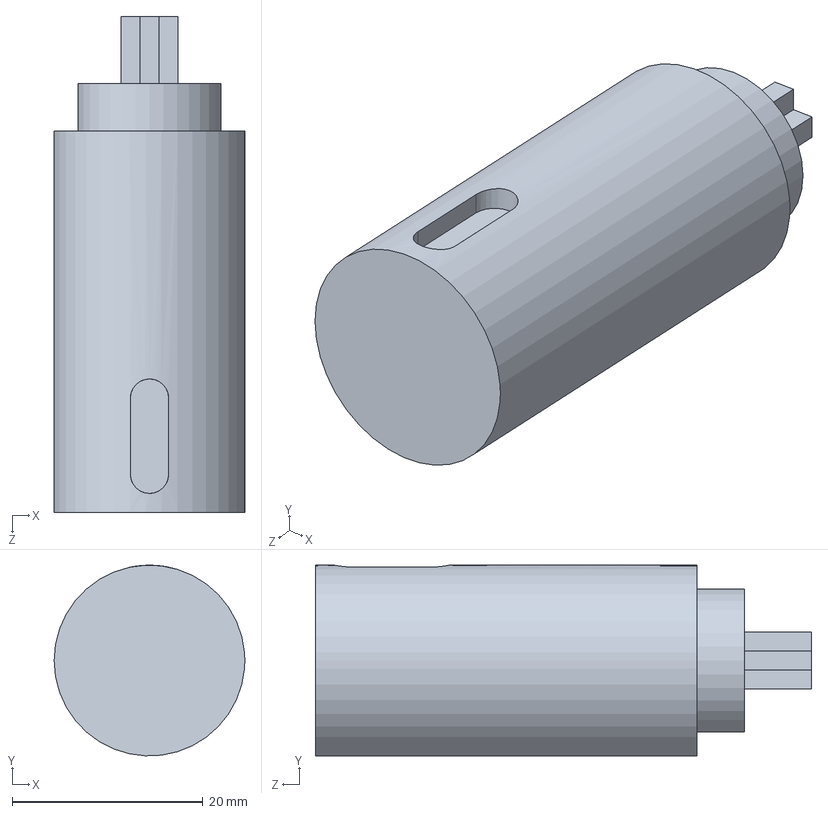
[picture p184: CAD file, 2024-09-17]
大角度冲刷式采收一体莲藕收获装置三维/零件图/推拉杆十字轴新.SLDPRT
20.0 x 20.0 x 52.0 mm
