wdxzf/High-Angle-Lotus-Harvester/大角度冲刷式采收一体莲藕收获装置三维/零件图/推拉杆驱动轮.SLDPRT

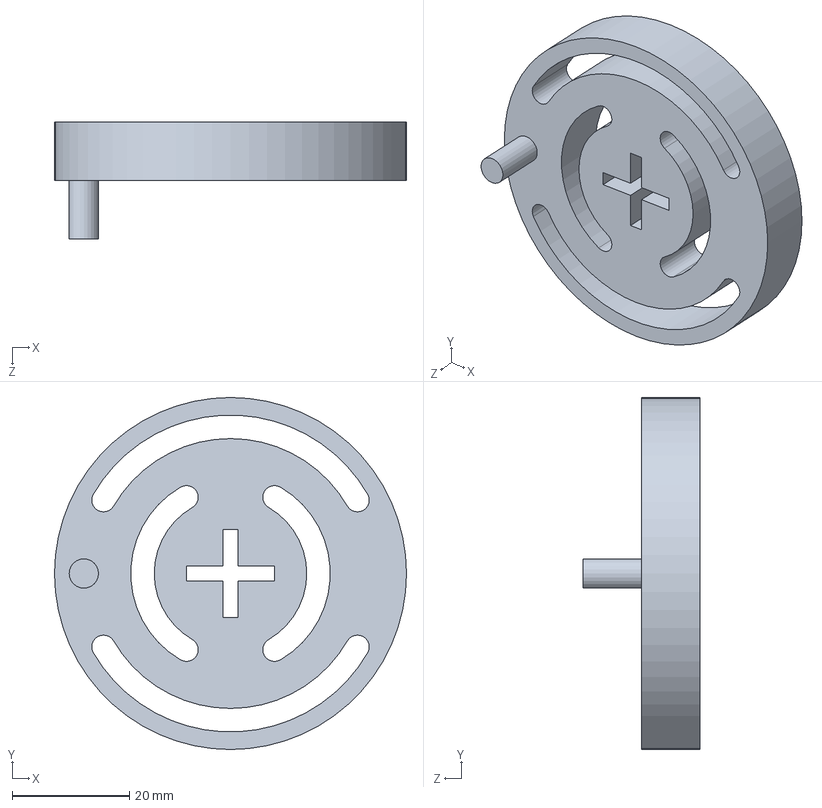
[picture p185: CAD file, 2024-09-17]
大角度冲刷式采收一体莲藕收获装置三维/零件图/推拉杆驱动轮.SLDPRT
60.0 x 60.0 x 20.0 mm
