wdxzf/High-Angle-Lotus-Harvester/大角度冲刷式采收一体莲藕收获装置三维/零件图/法兰.sldprt

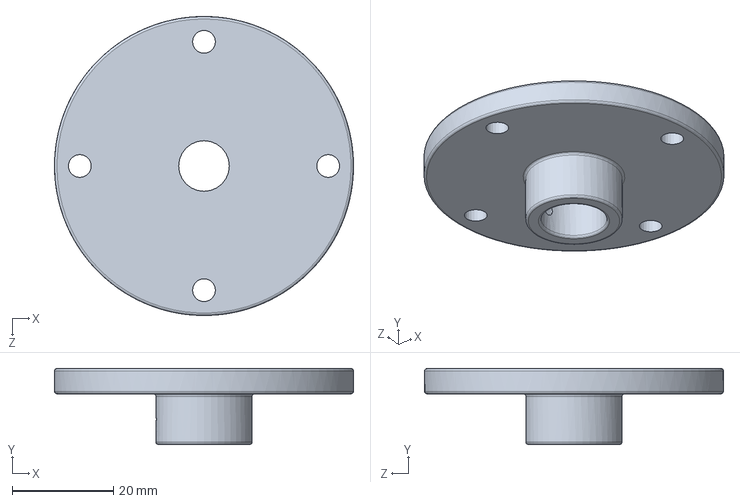
[picture p186: CAD file, 2024-09-17]
大角度冲刷式采收一体莲藕收获装置三维/零件图/法兰.sldprt
59.0 x 15.0 x 59.0 mm
