wdxzf/High-Angle-Lotus-Harvester/大角度冲刷式采收一体莲藕收获装置三维/零件图/管道.SLDPRT

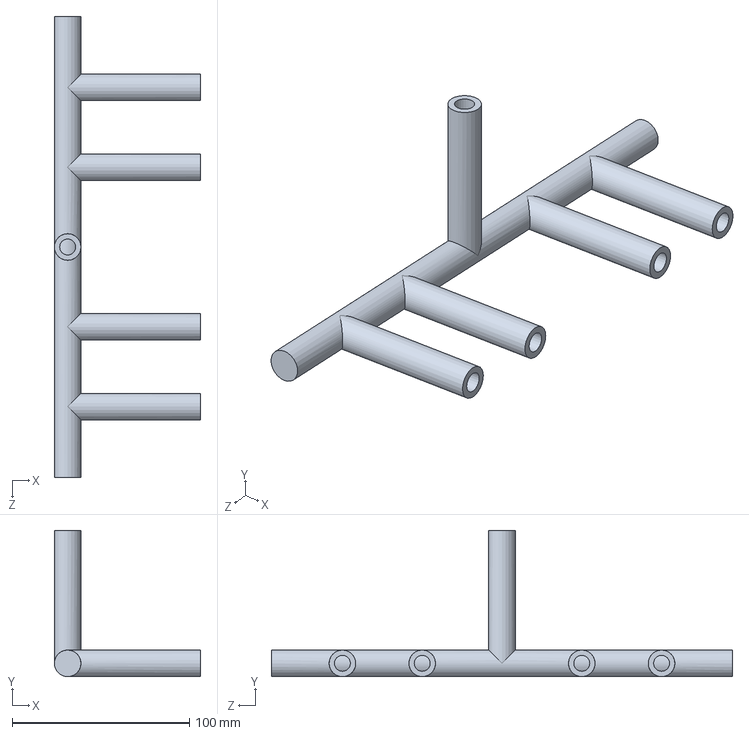
[picture p187: CAD file, 2024-09-17]
大角度冲刷式采收一体莲藕收获装置三维/零件图/管道.SLDPRT
82.5 x 82.5 x 260.0 mm
