wdxzf/High-Angle-Lotus-Harvester/大角度冲刷式采收一体莲藕收获装置三维/零件图/喷管轴承0.step

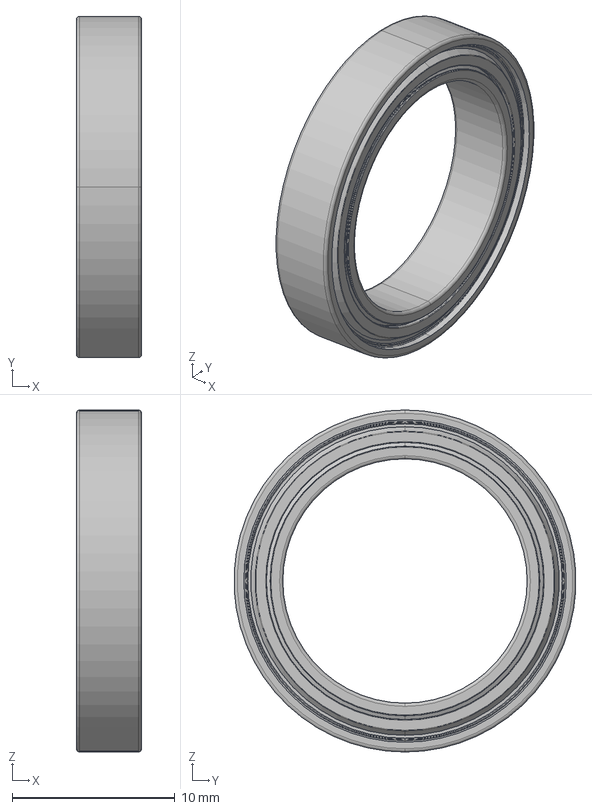
[picture p188: CAD file, 2024-09-17]
大角度冲刷式采收一体莲藕收获装置三维/零件图/喷管轴承0.step
4.00 x 21.0 x 21.0 mm
