wdxzf/High-Angle-Lotus-Harvester/(list of files, cad)

Other CAD files:
大角度冲刷式采收一体莲藕收获装置三维/零件图/外12内10管子.SLDPRT
大角度冲刷式采收一体莲藕收获装置三维/零件图/控制板外壳左上盖0.SLDPRT
大角度冲刷式采收一体莲藕收获装置三维/零件图/固定台高.SLDPRT
大角度冲刷式采收一体莲藕收获装置三维/零件图/右直挡板.SLDPRT
大角度冲刷式采收一体莲藕收获装置三维/零件图/轴.SLDPRT
大角度冲刷式采收一体莲藕收获装置三维/零件图/喷管长.SLDPRT
大角度冲刷式采收一体莲藕收获装置三维/零件图/管子中.SLDPRT
大角度冲刷式采收一体莲藕收获装置三维/零件图/长管子.SLDPRT
大角度冲刷式采收一体莲藕收获装置三维/零件图/尾翼下部分.SLDPRT
大角度冲刷式采收一体莲藕收获装置三维/零件图/右曲挡板.SLDPRT
大角度冲刷式采收一体莲藕收获装置三维/零件图/镜向推力轴承.sldprt
大角度冲刷式采收一体莲藕收获装置三维/零件图/45°弯头.SLDPRT
大角度冲刷式采收一体莲藕收获装置三维/零件图/履带轴承座0.step
大角度冲刷式采收一体莲藕收获装置三维/零件图/电机支座3.SLDPRT
大角度冲刷式采收一体莲藕收获装置三维/零件图/T型导向轴支座.step
大角度冲刷式采收一体莲藕收获装置三维/零件图/angular contact ball bearings gb.sldprt
大角度冲刷式采收一体莲藕收获装置三维/零件图/hexagon socket button head screws gb.sldprt
大角度冲刷式采收一体莲藕收获装置三维/零件图/分水器支架.SLDPRT
大角度冲刷式采收一体莲藕收获装置三维/零件图/右直挡板0.SLDPRT
大角度冲刷式采收一体莲藕收获装置三维/零件图/固定台.SLDPRT
大角度冲刷式采收一体莲藕收获装置三维/零件图/基板.SLDPRT
大角度冲刷式采收一体莲藕收获装置三维/零件图/基板33.SLDPRT
大角度冲刷式采收一体莲藕收获装置三维/零件图/履带6002z轴承座.SLDPRT
大角度冲刷式采收一体莲藕收获装置三维/零件图/履带电机外壳.SLDPRT
大角度冲刷式采收一体莲藕收获装置三维/零件图/履带轴.SLDPRT
大角度冲刷式采收一体莲藕收获装置三维/零件图/抽水泵主体.SLDPRT
大角度冲刷式采收一体莲藕收获装置三维/零件图/接头.SLDPRT
大角度冲刷式采收一体莲藕收获装置三维/零件图/推拉杆垫片.SLDPRT
大角度冲刷式采收一体莲藕收获装置三维/零件图/收集板.SLDPRT
大角度冲刷式采收一体莲藕收获装置三维/零件图/收集装置 驱动圆柱齿轮17×2.5.SLDPRT
大角度冲刷式采收一体莲藕收获装置三维/零件图/收集装置支座.SLDPRT
大角度冲刷式采收一体莲藕收获装置三维/零件图/水泵支架上.SLDPRT
大角度冲刷式采收一体莲藕收获装置三维/零件图/水泵支架下.SLDPRT
大角度冲刷式采收一体莲藕收获装置三维/零件图/游泳圈.SLDPRT
大角度冲刷式采收一体莲藕收获装置三维/零件图/滚针轴承·.step
大角度冲刷式采收一体莲藕收获装置三维/零件图/漏板.SLDPRT
大角度冲刷式采收一体莲藕收获装置三维/零件图/直导柱.SLDPRT
大角度冲刷式采收一体莲藕收获装置三维/零件图/短管.SLDPRT
大角度冲刷式采收一体莲藕收获装置三维/零件图/管.SLDPRT
大角度冲刷式采收一体莲藕收获装置三维/零件图/管00.SLDPRT
大角度冲刷式采收一体莲藕收获装置三维/零件图/螺柱.step
大角度冲刷式采收一体莲藕收获装置三维/零件图/轮轴.SLDPRT
大角度冲刷式采收一体莲藕收获装置三维/零件图/软管接头.SLDPRT
大角度冲刷式采收一体莲藕收获装置三维/零件图/轴承座.SLDPRT
大角度冲刷式采收一体莲藕收获装置三维/零件图/长堵头.SLDPRT
大角度冲刷式采收一体莲藕收获装置三维/零件图/驱动 圆柱齿轮50×2.5.SLDPRT
