wdxzf/High-Angle-Lotus-Harvester/大角度冲刷式采收一体莲藕收获装置二维图/零件工程图/上基板-模型.pdf

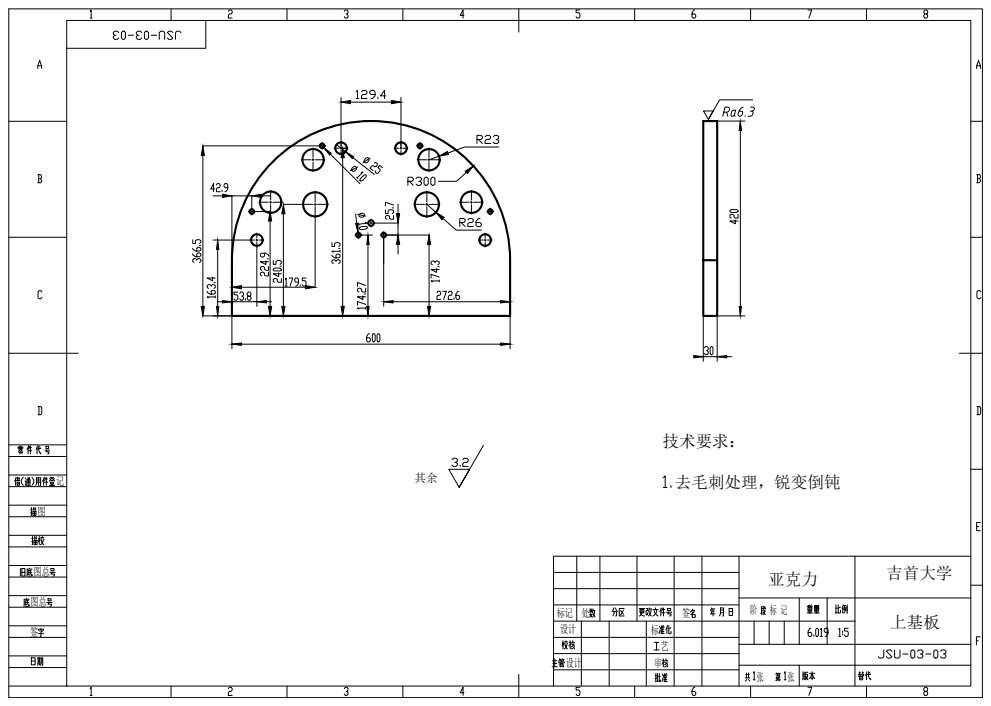
[picture p189: page 1]

亚克力 | 吉首大学

上基板
