wdxzf/High-Angle-Lotus-Harvester/大角度冲刷式采收一体莲藕收获装置二维图/零件工程图/上电机座壳-模型.pdf

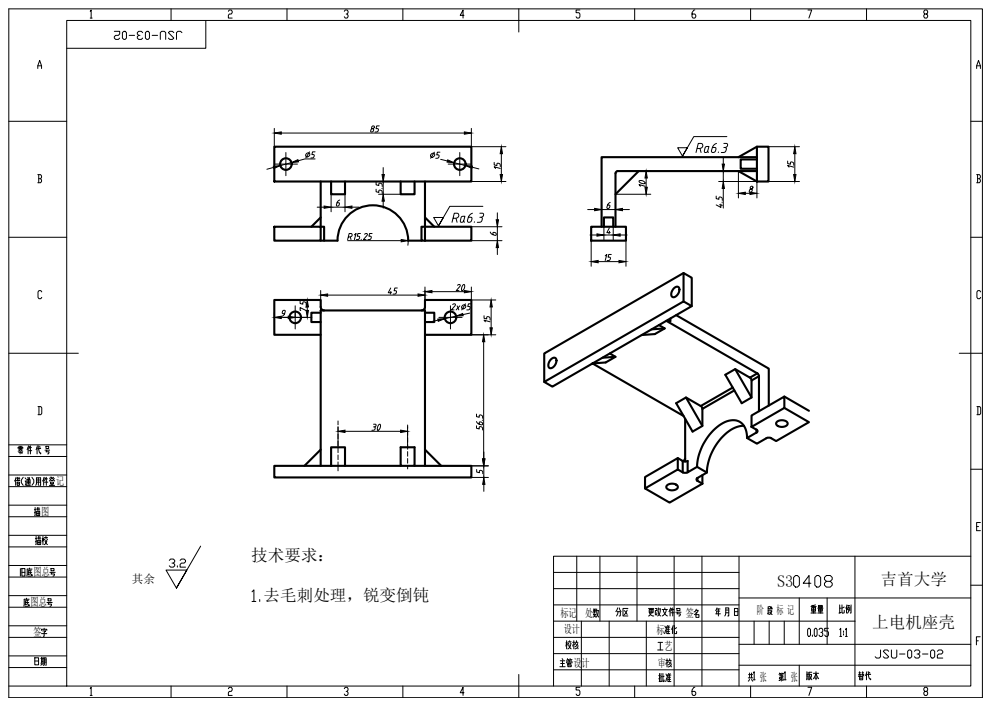
[picture p191: page 1]
图总图 记

吉首大学

上电机座壳
