wdxzf/High-Angle-Lotus-Harvester/大角度冲刷式采收一体莲藕收获装置二维图/零件工程图/喷管连接头-模型.pdf

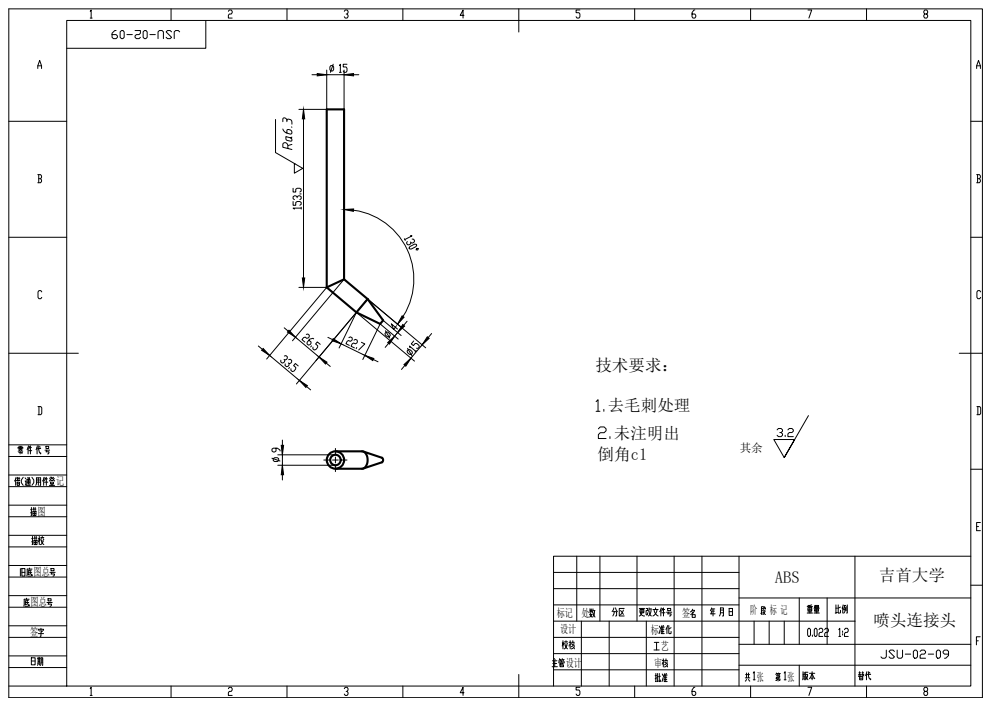
[picture p194: page 1]

ABS | 吉首大学

喷头连接头
