wdxzf/High-Angle-Lotus-Harvester/大角度冲刷式采收一体莲藕收获装置二维图/零件工程图/固定台-模型.pdf

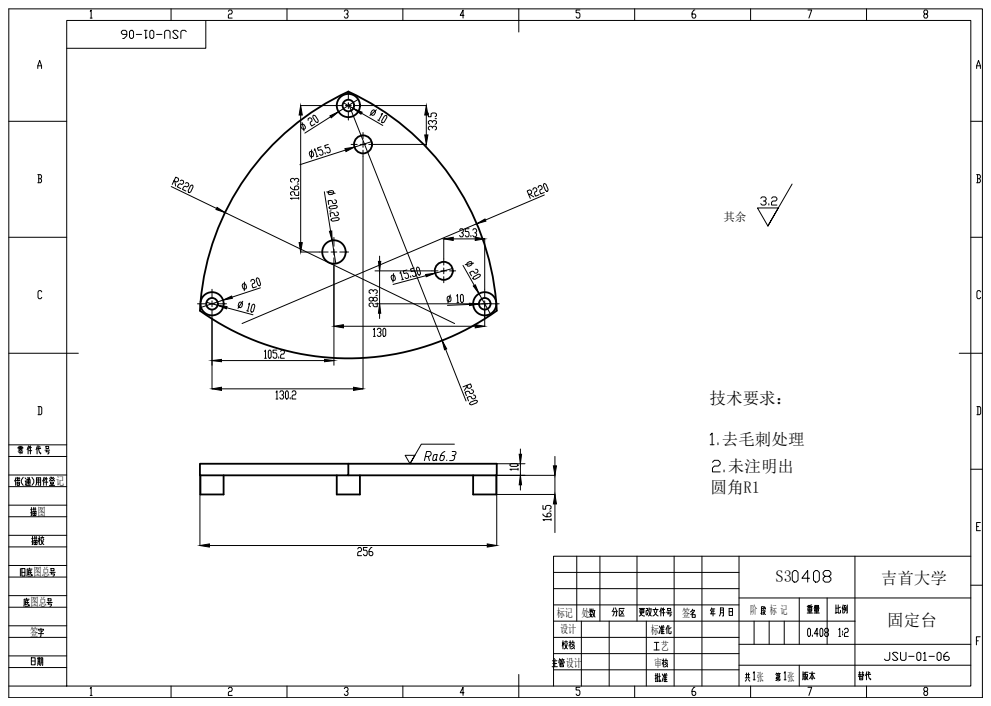
[picture p196: page 1]

S3 | 吉首大学

固定台
