wdxzf/High-Angle-Lotus-Harvester/大角度冲刷式采收一体莲藕收获装置二维图/零件工程图/圆柱齿轮60×2.5-模型.pdf

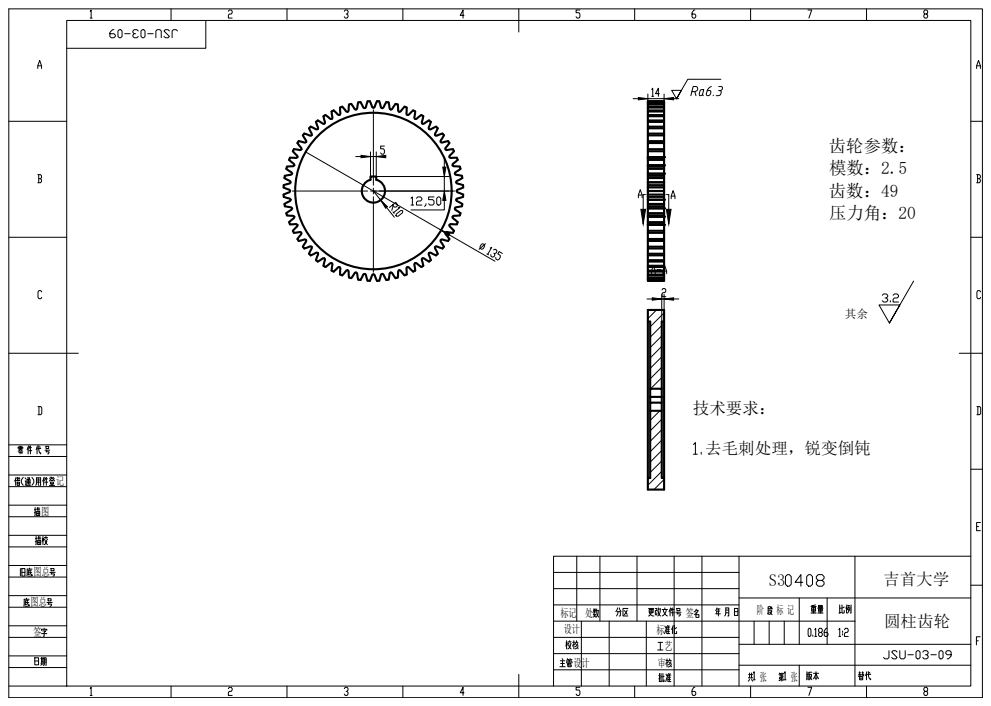
[picture p199: page 1]
图总图 记

S3 | 吉首大学

圆柱齿轮
