wdxzf/High-Angle-Lotus-Harvester/大角度冲刷式采收一体莲藕收获装置二维图/零件工程图/基板-模型.pdf

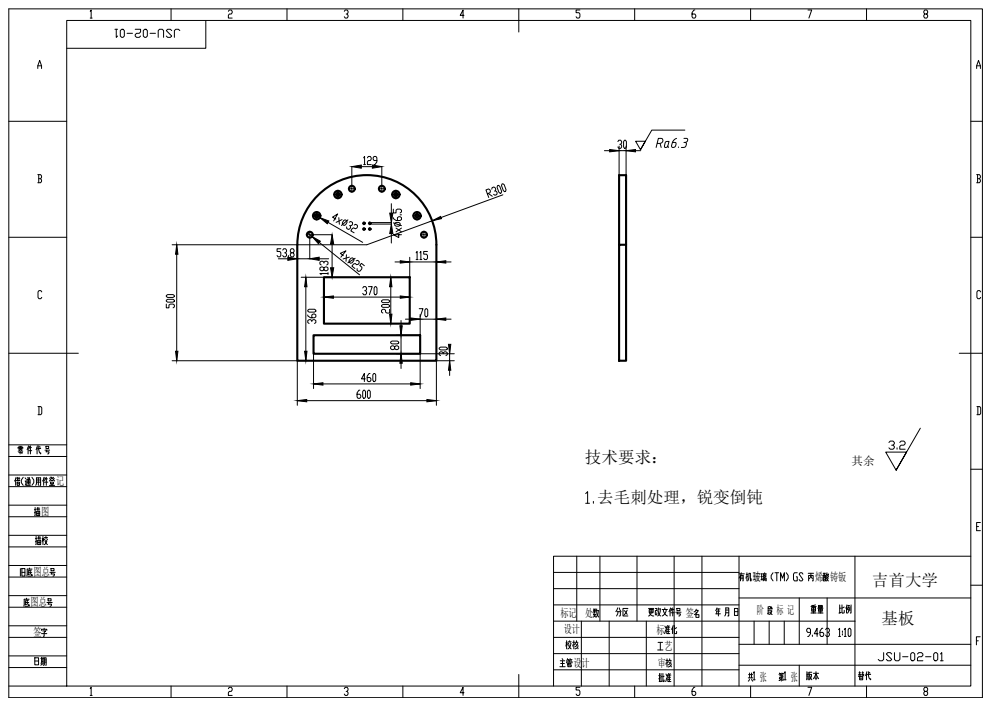
[picture p201: page 1]
图总图 记; 吉首大学
