wdxzf/High-Angle-Lotus-Harvester/大角度冲刷式采收一体莲藕收获装置二维图/零件工程图/套筒-模型.pdf

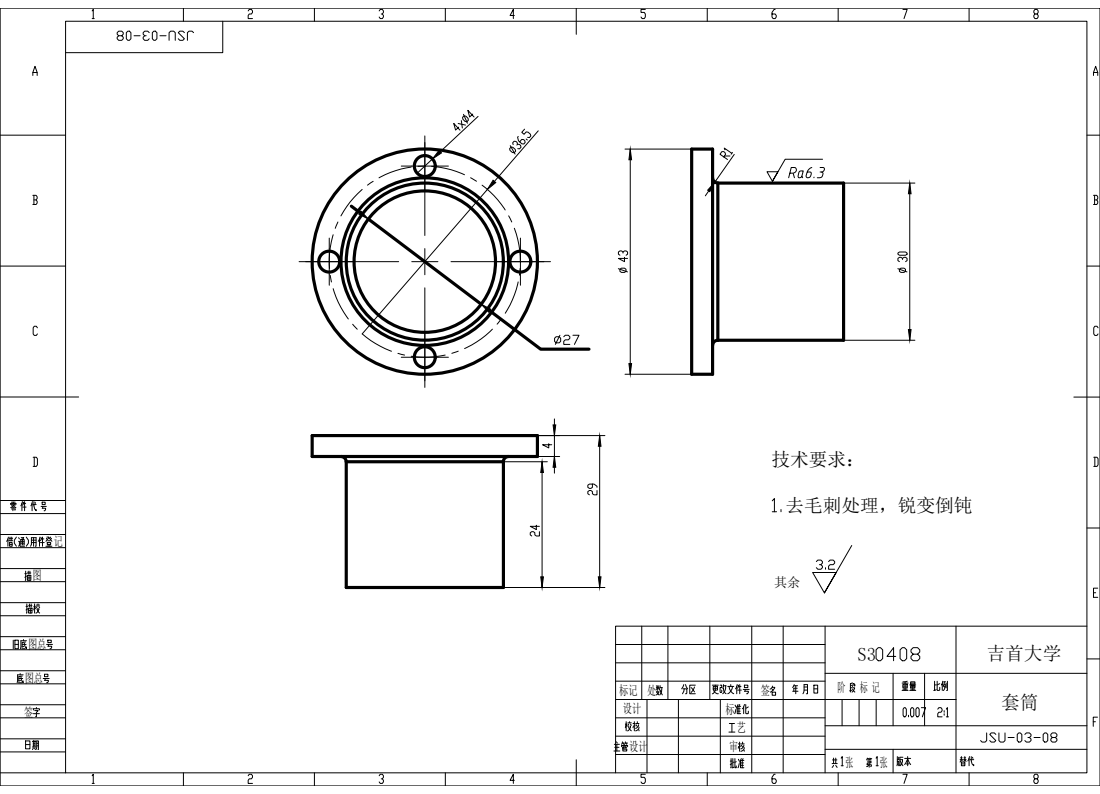
[picture p205: page 1]
张 签图总图总图; 技术要求： 去毛刺处理，锐变倒钝 吉首大学 套筒 其余
