wdxzf/High-Angle-Lotus-Harvester/大角度冲刷式采收一体莲藕收获装置二维图/零件工程图/电池外壳-模型.pdf

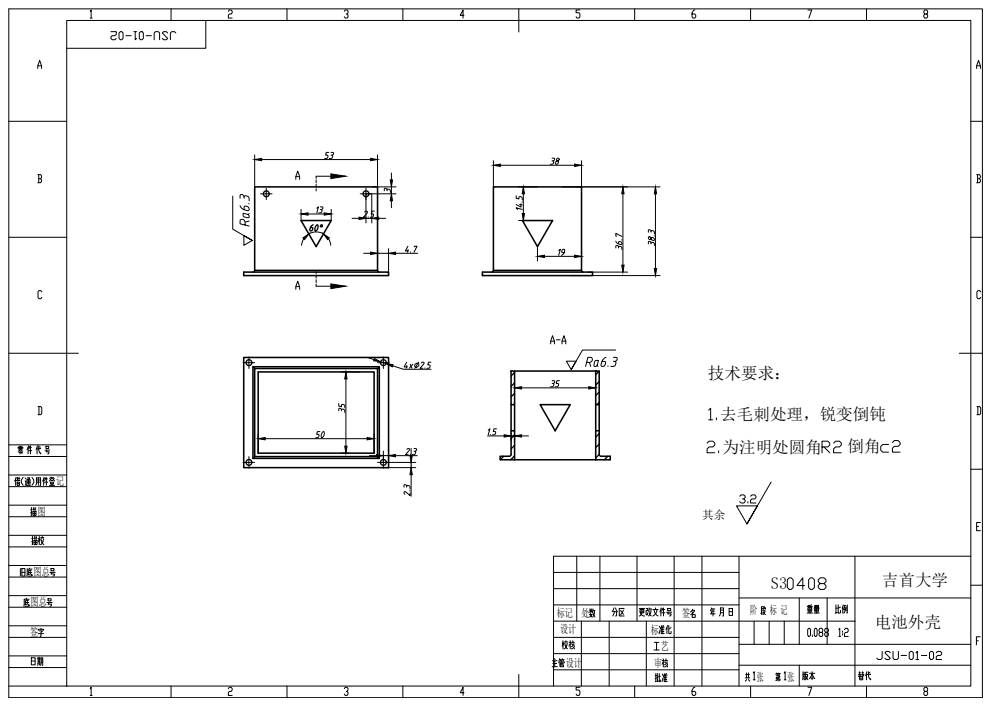
[picture p212: page 1]

S3 | 吉首大学

电池外壳
