wdxzf/High-Angle-Lotus-Harvester/大角度冲刷式采收一体莲藕收获装置二维图/零件工程图/管子  圆柱齿轮17×2.5-模型.pdf

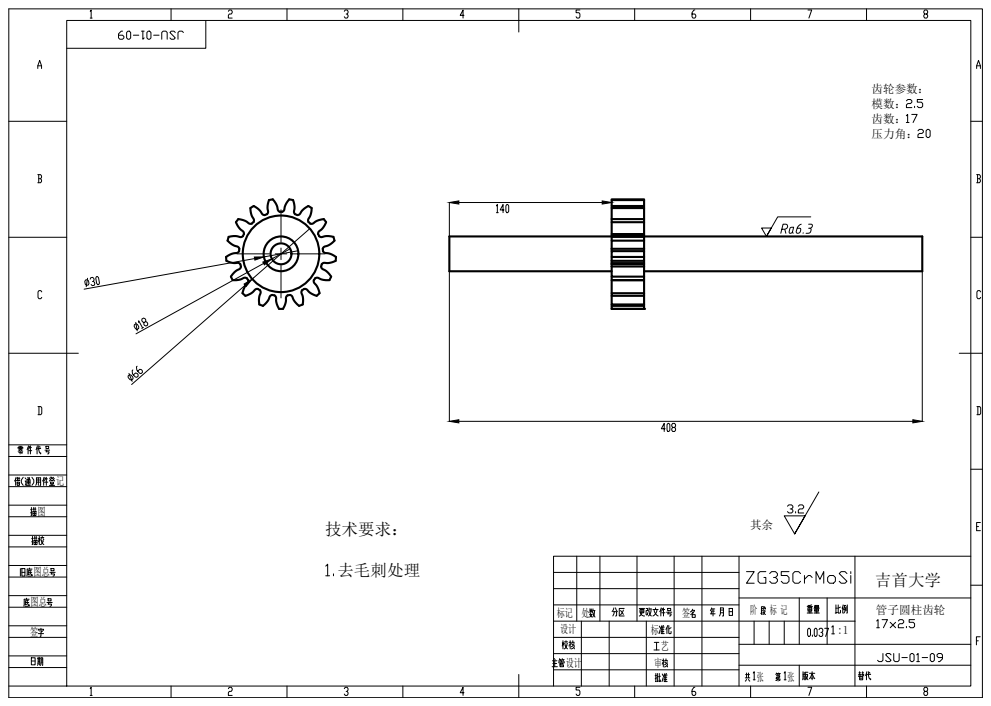
[picture p213: page 1]
