wdxzf/High-Angle-Lotus-Harvester/大角度冲刷式采收一体莲藕收获装置二维图/零件工程图/轮轴-模型.pdf

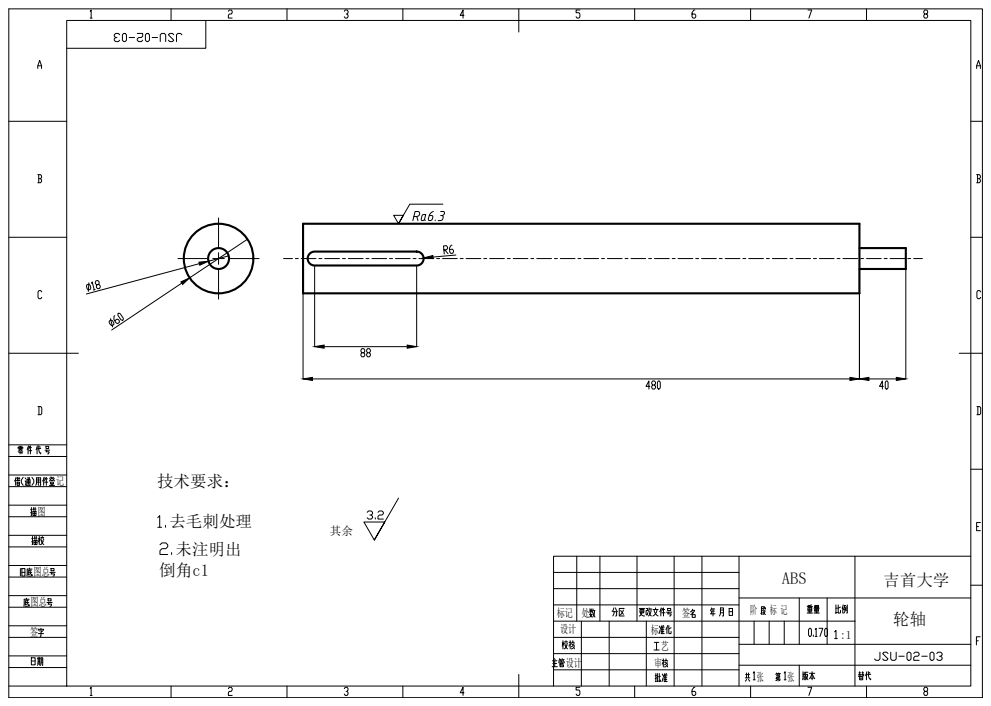
[picture p214: page 1]

ABS
