wdxzf/High-Angle-Lotus-Harvester/大角度冲刷式采收一体莲藕收获装置二维图/零件工程图/钩子-模型.pdf

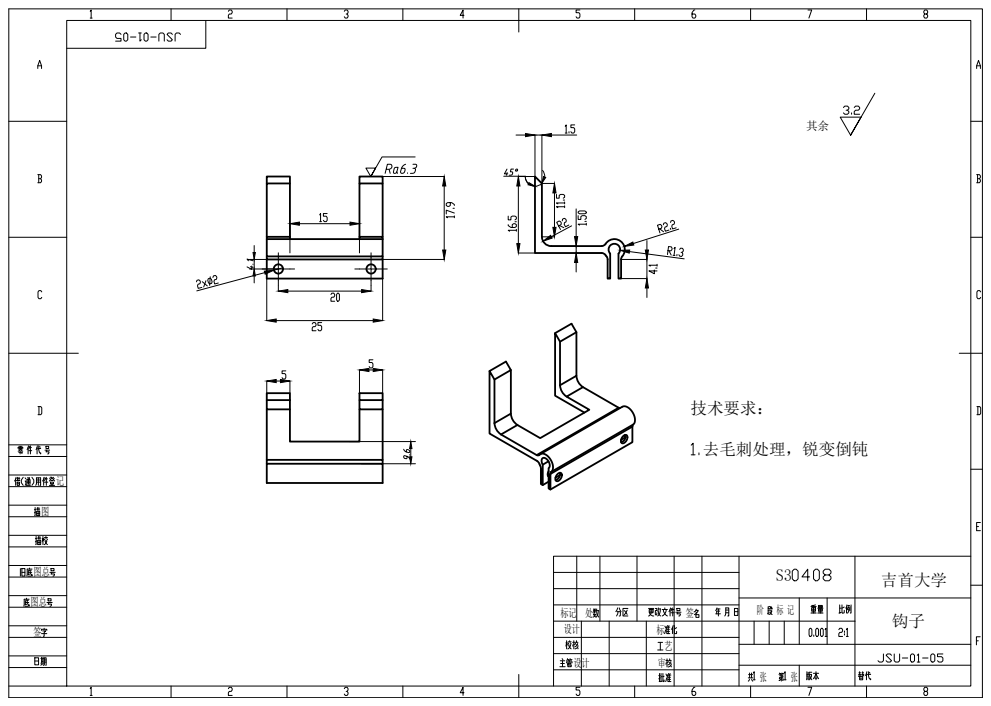
[picture p216: page 1]

S3 | 吉首大学
